Alexandr-Filatov/EVD80_MCU_PCB/DataSheets/ADC_Pins.jpeg

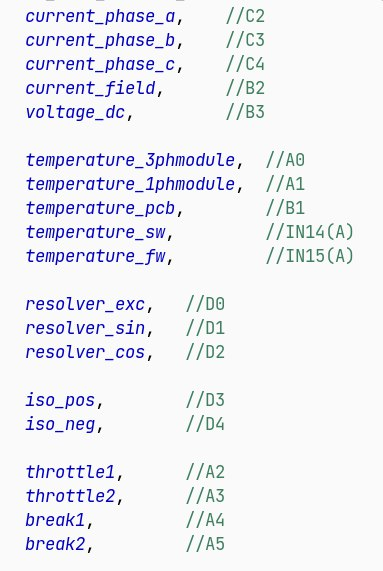
DataSheets/ADC_Pins.jpeg
