Alexandr-Filatov/EVD80_MCU_PCB/bom/EVD80_ControlBoard.xls

Reference | Value | Product Name | Replacement | Description P/N | Footprint | Qty | DNP
C1,C178 | 100n |  |  | Capacitor 50V | Capacitor_SMD:C_0805_2012Metric | 2
C2,C3,C4,C5,C6,C7,C8,C9 | 10u |  |  | Capacitor 25V | Capacitor_SMD:C_0805_2012Metric | 8
C10,C14,C22,C24,C26,C37,C39,C40,C42,C43,C44,C45,C46,C47,C48,C49,C50,C51,C52,C53,C54,C55,C56,C57,C58,C59,C60,C63,C69,C70,C74,C86,C87,C88,C98,C99,C100,C105,C106,C109,C110,C111,C112,C125,C133,C135,C136,C139,C146,C147,C150,C151,C154,C155,C158,C159,C181,C182,C187,C188,C190,C193,C194,C201,C202,C205,C206,C208,C217,C223,C224,C228 | 100n |  |  | Capacitor 50V | Capacitor_SMD:C_0603_1608Metric | 72
C11,C12,C13,C17,C103,C141,C179,C180,C207,C209 | 1u |  |  | Capacitor 25V | Capacitor_SMD:C_0603_1608Metric | 10
C15,C16,C18,C19,C20,C21,C23,C25,C27,C29,C30,C31,C32,C34,C35,C36,C38,C41,C142,C143 | 2.2u |  |  | Capacitor 25V | Capacitor_SMD:C_0603_1608Metric | 20
C28,C33,C185,C186,C191,C192 | 10u |  |  | Capacitor 25V | Capacitor_SMD:C_0603_1608Metric | 6
C61,C62 | 30p |  |  | Capacitor 50V | Capacitor_SMD:C_0805_2012Metric | 2
C64,C65,C66 | 22u |  |  | Capacitor 50V | Capacitor_Tantalum_SMD:CP_EIA-7360-38_Kemet-E | 3
C67,C115,C116,C117,C118,C119,C120,C121,C123,C126,C127,C162,C163,C164,C168,C169,C170,C174,C175,C213,C214,C257,C258,C259,C260 | 100n |  |  | Capacitor 50V | Capacitor_SMD:C_1206_3216Metric | 25
C68 | 560p |  |  | Capacitor 50V | Capacitor_SMD:C_0603_1608Metric | 1
C71,C241 | 100n |  |  | Capacitor 50V | Capacitor_SMD:C_0805_2012Metric_Pad1.18x1.45mm_HandSolder | 2
C72 | 47n |  |  | Capacitor 50V | Capacitor_SMD:C_0603_1608Metric | 1
C73 | 820p |  |  | Capacitor 50V | Capacitor_SMD:C_0603_1608Metric_Pad1.08x0.95mm_HandSolder | 1
C75,C79,C107,C108,C122,C124,C165,C166,C167,C171,C172,C173,C176,C177,C197,C198,C199,C200,C215,C216,C219,C220,C221,C222 | 10n |  |  | Capacitor 50V | Capacitor_SMD:C_0603_1608Metric | 24
C76,C77 | 1u |  |  | Capacitor 50V | Capacitor_SMD:C_0805_2012Metric_Pad1.18x1.45mm_HandSolder | 2
C78 | 100n |  |  | Capacitor 50V | Capacitor_SMD:C_0603_1608Metric_Pad1.08x0.95mm_HandSolder | 1
C80,C195,C196 | 47u |  |  | Capacitor 35V | Capacitor_Tantalum_SMD:CP_EIA-7360-38_Kemet-E | 3
C81,C82 | 0.47u |  |  | Capacitor 50V | Capacitor_SMD:C_1206_3216Metric | 2
C83,C84,C85 | 1000p |  |  | Capacitor 50V | Capacitor_SMD:C_0603_1608Metric | 3
C89,C90,C91,C92,C93,C94 | 330p |  |  | Capacitor 50V | Capacitor_SMD:C_0603_1608Metric | 6
C95,C96,C97 | 47p |  |  | Capacitor 50V | Capacitor_SMD:C_0603_1608Metric | 3
C101 | 0.1u |  |  | Capacitor 50V | Capacitor_SMD:C_0603_1608Metric | 1
C102,C203,C204,C212,C225,C226 | 4.7n |  |  | Capacitor 50V | Capacitor_SMD:C_0603_1608Metric | 6
C104 | 1n |  |  | Capacitor 50V | Capacitor_SMD:C_0603_1608Metric | 1
C113,C114,C128,C129,C132,C148,C149,C156,C157,C227 | 10p |  |  | Capacitor 50V | Capacitor_SMD:C_0603_1608Metric | 10
C130,C131,C134,C140,C152,C153,C160,C161,C183,C184,C229 | 0.22u |  |  | Capacitor 16V | Capacitor_SMD:C_0603_1608Metric | 11
C137,C138 | 4700p |  |  | Capacitor 50V | Capacitor_SMD:C_0603_1608Metric | 2
C144,C145,C218,C231,C232,C233,C235,C238,C239,C240,C255,C256 | 100p |  |  | Capacitor 50V | Capacitor_SMD:C_0603_1608Metric | 12
C189 | 4.7u |  |  | Capacitor 10V | Capacitor_SMD:C_0603_1608Metric | 1
C210,C211 | 82p |  |  | Capacitor 50V | Capacitor_SMD:C_0603_1608Metric | 2
C230,C234,C236,C237,C251,C252,C253,C254 | 27p |  |  | Capacitor 50V | Capacitor_SMD:C_0603_1608Metric | 8
D1,D2,D47,D48,D49,D50,D54 |  | FYLS-0805UBC |  | LED | LED_SMD:LED_0805_2012Metric | 7
D3 |  | SN74LVC1G11DBVR |  | SN74LVC1G11DBVR | Package_TO_SOT_SMD:SOT-23-6_Handsoldering | 1
D4,D5 |  | FYLS-0805UBC |  | LED | LED_SMD:LED_0805_2012Metric_Pad1.15x1.40mm_HandSolder | 2
D6,D8,D10,D11,D12,D20,D21,D22,D24,D25,D26,D27,D28,D29,D30,D31,D32,D33,D39,D40,D41,D42,D43,D45,D51,D52 |  | BAT54S |  | Schottky Barrier Diode | Package_TO_SOT_SMD:SOT-23 | 26
D7,D9 |  | STPS20M100S |  | Schottky Diode | Package_TO_SOT_SMD:TO-263-2 | 2
D13,D14,D15,D16,D17,D18 |  | BAV99 |  |  | Package_TO_SOT_SMD:SOT-23 | 6
D23 |  | PESD2CAN |  |  | Package_TO_SOT_SMD:SOT-23 | 1
D34,D35,D36,D37,D38 |  | SS16 |  | Schottky Diode | Diode_SMD:D_SMA | 5
D44,D46 |  | SS16 |  | Schottky Diode | Diode_SMD:D_SMA | 2
J1 |  | DS1021-2x7SF11-B |  | Connector | Connector_PinHeader_2.54mm:PinHeader_2x07_P2.54mm_Vertical | 1
J2 |  | 776163-1 |  | Connector | Project_Library:TE_776163-1 | 1
J3 |  | SCT3001WR-2x04P |  | Connector | Connector_Molex:Molex_Micro-Fit_3.0_43045-0800_2x04_P3.00mm_Horizontal | 1
J4,J5,J6,J9 |  | SCT3001WR-2x06P |  | Connector | Connector_Molex:Molex_Micro-Fit_3.0_43045-1200_2x06_P3.00mm_Horizontal | 4
J10 |  | DS1021-1x5SF11-B |  | Connector | Connector_PinHeader_2.54mm:PinHeader_1x05_P2.54mm_Vertical | 1
J11 |  | SCT3001WR-2x05P |  | Connector | Connector_Molex:Molex_Micro-Fit_3.0_43045-1000_2x05_P3.00mm_Horizontal | 1
K1,K2 |  | 1393217-1 |  | Relay | Relay_THT:Relay_SPST_Finder_32.21-x300 | 2
L1,L2 | 10u | DFE252012F-100M=P2 |  | Inductor | Inductor_SMD:L_1008_2520Metric | 2
L3,L4 | 220R | BLM18HB221SN1D |  | Inductor | Inductor_SMD:L_0603_1608Metric | 2
L5,L6 | 60R | BLM18BB600SN1D |  | Inductor | Inductor_SMD:L_0603_1608Metric | 2
L7 | 22 uH | SRP1245A |  | Inductor | Inductor_SMD:L_Bourns_SRP1245A | 1
L8,L11,L13,L14,L15,L16,L17,L18,L19,L20,L21,L22,L23,L24,L25,L26 | 1 uH | LQM21PN1R0MC0D |  | Inductor | Inductor_SMD:L_0805_2012Metric | 16
L9,L10,L12 |  | ACM2520-2P |  | Inductor | Project_Library:ACM2520-2P_TDK | 3
Q1 |  | STB35NF10 | IRF3710STRLPBF | Transistor | Package_TO_SOT_SMD:TO-263-2 | 1
Q2 |  | BC858 |  | Transistor | Package_TO_SOT_SMD:SOT-23 | 1
Q3 |  | SUD50N04 | FDD8447L | Transistor | Package_TO_SOT_SMD:TO-252-2 | 1
Q4,Q5,Q6,Q9,Q11,Q13,Q14,Q15,Q16,Q17,Q18,Q19 | BC817 | BC817 |  | Transistor | Package_TO_SOT_SMD:SOT-23 | 12
Q7,Q8,Q10,Q12 | BC807 | BC807 |  | Transistor | Package_TO_SOT_SMD:SOT-23 | 4
R1,R29,R148,R149,R150,R160,R161,R162,R170,R171,R237,R238,R239,R240,R263,R273,R275,R276 | 100 |  |  | Resistor | Resistor_SMD:R_0603_1608Metric | 18
R2,R8,R30,R39,R58,R60,R194,R195,R200,R201,R203,R213,R264,R265,R266,R270,R271,R272,R279,R281 | 1k |  |  | Resistor | Resistor_SMD:R_0603_1608Metric | 20
R3,R124,R125 | 4.99k |  |  | Resistor | Resistor_SMD:R_0603_1608Metric | 3
R4 | 150 |  |  | Resistor | Resistor_SMD:R_0805_2012Metric | 1
R5,R223,R224,R225,R226 | 680 |  |  | Resistor | Resistor_SMD:R_0805_2012Metric | 5
R6,R284 | 1k |  |  | Resistor | Resistor_SMD:R_0805_2012Metric | 2
R7,R241,R242,R245,R261,R262,R267,R268,R269,R274,R277,R278,R280 | 120 |  |  | Resistor | Resistor_SMD:R_0603_1608Metric | 13
R9,R10,R127,R128 | 0.1R |  |  | Resistor | Resistor_SMD:R_0603_1608Metric | 4
R11,R17,R19,R129,R151,R152,R153,R163,R164,R165,R172,R173 | DNP |  |  | Resistor | Resistor_SMD:R_0603_1608Metric | 12
R12,R16,R18,R92,R93,R248,R249 | 2.2k |  |  | Resistor | Resistor_SMD:R_0603_1608Metric | 7
R13,R14,R26,R61,R77,R78,R79,R80,R202 | 4.7k |  |  | Resistor | Resistor_SMD:R_0603_1608Metric | 9
R15 | 1M |  |  | Resistor | Resistor_SMD:R_0805_2012Metric | 1
R20 | 4.7k |  |  | Resistor | Resistor_SMD:R_0805_2012Metric_Pad1.20x1.40mm_HandSolder | 1
R21 | 36k |  |  | Resistor | Resistor_SMD:R_0603_1608Metric | 1
R22 | 7.5k |  |  | Resistor | Resistor_SMD:R_0603_1608Metric | 1
R23 | 3k |  |  | Resistor | Resistor_SMD:R_0805_2012Metric_Pad1.20x1.40mm_HandSolder | 1
R24 | 18.7k |  |  | Resistor | Resistor_SMD:R_0603_1608Metric | 1
R25 | 300k |  |  | Resistor | Resistor_SMD:R_0603_1608Metric | 1
R27 | 13k |  |  | Resistor | Resistor_SMD:R_0603_1608Metric | 1
R28 | 1M |  |  | Resistor | Resistor_SMD:R_0603_1608Metric | 1
R31,R196,R197 | 11k |  |  | Resistor | Resistor_SMD:R_0603_1608Metric | 3
R32 | 200 |  |  | Resistor | Resistor_SMD:R_0603_1608Metric | 1
R33,R43,R44,R45,R48,R49,R50,R51,R52,R53,R54,R62,R63,R66,R68,R71,R72,R73,R74,R98,R100,R104,R130,R132,R136,R138,R192,R193,R204,R205,R212,R214,R215,R222,R256 | 10k |  |  | Resistor | Resistor_SMD:R_0603_1608Metric | 35
R34,R59,R65 | 3.9k |  |  | Resistor | Resistor_SMD:R_0603_1608Metric | 3
R35 | 20 mOm |  |  | Resistor | Resistor_SMD:R_2512_6332Metric | 1
R36,R40,R41,R42 | 2k |  |  | Resistor | Resistor_SMD:R_0603_1608Metric | 4
R37,R38 | 510 |  |  | Resistor | Resistor_SMD:R_0603_1608Metric | 2
R46,R47 | 100k |  |  | Resistor | Resistor_SMD:R_0603_1608Metric | 2
R55,R56,R57 | 47k |  |  | Resistor | Resistor_SMD:R_0603_1608Metric | 3
R64,R131,R133,R137,R139 | 15k |  |  | Resistor | Resistor_SMD:R_0603_1608Metric | 5
R67 | 20 |  |  | Resistor | Resistor_SMD:R_0603_1608Metric | 1
R69,R70 | 51k |  |  | Resistor | Resistor_SMD:R_0603_1608Metric | 2
R75,R76 | 510k |  |  | Resistor | Resistor_SMD:R_0603_1608Metric | 2
R81,R82,R83,R84 | 10 |  |  | Resistor | Resistor_SMD:R_0603_1608Metric | 4
R85,R86,R87,R88,R89,R90,R91,R94,R96,R97,R246,R247,R260,R282,R283,R305 | DNP |  |  | Resistor | Resistor_SMD:R_0805_2012Metric | 16
R95,R106,R107,R109,R250,R251,R252,R253 | 30.1k |  |  | Resistor | Resistor_SMD:R_0603_1608Metric | 8
R99,R101,R105,R257 | 16k |  |  | Resistor | Resistor_SMD:R_0603_1608Metric | 4
R102,R103,R108,R126,R134,R135,R140,R141,R198,R199,R227,R228,R254,R255,R258 | 49.9 |  |  | Resistor | Resistor_SMD:R_0603_1608Metric | 15
R110,R111,R112,R113,R114,R115,R116,R117,R118,R119,R120,R121 | 249k |  |  | Resistor | Resistor_SMD:R_1206_3216Metric | 12
R122,R123 | 3.74k |  |  | Resistor | Resistor_SMD:R_0603_1608Metric | 2
R142,R144,R146,R154,R156,R158,R166,R168 | 4.99k |  |  | Resistor | Resistor_SMD:R_0805_2012Metric | 8
R143,R145,R147,R155,R157,R159,R167,R169 | 3k |  |  | Resistor | Resistor_SMD:R_0805_2012Metric | 8
R174,R175,R183,R184,R185 | 4.7k |  |  | Resistor | Resistor_SMD:R_0805_2012Metric | 5
R176,R177,R182,R186,R187,R188 | 10K |  |  | Resistor | Resistor_SMD:R_0805_2012Metric | 6
R178 | 510 |  |  | Resistor | Resistor_SMD:R_0805_2012Metric | 1
R179 | 330 |  |  | Resistor | Resistor_SMD:R_0805_2012Metric | 1
R180,R181,R189,R190,R191 | 220 |  |  | Resistor | Resistor_SMD:R_0805_2012Metric | 5
R206,R216 | 5.11k |  |  | Resistor | Resistor_SMD:R_0603_1608Metric | 2
R207,R208,R209,R210,R211,R217,R218,R219,R220,R221 | 240k |  |  | Resistor | Resistor_SMD:R_1206_3216Metric | 10
R229,R230,R231,R232,R233,R234,R235,R236 | 560 |  |  | Resistor | Resistor_SMD:R_0603_1608Metric | 8
R243,R244 | 59 |  |  | Resistor | Resistor_SMD:R_0603_1608Metric | 2
R259,R285,R286,R287,R288,R289,R290,R291,R292,R293,R294,R295,R296,R297,R298,R299,R300,R301,R302,R303,R304 | 0 |  |  | Resistor | Resistor_SMD:R_0603_1608Metric | 21
TH1 |  | NCP21XV103J03RA |  | NTC | Resistor_SMD:R_0805_2012Metric | 1
U1 |  | LD1117S12TR_SOT223 |  | Linear regulator | Package_TO_SOT_SMD:SOT-223-3_TabPin2 | 1
U2 |  | R-78E3.3-1.0 |  | DCDC | Converter_DCDC:Converter_DCDC_RECOM_R-78E-0.5_THT | 1
U3 |  | R-78E5.0-1.0 |  | DCDC | Converter_DCDC:Converter_DCDC_RECOM_R-78E-0.5_THT | 1
U4,U12 |  | TL431BQDBZR |  | Linear regulator | Package_TO_SOT_SMD:SOT-23 | 2
U5 |  | LMV324 |  | Operational Amplifier |  | 1
U6,U33 |  | 74HC123 |  | Monostable multivibrator | Package_SO:SO-16_3.9x9.9mm_P1.27mm | 2
U7 |  | TMS320F28379DPTPQ |  | uController | Project_Library:TMS320F28377DPTPQ | 1
U8 |  | M24512 |  | EEPROM | Package_SO:SO-8_3.9x4.9mm_P1.27mm | 1
U9 |  | MAX809 |  | Microprocessor Reset Circuits | Package_TO_SOT_SMD:SOT-23 | 1
U10 |  | LMV321RILT |  | Operational Amplifier | Package_TO_SOT_SMD:SOT-23-5 | 1
U11 |  | LM25118 |  | DCDC | Package_SO:HTSSOP-20-1EP_4.4x6.5mm_P0.65mm_EP2.85x4mm | 1
U13,U14,U15,U17,U28,U31,U32,U34,U35,U36,U37,U38,U39,U40,U41,U56,U57,U59,U60,U61,U62,U63,U70,U71,U72 |  | LMV321ILT |  | Operational Amplifier | Package_TO_SOT_SMD:SOT-23-5 | 25
U16,U58 |  | TLV431 |  | Linear regulator | Package_TO_SOT_SMD:SOT-23 | 2
U18,U19 |  | LM321 |  | Operational Amplifier | Package_TO_SOT_SMD:SOT-23-5 | 2
U20,U21,U22,U23,U24,U25,U26,U27,U29,U30,U66,U67,U73,U74,U75,U76 |  | ADM3485 |  | RS485 | Package_SO:SOIC-8_3.9x4.9mm_P1.27mm | 16
U42,U43,U44,U45,U46,U47,U48,U49 |  | ACPL-M21L |  | Digital CMOS Optocoupler | Package_SO:SO-5_4.4x3.6mm_P1.27mm | 8
U50 |  | ACPL-M50L |  | Digital CMOS Optocoupler | Package_SO:SO-5_4.4x3.6mm_P1.27mm | 1
U51,U52,U53,U54,U55 |  | PVG612 |  | Photovoltaic Relay | Package_DIP:DIP-6_W8.89mm_SMDSocket_LongPads | 5
U64 |  | 74HC4051 |  | 8-channel analog multiplexer/demultiplexer, DIP-16/SOIC-16/TSSOP-16 | Package_SO:SOIC-16_3.9x9.9mm_P1.27mm | 1
U65 |  | TD541SCANH |  | CAN | Project_Library:DFN-20-1EP_5x6mm_P1.27mm_10x13mm | 1
Y1 | 10 MHz | HC-49SM |  | SMD Crystal | MyLibrary:Crystal_SMD_HC49-SM | 1
