Alexandr-Filatov/EVD80_MCU_PCB/(list of files, cad)

Other CAD files:
Docs/НВЦТ.EVP150-2-1.3000.100.dwg
