Alexandr-Filatov/EVD80_MCU_PCB/Docs/НВЦТ.EVP150-2-1.3000.100.pdf

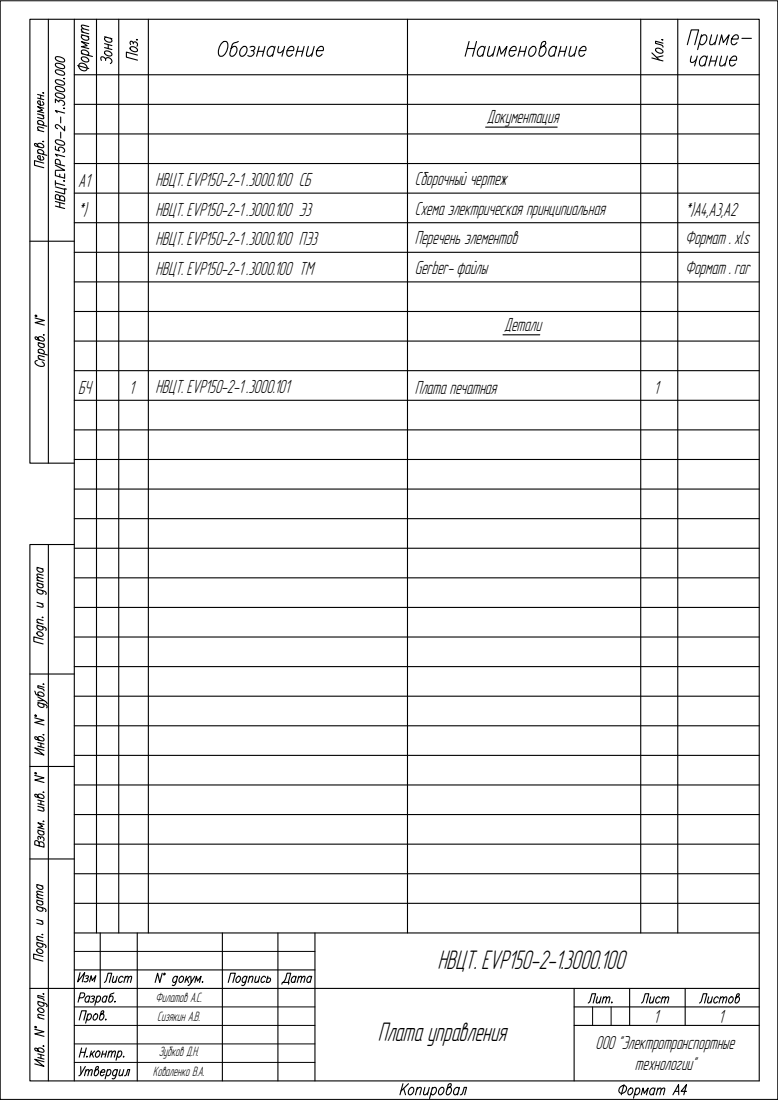
[picture p2: page 1]
НВЦТ. EVP150-2-1 .3000.100 ТМ; Gerber- файлы; Формат . rar; Формат . xls; НВЦТ. EVP150-2-1 .3000.101; Плата печатная; НВЦТ. EVP150-2-1.3000.100; Филатов А.С. Сизякин А.В.

А1 | НВЦТ. EVP150-2-1 .3000.100 СБ | Сборочный чертеж
*) | НВЦТ. EVP150-2-1 .3000.100 Э3 | Схема электрическая принципиальная

НВЦТ. EVP150-2-1 .3000.100 ПЭ3 | Перечень элементов

Зубков Д.Н.
Коваленко В.А.
