Alexandr-Filatov/EVD80_MCU_PCB/Docs/НВЦТ.EVP150-2-1.3000.100 СБ.pdf

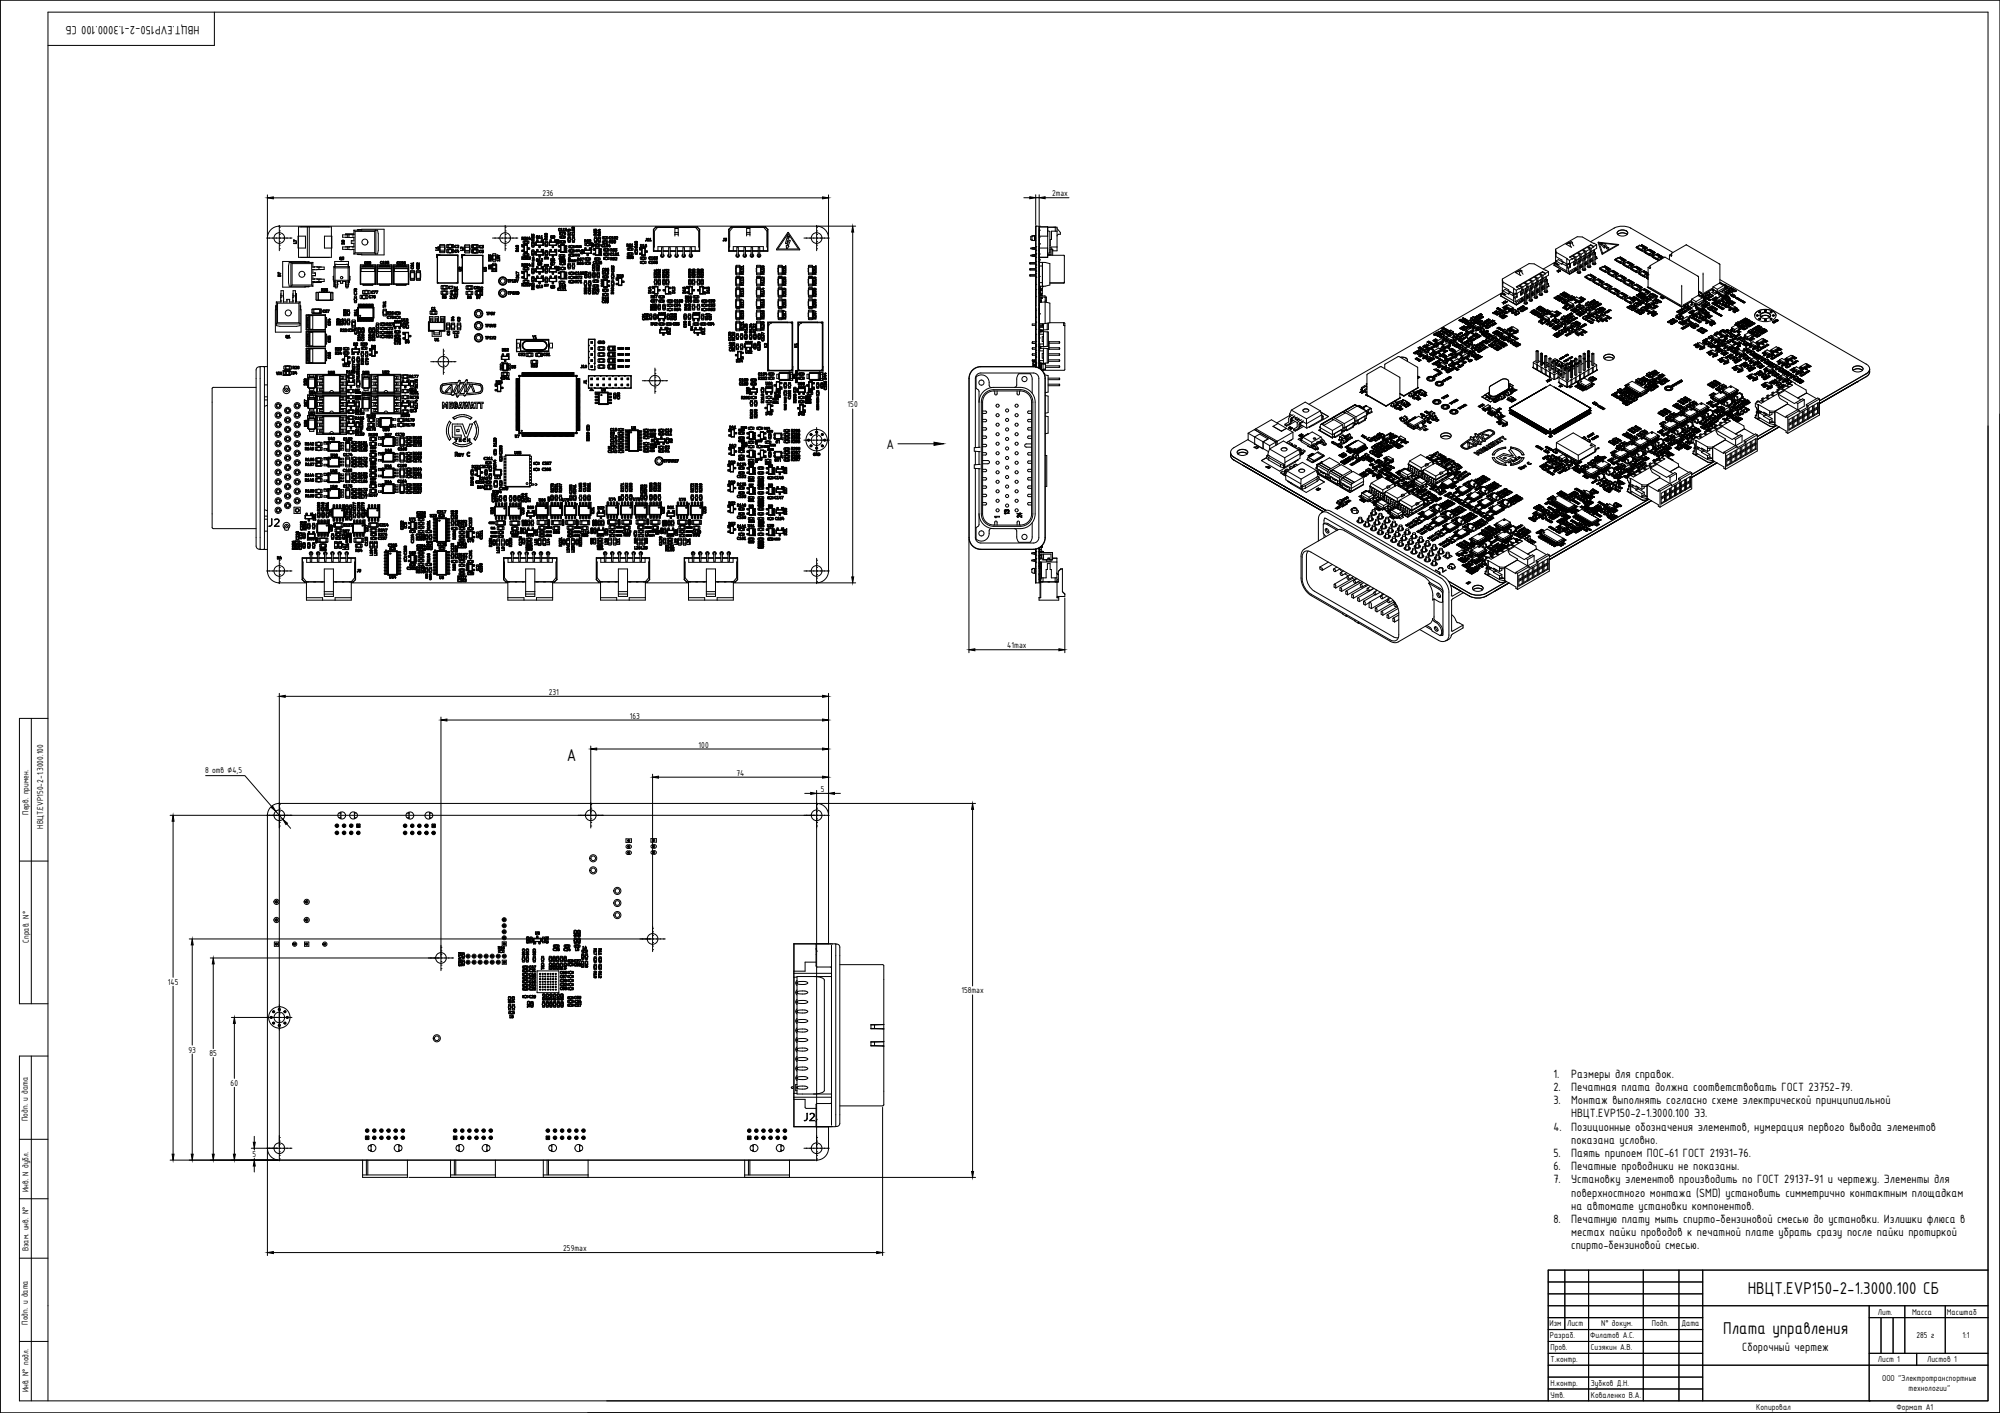
[picture p3: page 1]
Копировал; Формат А1; технологии" 285 г Инв. N° подл. Перв. примен. Подп. и дата Взам. инв. N° Подп. и дата Инв. N дубл. Справ. N°; НВЦТ.EVP150-2-1.3000.100; 8 отв ∅4,5

1. Размеры для справок. 2. Печатная плата должна соответствовать ГОСТ 23752-79.

3. Монтаж выполнять согласно схеме электрической принципиальной
НВЦТ.EVP150-2-1.3000.100 Э3.
4. Позиционные обозначения элементов, нумерация первого вывода элементов
показана условно. 5. Паять припоем ПОС-61 ГОСТ 21931-76.

6. Печатные проводники не показаны. 7. Установку элементов производить по ГОСТ 29137-91 и чертежу. Элементы для

поверхностного монтажа (SMD) установить симметрично контактным площадкам
на автомате установки компонентов. 8. Печатную плату мыть спирто-бензиновой смесью до установки. Излишки флюса в

местах пайки проводов к печатной плате убрать сразу после пайки протиркой

спирто-бензиновой смесью. Пров. | | | | НВЦТ.EVP150-2-1.3000.100 СБ

Плата управления Сборочный чертеж | Лит. | Масса | Масштаб

Изм | Лист | N° докум. | Подп. | Дата | | | | | 1:1
Разраб. | | Филатов А.С.

Сизякин А.В.

Т.контр. | | | | | Лист 1 | Листов 1

ООО "Электротранспортные

Н.контр. | Зубков Д.Н.
Утв. | Коваленко В.А.
