Alexandr-Filatov/EVD80_MCU_PCB/Docs/EVD80_ControlBoard-Нижняя_сторона.pdf

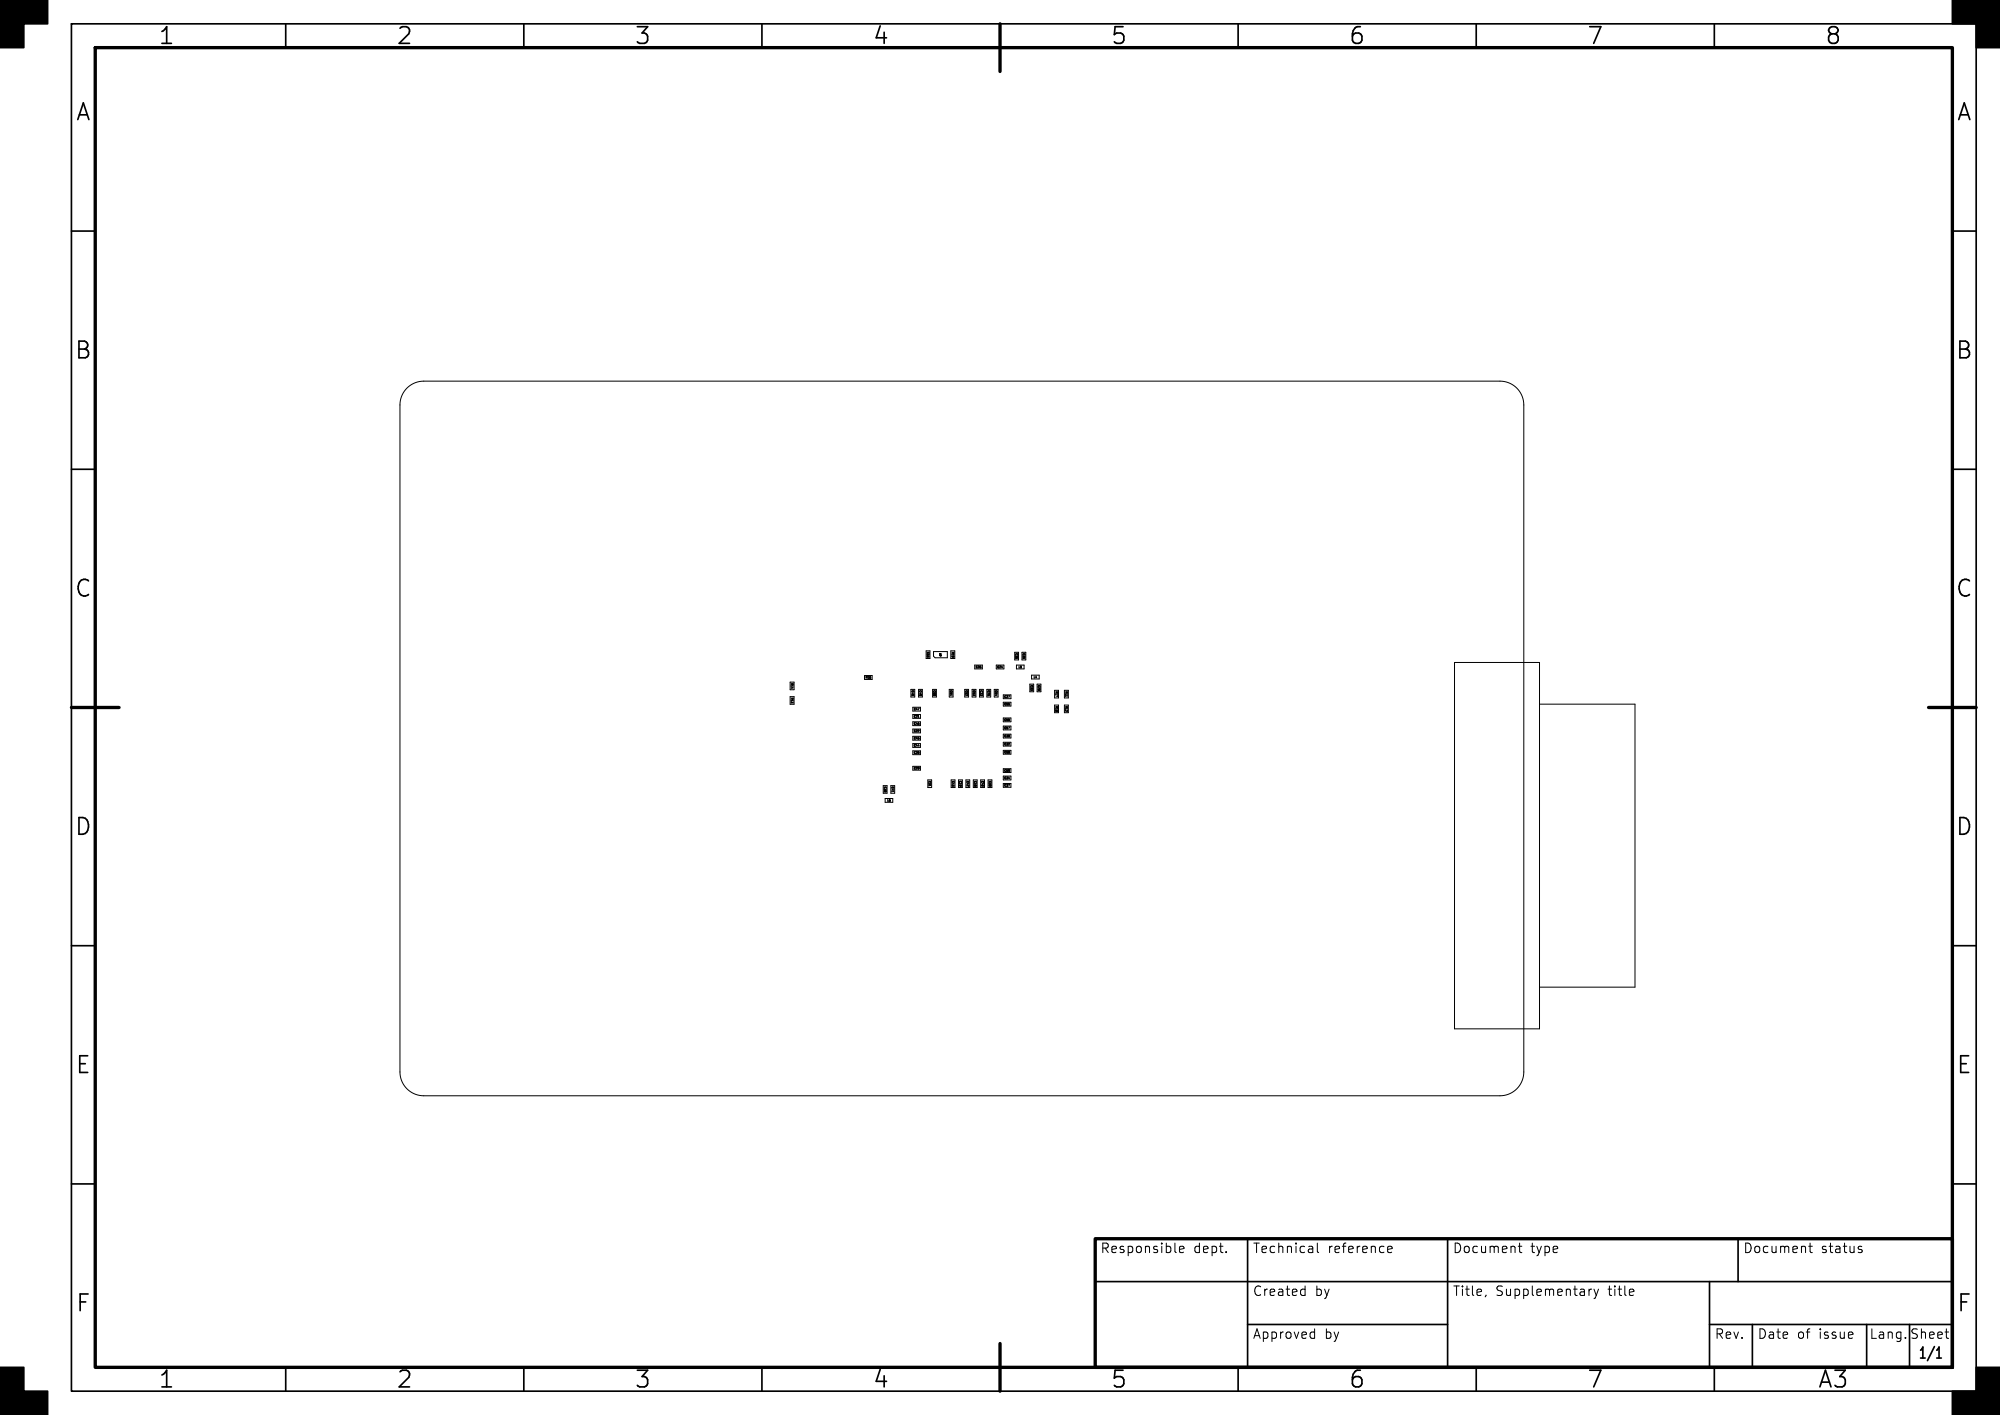
[picture p4: page 1]
