Alexandr-Filatov/EVD80_MCU_PCB/Docs/EVD80_ControlBoard_Верхняя_сторона.pdf

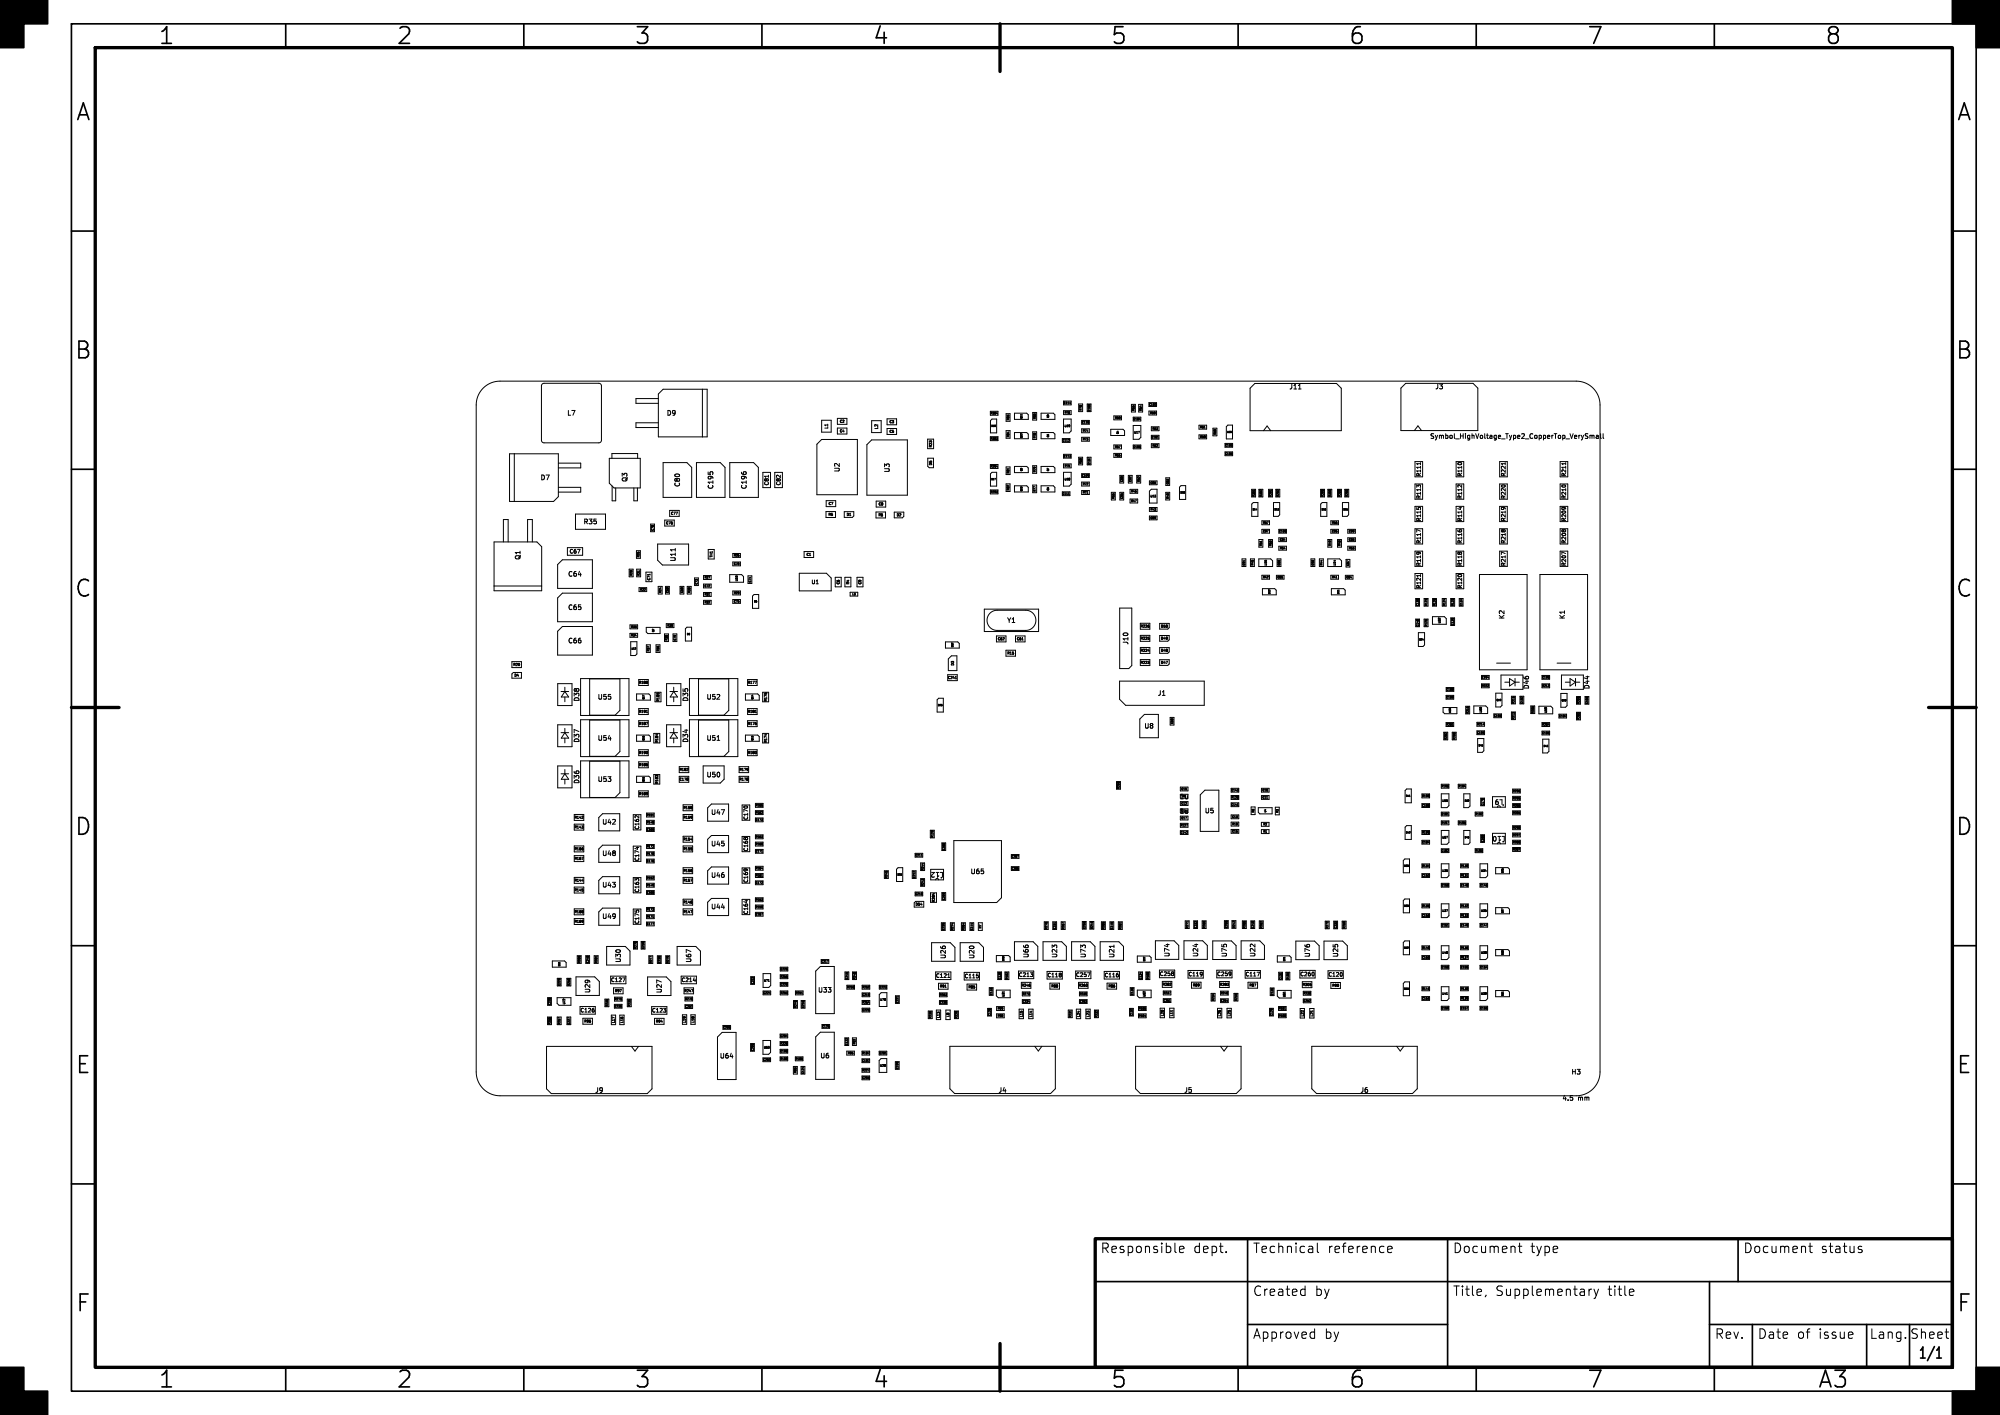
[picture p5: page 1]
