Alexandr-Filatov/EVD80_MCU_PCB/AnalogInputs.kicad_sch

## KiCad design AnalogInputs.kicad_sch (2025-07-10)

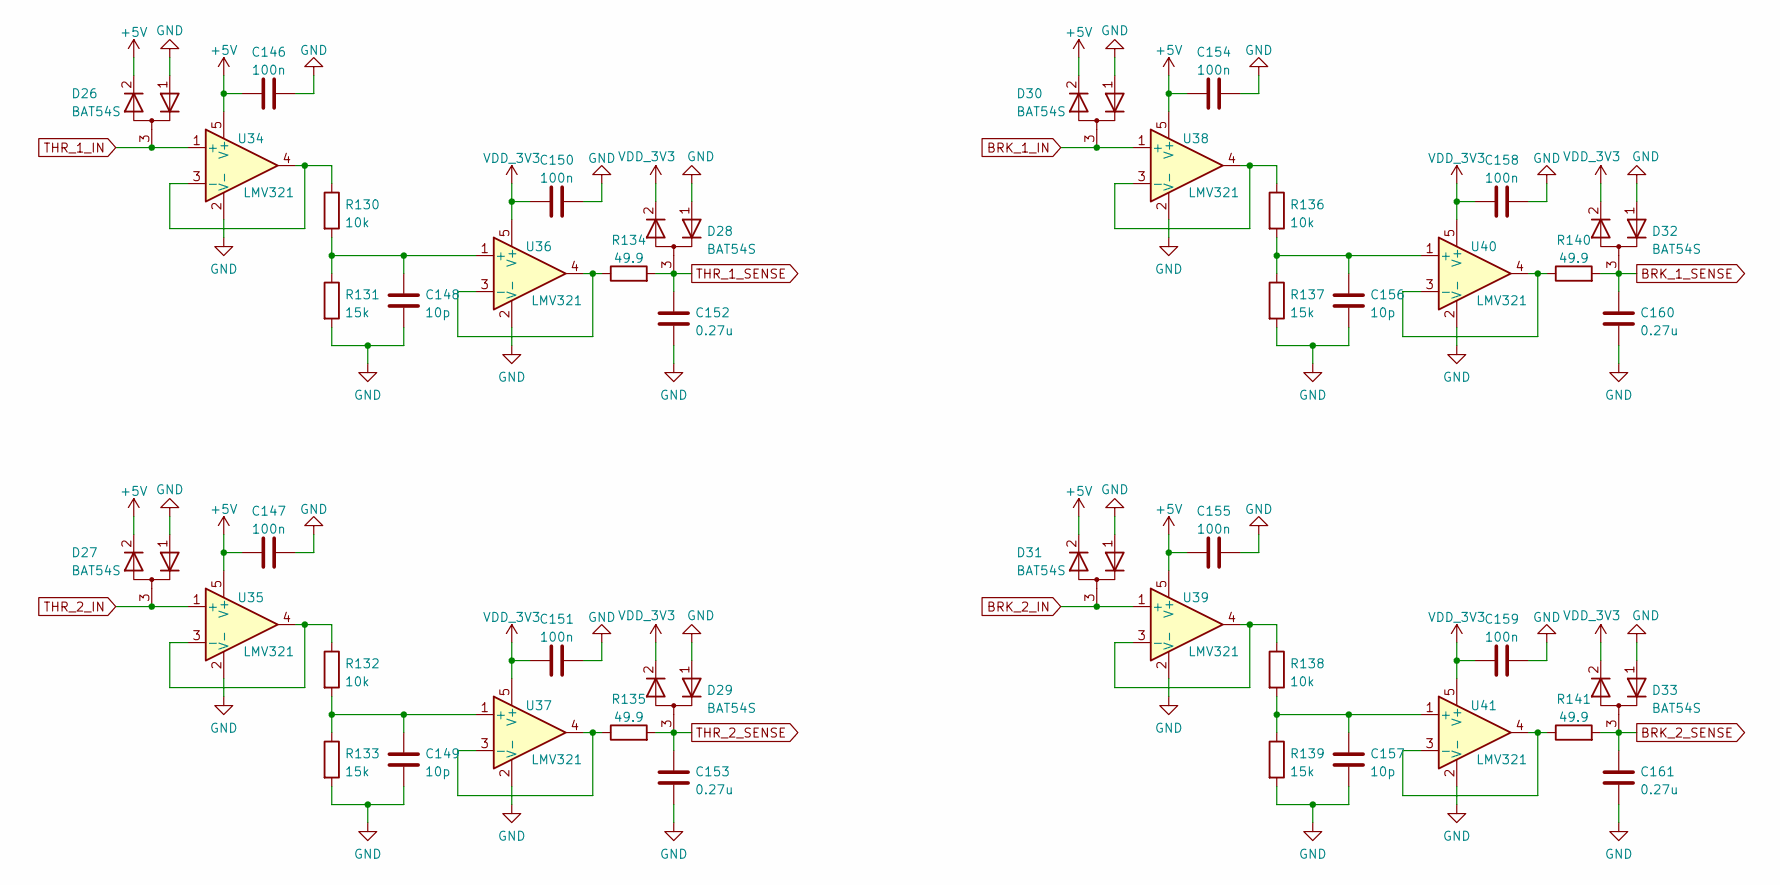
[picture p6: schematic AnalogInputs.kicad_sch]

Parts:
C146, C147, C150, C151, C154, C155, C158, C159: 100n; C_0603_1608Metric
C148, C149, C156, C157: 10p; C_0603_1608Metric
C152, C153, C160, C161: 0.27u; C_0603_1608Metric
D26, D27, D28, D29, D30, D31, D32, D33: BAT54S; SOT-23
R130, R132, R136, R138: 10k; R_0603_1608Metric
R131, R133, R137, R139: 15k; R_0603_1608Metric
R134, R135, R140, R141: 49.9; R_0603_1608Metric
U34, U35, U36, U37, U38, U39, U40, U41: LMV321; SOT-23-5

Connections:
+5V: C146.1, C147.1, C154.1, C155.1, D26.2 (K), D27.2 (K), D30.2 (K), D31.2 (K), U34.5 (V+), U35.5 (V+), U38.5 (V+), U39.5 (V+)
BRK_1_IN: D30.3 (A), U38.1 (+)
BRK_1_SENSE: C160.1, D32.3 (A), R140.2
BRK_2_IN: D31.3 (A), U39.1 (+)
BRK_2_SENSE: C161.1, D33.3 (A), R141.2
GND: C146.2, C147.2, C148.2, C149.2, C150.2, C151.2, C152.2, C153.2, C154.2, C155.2, C156.2, C157.2, C158.2, C159.2, C160.2, C161.2, D26.1 (K), D27.1 (K), D28.1 (K), D29.1 (K), D30.1 (K), D31.1 (K), D32.1 (K), D33.1 (K), R131.2, R133.2, R137.2, R139.2, U34.2 (V-), U35.2 (V-), U36.2 (V-), U37.2 (V-), U38.2 (V-), U39.2 (V-), U40.2 (V-), U41.2 (V-)
unnamed: C148.1, R130.2, R131.1, U36.1 (+)
unnamed: C149.1, R132.2, R133.1, U37.1 (+)
unnamed: C156.1, R136.2, R137.1, U40.1 (+)
unnamed: C157.1, R138.2, R139.1, U41.1 (+)
unnamed: R130.1, U34.3 (-), U34.4
unnamed: R132.1, U35.3 (-), U35.4
unnamed: R134.1, U36.3 (-), U36.4
unnamed: R135.1, U37.3 (-), U37.4
unnamed: R136.1, U38.3 (-), U38.4
unnamed: R138.1, U39.3 (-), U39.4
unnamed: R140.1, U40.3 (-), U40.4
unnamed: R141.1, U41.3 (-), U41.4
THR_1_IN: D26.3 (A), U34.1 (+)
THR_1_SENSE: C152.1, D28.3 (A), R134.2
THR_2_IN: D27.3 (A), U35.1 (+)
THR_2_SENSE: C153.1, D29.3 (A), R135.2
VDD_3V3: C150.1, C151.1, C158.1, C159.1, D28.2 (K), D29.2 (K), D32.2 (K), D33.2 (K), U36.5 (V+), U37.5 (V+), U40.5 (V+), U41.5 (V+)
