Alexandr-Filatov/EVD80_MCU_PCB/Can.kicad_sch

## KiCad design Can.kicad_sch (2025-07-10)

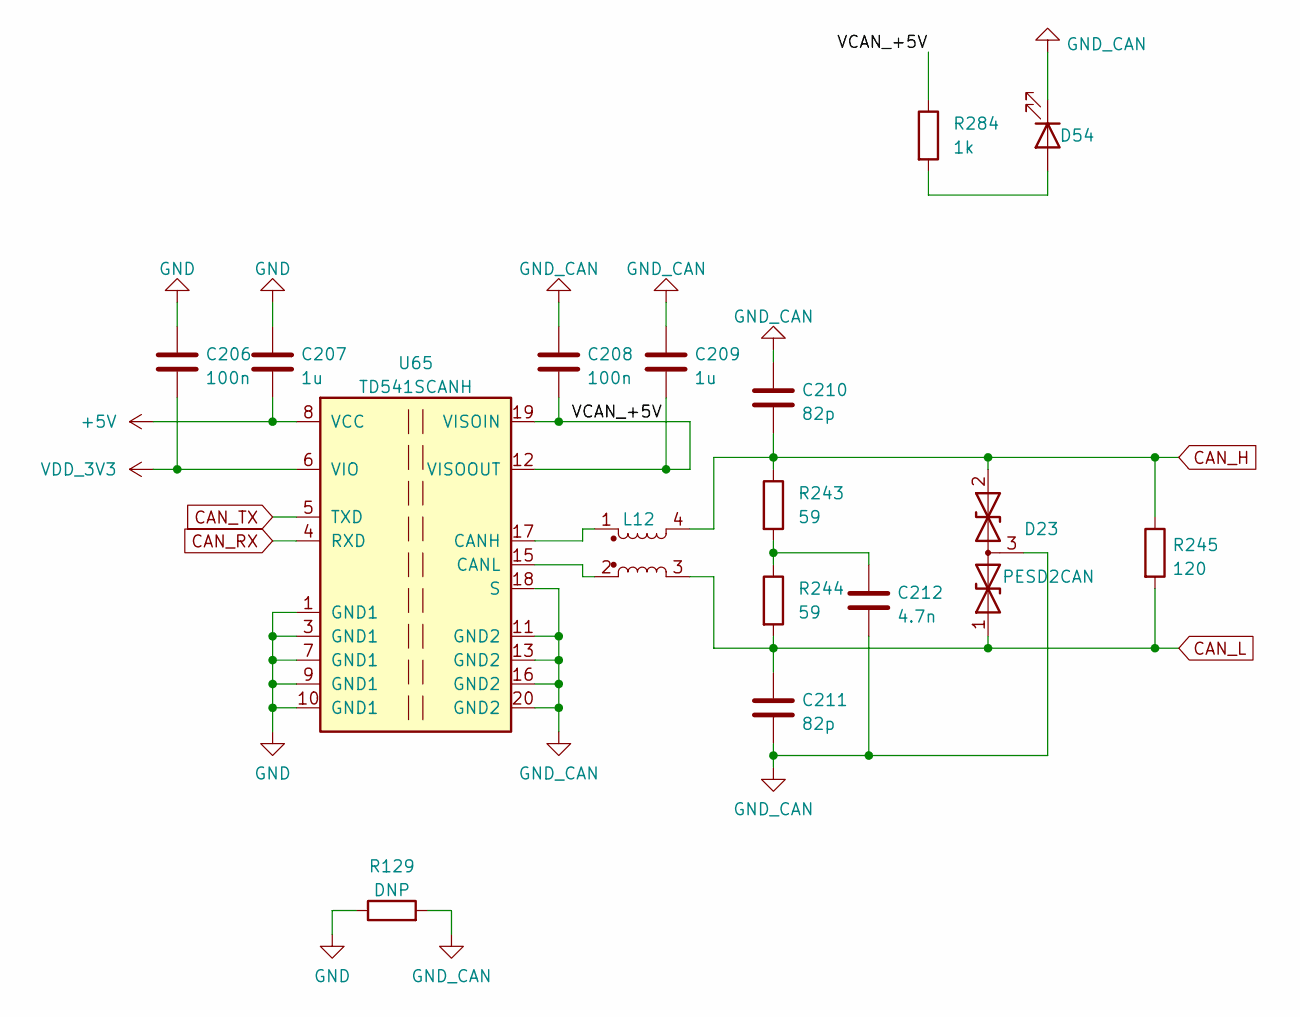
[picture p7: schematic Can.kicad_sch]

Parts:
C206, C208: 100n; C_0603_1608Metric
C207, C209: 1u; C_0603_1608Metric
C210, C211: 82p; C_0603_1608Metric
C212: 4.7n; C_0603_1608Metric
D23: PESD2CAN; SOT-23
D54: LED; LED_0805_2012Metric
L12: DR331-513AE; ACM2520-2P_TDK
R129: DNP; R_0603_1608Metric
R243, R244: 59; R_0603_1608Metric
R245: 120; R_0603_1608Metric
R284: 1k; R_0805_2012Metric
U65: TD541SCANH; DFN-20-1EP_5x6mm_P1.27mm_10x13mm

Connections:
+5V: C207.2, U65.8 (VCC)
CAN_H: C210.2, D23.2 (A2), L12.4, R243.1, R245.1
CAN_L: C211.1, D23.1 (A1), L12.3, R244.2, R245.2
CAN_RX: U65.4 (RXD)
CAN_TX: U65.5 (TXD)
GND: C206.1, C207.1, R129.1, U65.1 (GND1), U65.3 (GND1), U65.7 (GND1), U65.9 (GND1), U65.10 (GND1)
GND_CAN: C208.1, C209.1, C210.1, C211.2, C212.2, D23.3 (common), D54.1 (K), R129.2, U65.11 (GND2), U65.13 (GND2), U65.16 (GND2), U65.18 (S), U65.20 (GND2)
unnamed: C212.1, R243.2, R244.1
unnamed: D54.2 (A), R284.2
unnamed: L12.1, U65.17 (CANH)
unnamed: L12.2, U65.15 (CANL)
VCAN_+5V: C208.2, C209.2, R284.1, U65.12 (VISOOUT), U65.19 (VISOIN)
VDD_3V3: C206.2, U65.6 (VIO)
