Alexandr-Filatov/EVD80_MCU_PCB/CurrentMeas.kicad_sch

## KiCad design CurrentMeas.kicad_sch (2025-07-10)

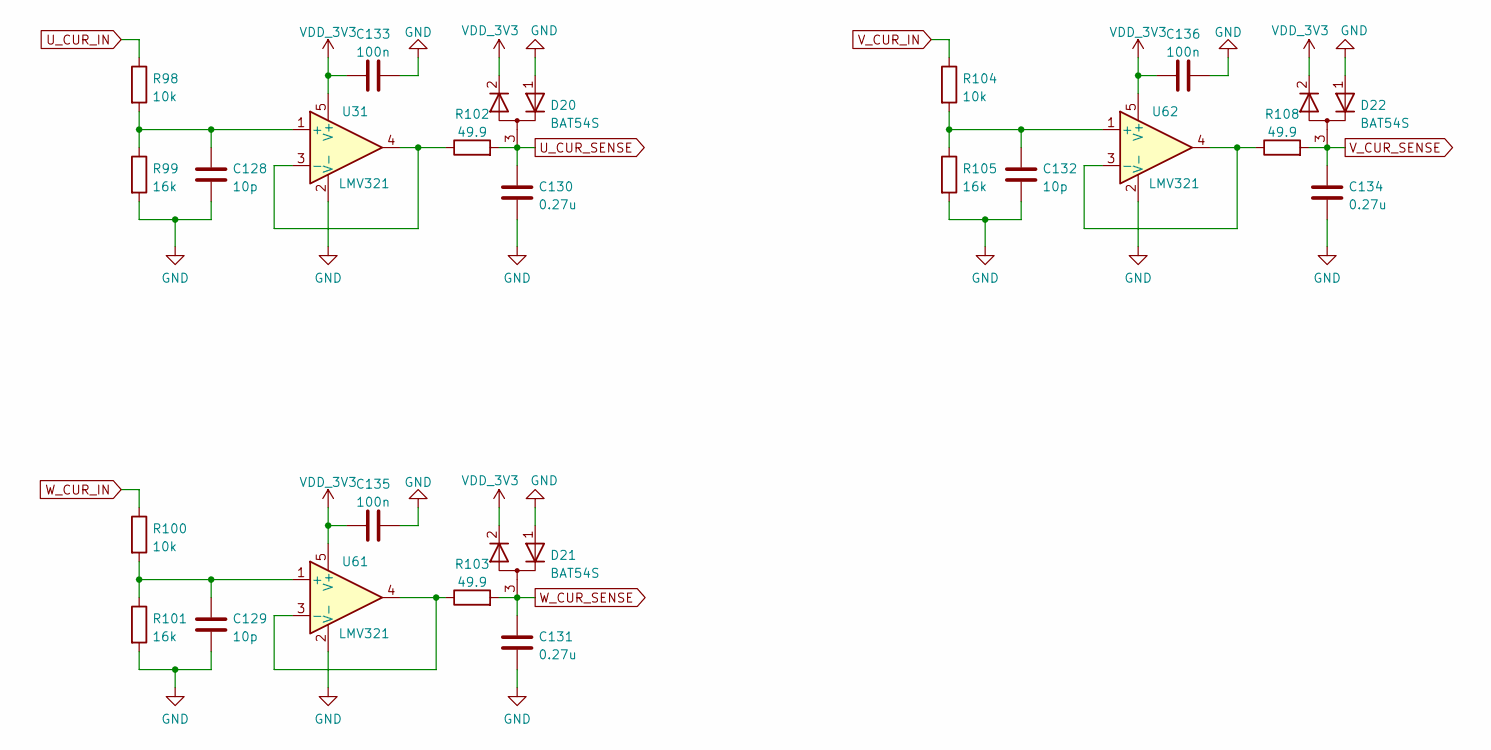
[picture p8: schematic CurrentMeas.kicad_sch]

Parts:
C128, C129, C132: 10p; C_0603_1608Metric
C130, C131, C134: 0.27u; C_0603_1608Metric
C133, C135, C136: 100n; C_0603_1608Metric
D20, D21, D22: BAT54S; SOT-23
R98, R100, R104: 10k; R_0603_1608Metric
R99, R101, R105: 16k; R_0603_1608Metric
R102, R103, R108: 49.9; R_0603_1608Metric
U31, U61, U62: LMV321; SOT-23-5

Connections:
GND: C128.2, C129.2, C130.2, C131.2, C132.2, C133.2, C134.2, C135.2, C136.2, D20.1 (K), D21.1 (K), D22.1 (K), R99.2, R101.2, R105.2, U31.2 (V-), U61.2 (V-), U62.2 (V-)
unnamed: C128.1, R98.2, R99.1, U31.1 (+)
unnamed: C129.1, R100.2, R101.1, U61.1 (+)
unnamed: C132.1, R104.2, R105.1, U62.1 (+)
unnamed: R102.1, U31.3 (-), U31.4
unnamed: R103.1, U61.3 (-), U61.4
unnamed: R108.1, U62.3 (-), U62.4
U_CUR_IN: R98.1
U_CUR_SENSE: C130.1, D20.3 (A), R102.2
VDD_3V3: C133.1, C135.1, C136.1, D20.2 (K), D21.2 (K), D22.2 (K), U31.5 (V+), U61.5 (V+), U62.5 (V+)
V_CUR_IN: R104.1
V_CUR_SENSE: C134.1, D22.3 (A), R108.2
W_CUR_IN: R100.1
W_CUR_SENSE: C131.1, D21.3 (A), R103.2
