Alexandr-Filatov/EVD80_MCU_PCB/DiscreteInputs.kicad_sch

## KiCad design DiscreteInputs.kicad_sch (2025-07-10)

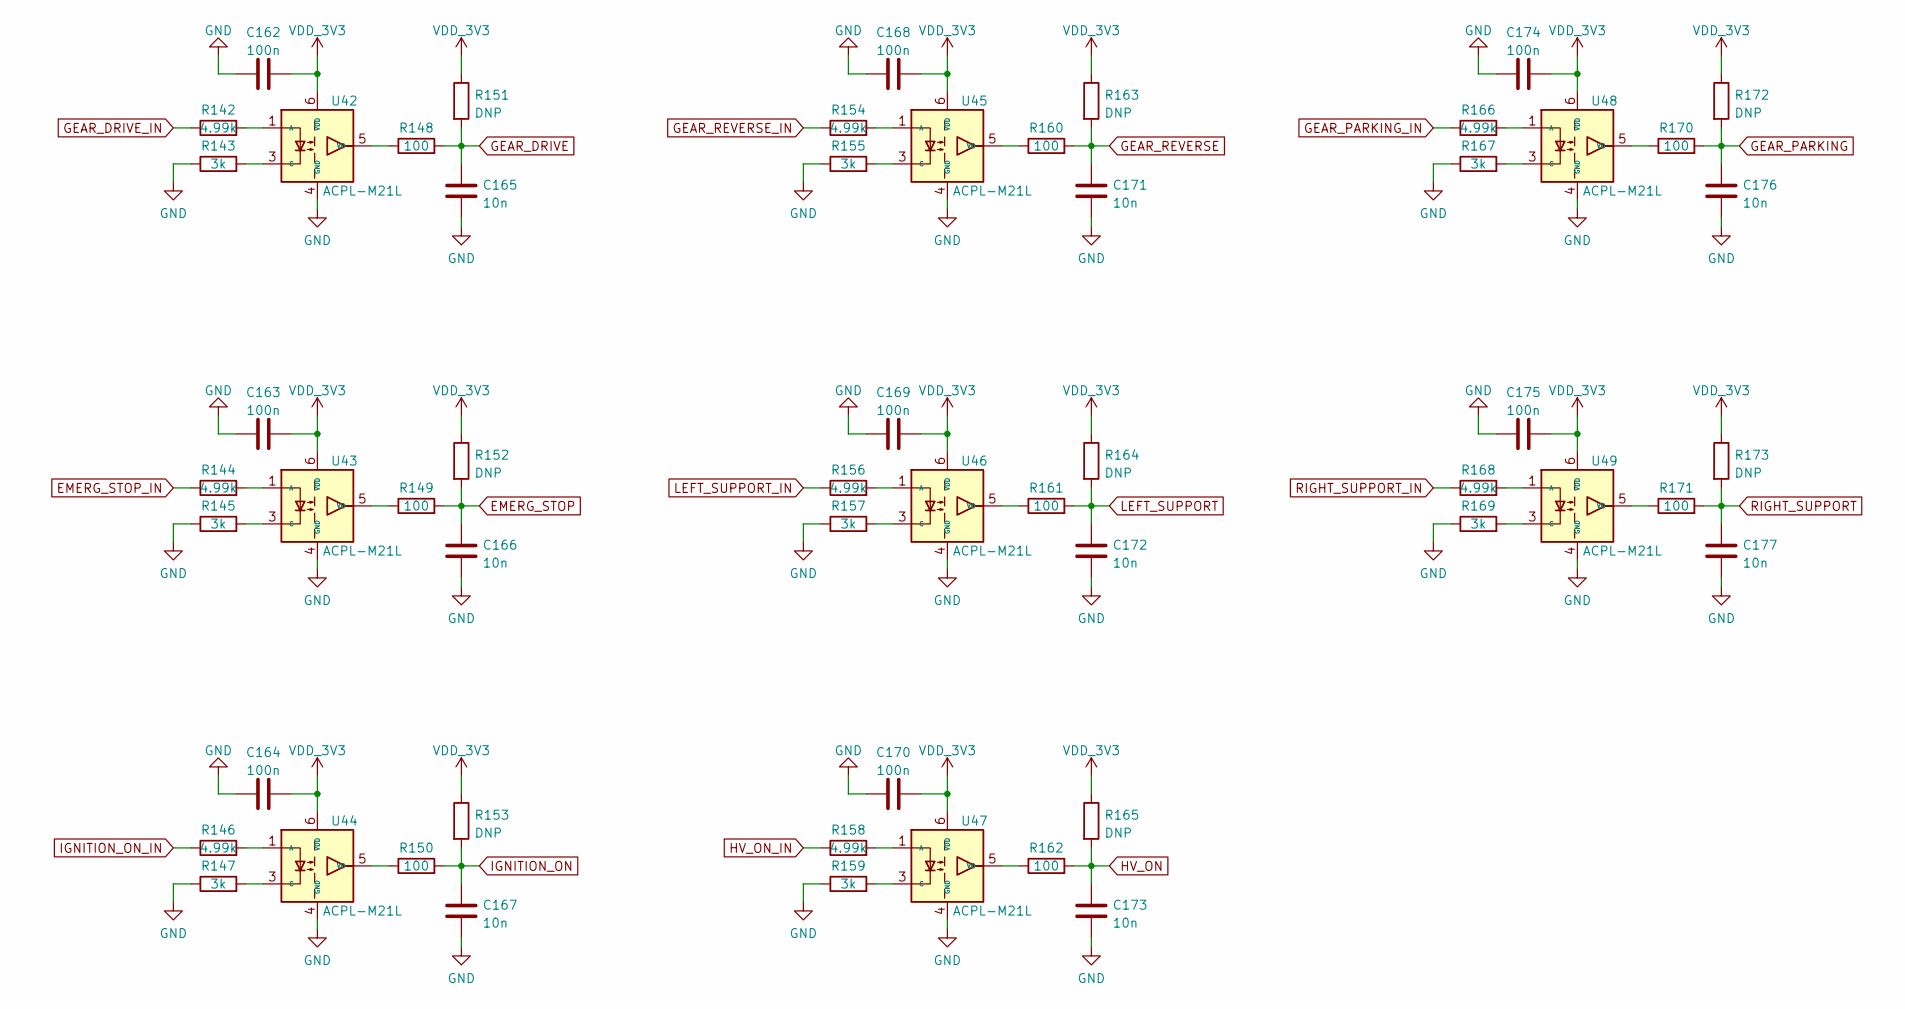
[picture p9: schematic DiscreteInputs.kicad_sch]

Parts:
C162, C163, C164, C168, C169, C170, C174, C175: 100n; C_1206_3216Metric
C165, C166, C167, C171, C172, C173, C176, C177: 10n; C_0603_1608Metric
R142, R144, R146, R154, R156, R158, R166, R168: 4.99k; R_0805_2012Metric
R143, R145, R147, R155, R157, R159, R167, R169: 3k; R_0805_2012Metric
R148, R149, R150, R160, R161, R162, R170, R171: 100; R_0603_1608Metric
R151, R152, R153, R163, R164, R165, R172, R173: DNP; R_0603_1608Metric
U42, U43, U44, U45, U46, U47, U48, U49: ACPL-M21L; SO-5_4.4x3.6mm_P1.27mm

Connections:
EMERG_STOP: C166.1, R149.2, R152.2
EMERG_STOP_IN: R144.1
GEAR_DRIVE: C165.1, R148.2, R151.2
GEAR_DRIVE_IN: R142.1
GEAR_PARKING: C176.1, R170.2, R172.2
GEAR_PARKING_IN: R166.1
GEAR_REVERSE: C171.1, R160.2, R163.2
GEAR_REVERSE_IN: R154.1
GND: C162.1, C163.1, C164.1, C165.2, C166.2, C167.2, C168.1, C169.1, C170.1, C171.2, C172.2, C173.2, C174.1, C175.1, C176.2, C177.2, R143.1, R145.1, R147.1, R155.1, R157.1, R159.1, R167.1, R169.1, U42.4 (GND), U43.4 (GND), U44.4 (GND), U45.4 (GND), U46.4 (GND), U47.4 (GND), U48.4 (GND), U49.4 (GND)
HV_ON: C173.1, R162.2, R165.2
HV_ON_IN: R158.1
IGNITION_ON: C167.1, R150.2, R153.2
IGNITION_ON_IN: R146.1
LEFT_SUPPORT: C172.1, R161.2, R164.2
LEFT_SUPPORT_IN: R156.1
unnamed: R142.2, U42.1 (A)
unnamed: R143.2, U42.3 (C)
unnamed: R144.2, U43.1 (A)
unnamed: R145.2, U43.3 (C)
unnamed: R146.2, U44.1 (A)
unnamed: R147.2, U44.3 (C)
unnamed: R148.1, U42.5 (VO)
unnamed: R149.1, U43.5 (VO)
unnamed: R150.1, U44.5 (VO)
unnamed: R154.2, U45.1 (A)
unnamed: R155.2, U45.3 (C)
unnamed: R156.2, U46.1 (A)
unnamed: R157.2, U46.3 (C)
unnamed: R158.2, U47.1 (A)
unnamed: R159.2, U47.3 (C)
unnamed: R160.1, U45.5 (VO)
unnamed: R161.1, U46.5 (VO)
unnamed: R162.1, U47.5 (VO)
unnamed: R166.2, U48.1 (A)
unnamed: R167.2, U48.3 (C)
unnamed: R168.2, U49.1 (A)
unnamed: R169.2, U49.3 (C)
unnamed: R170.1, U48.5 (VO)
unnamed: R171.1, U49.5 (VO)
RIGHT_SUPPORT: C177.1, R171.2, R173.2
RIGHT_SUPPORT_IN: R168.1
VDD_3V3: C162.2, C163.2, C164.2, C168.2, C169.2, C170.2, C174.2, C175.2, R151.1, R152.1, R153.1, R163.1, R164.1, R165.1, R172.1, R173.1, U42.6 (VDD), U43.6 (VDD), U44.6 (VDD), U45.6 (VDD), U46.6 (VDD), U47.6 (VDD), U48.6 (VDD), U49.6 (VDD)
