Alexandr-Filatov/EVD80_MCU_PCB/DiscreteOutputs.kicad_sch

## KiCad design DiscreteOutputs.kicad_sch (2025-07-10)

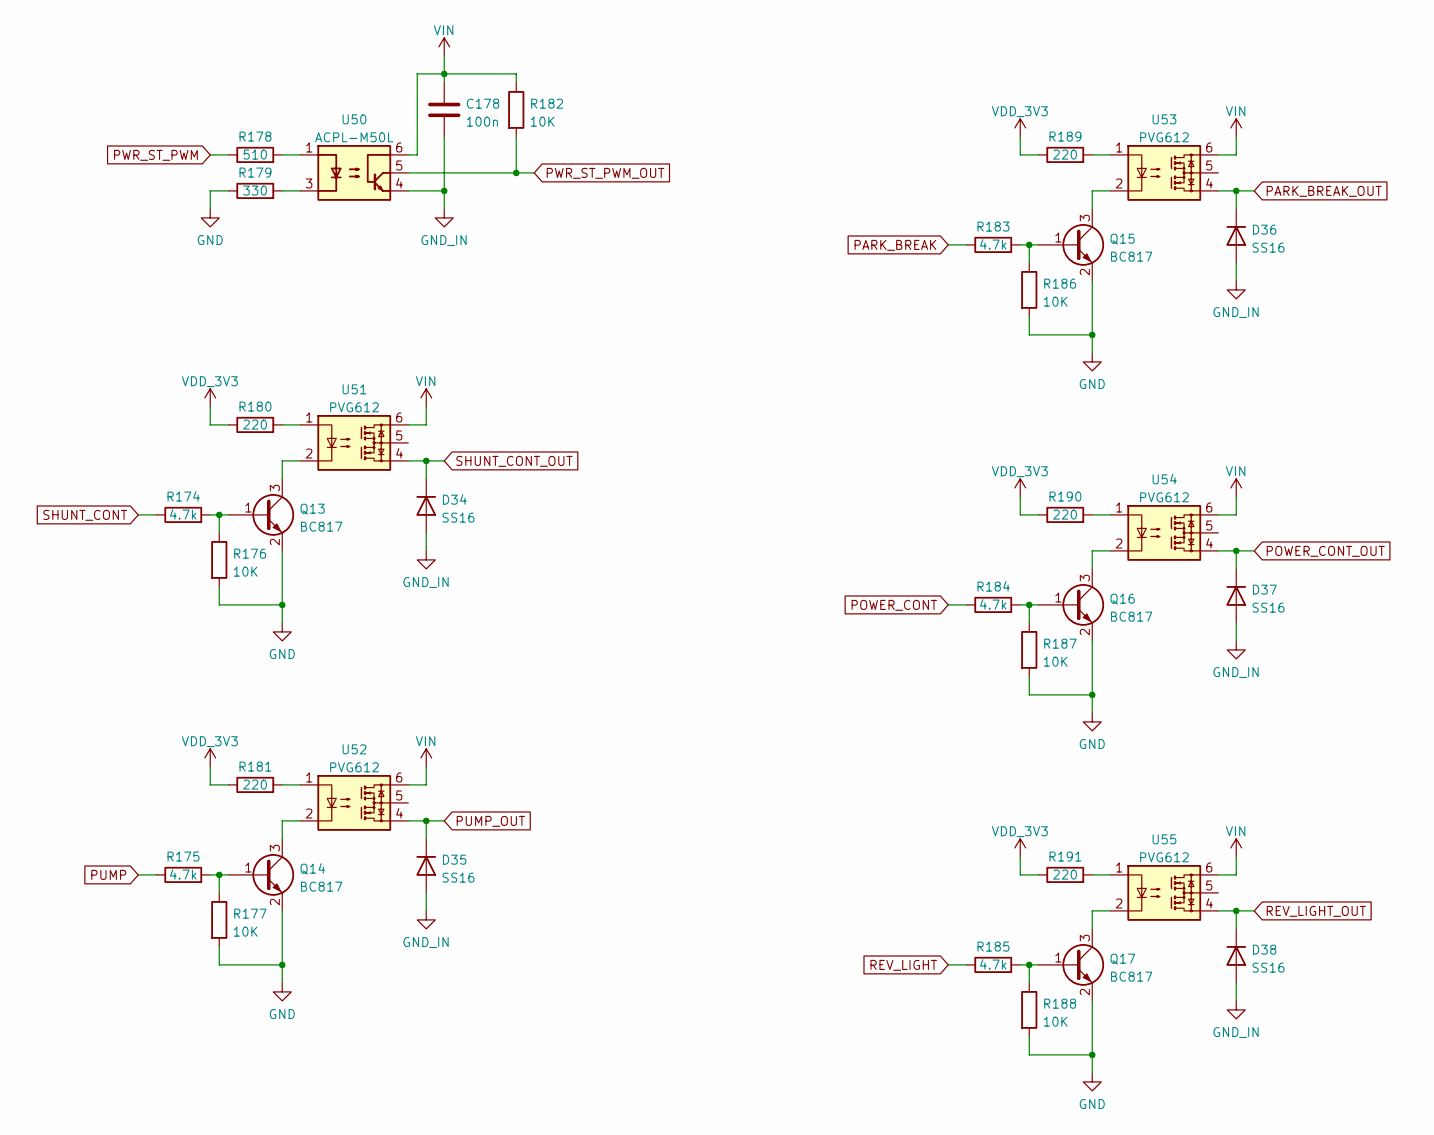
[picture p10: schematic DiscreteOutputs.kicad_sch]

Parts:
C178: 100n; C_0805_2012Metric
D34, D35, D36, D37, D38: SS16; D_SMA
Q13, Q14, Q15, Q16, Q17: BC817; SOT-23
R174, R175, R183, R184, R185: 4.7k; R_0805_2012Metric
R176, R177, R182, R186, R187, R188: 10K; R_0805_2012Metric
R178: 510; R_0805_2012Metric
R179: 330; R_0805_2012Metric
R180, R181, R189, R190, R191: 220; R_0805_2012Metric
U50: ACPL-M50L; SO-5_4.4x3.6mm_P1.27mm
U51, U52, U53, U54, U55: PVG612; DIP-6_W8.89mm_SMDSocket_LongPads

Connections:
GND: Q13.2 (E), Q14.2 (E), Q15.2 (E), Q16.2 (E), Q17.2 (E), R176.2, R177.2, R179.1, R186.2, R187.2, R188.2
GND_IN: C178.1, D34.2 (A), D35.2 (A), D36.2 (A), D37.2 (A), D38.2 (A), U50.4
unnamed: Q13.1 (B), R174.2, R176.1
unnamed: Q13.3 (C), U51.2
unnamed: Q14.1 (B), R175.2, R177.1
unnamed: Q14.3 (C), U52.2
unnamed: Q15.1 (B), R183.2, R186.1
unnamed: Q15.3 (C), U53.2
unnamed: Q16.1 (B), R184.2, R187.1
unnamed: Q16.3 (C), U54.2
unnamed: Q17.1 (B), R185.2, R188.1
unnamed: Q17.3 (C), U55.2
unnamed: R178.2, U50.1
unnamed: R179.2, U50.3
unnamed: R180.2, U51.1
unnamed: R181.2, U52.1
unnamed: R189.2, U53.1
unnamed: R190.2, U54.1
unnamed: R191.2, U55.1
PARK_BREAK: R183.1
PARK_BREAK_OUT: D36.1 (K), U53.4
POWER_CONT: R184.1
POWER_CONT_OUT: D37.1 (K), U54.4
PUMP: R175.1
PUMP_OUT: D35.1 (K), U52.4
PWR_ST_PWM: R178.1
PWR_ST_PWM_OUT: R182.2, U50.5
REV_LIGHT: R185.1
REV_LIGHT_OUT: D38.1 (K), U55.4
SHUNT_CONT: R174.1
SHUNT_CONT_OUT: D34.1 (K), U51.4
VDD_3V3: R180.1, R181.1, R189.1, R190.1, R191.1
VIN: C178.2, R182.1, U50.6, U51.6, U52.6, U53.6, U54.6, U55.6
