Alexandr-Filatov/EVD80_MCU_PCB/EVD80_ControlBoard.kicad_sch

## KiCad design EVD80_ControlBoard.kicad_sch (2025-07-14)

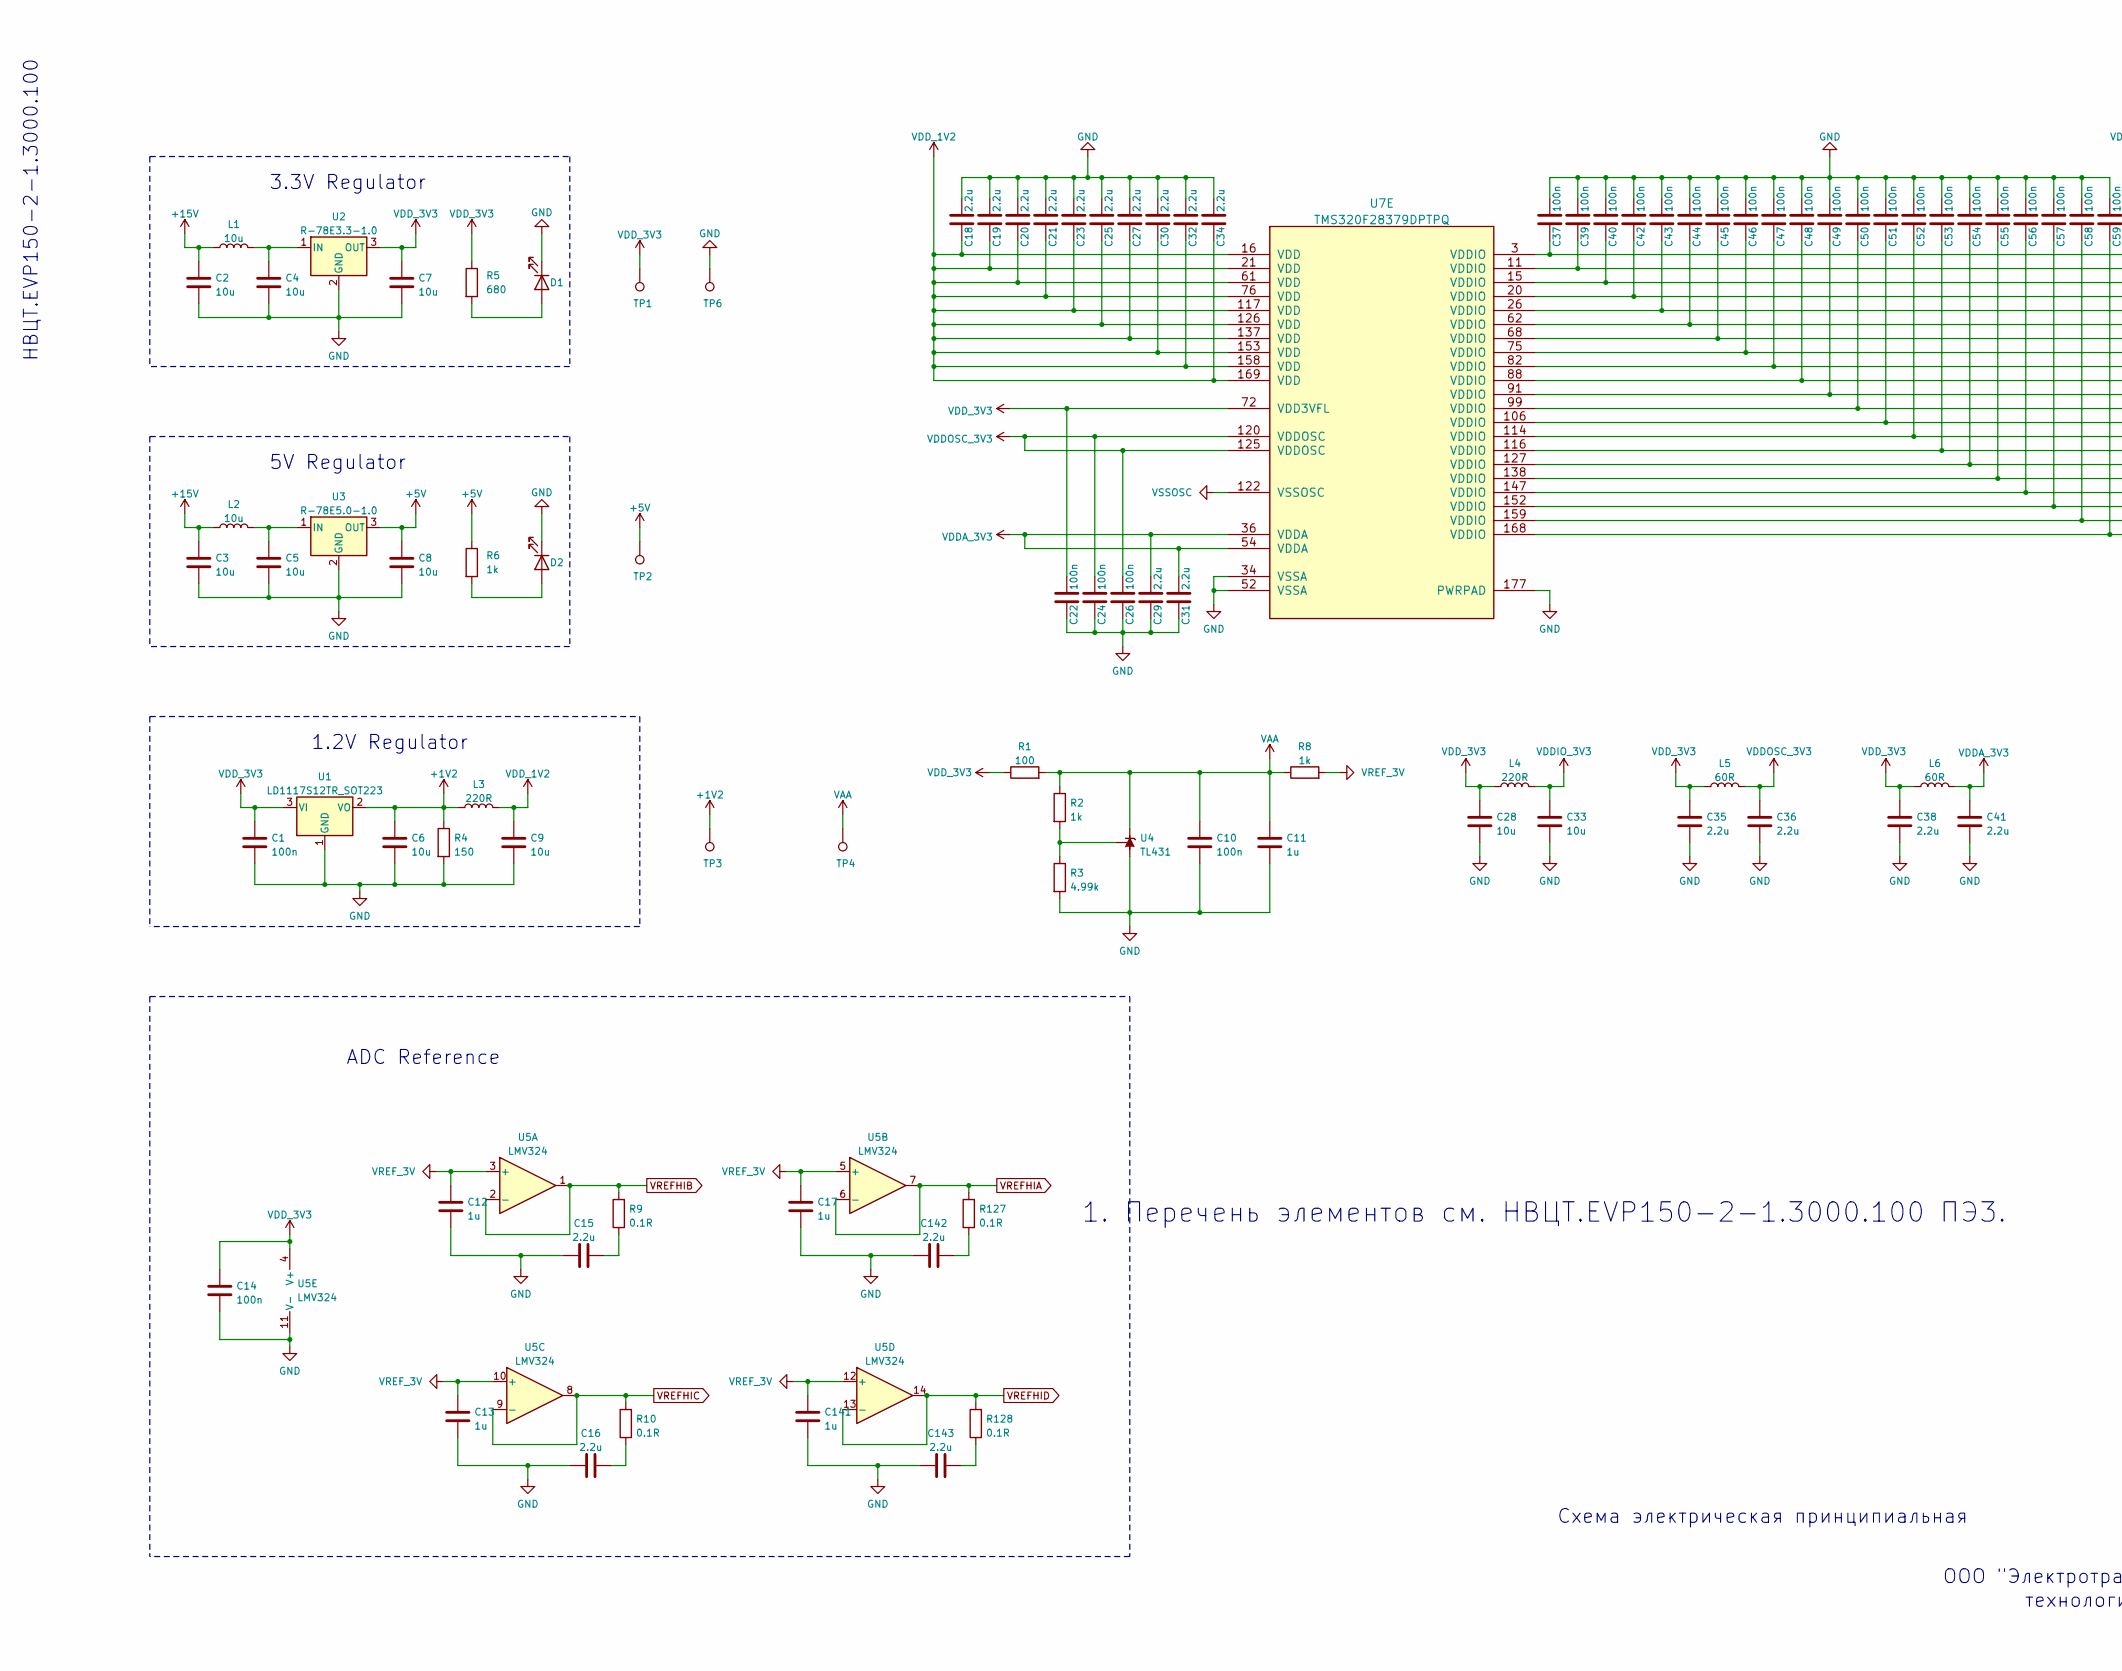
[picture p11: schematic EVD80_ControlBoard.kicad_sch, part in row 1, column 1]

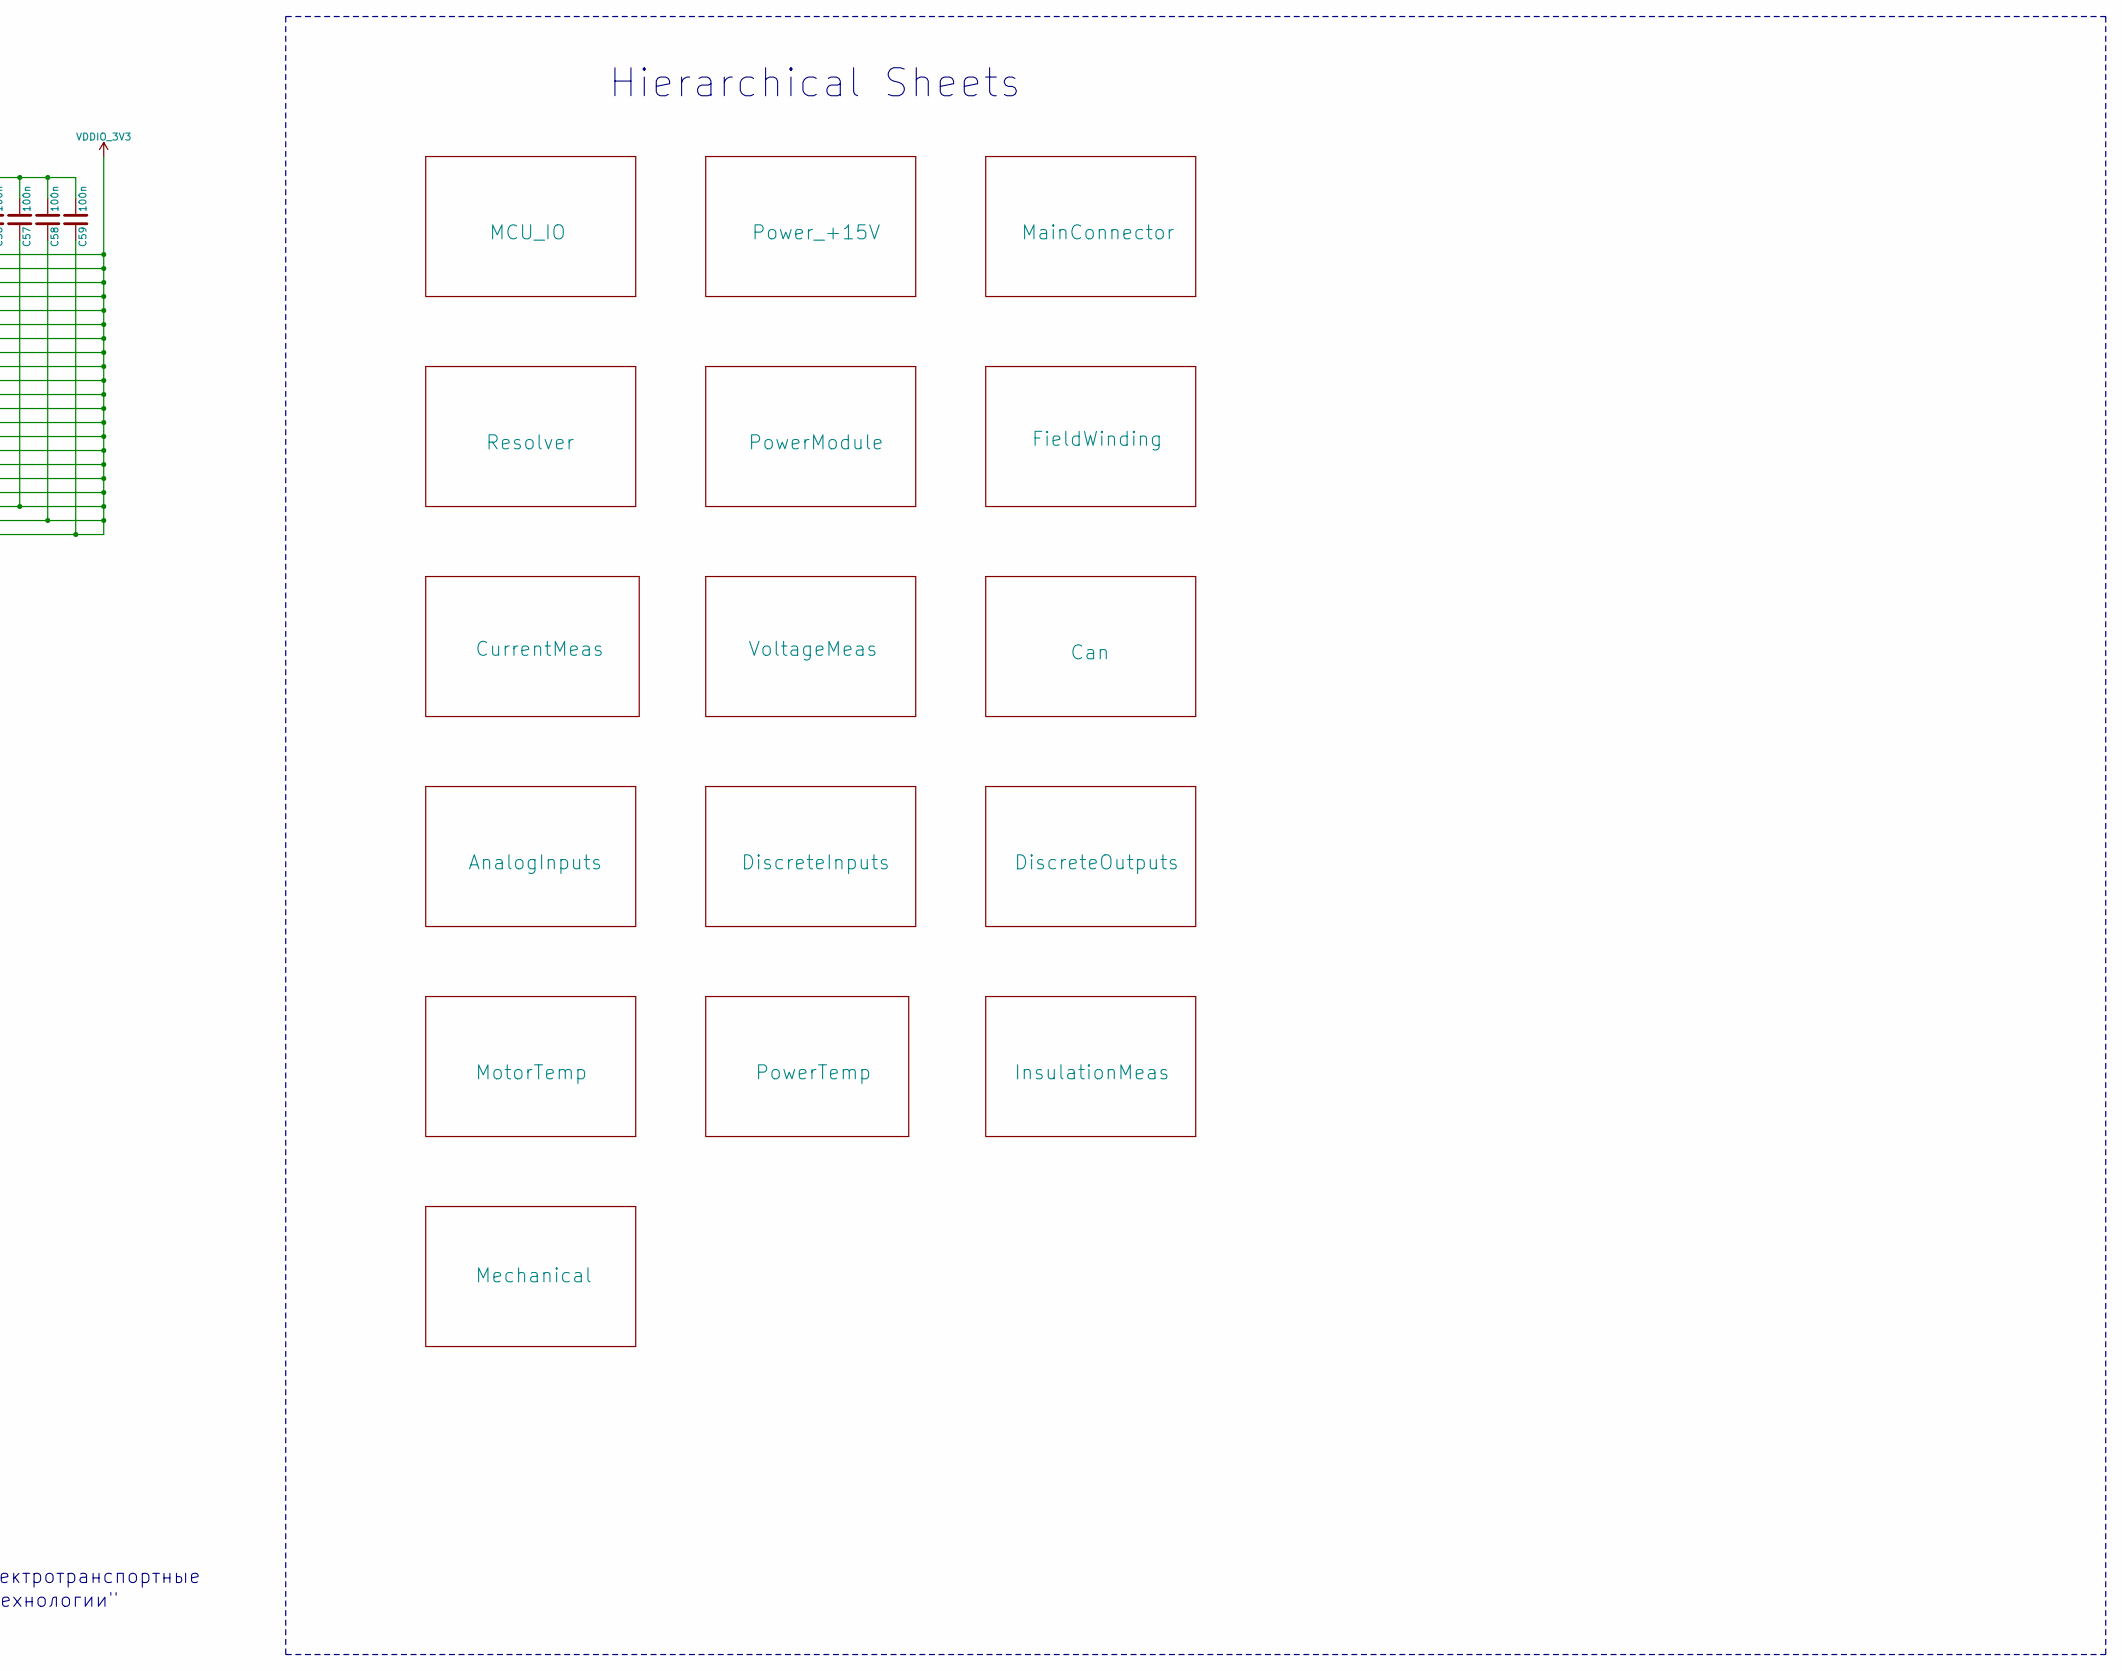
[picture p12: schematic EVD80_ControlBoard.kicad_sch, part in row 1, column 2]

Parts:
C1: 100n; C_0805_2012Metric
C2, C3, C4, C5, C6, C7, C8, C9: 10u; C_0805_2012Metric
C10, C14, C22, C24, C26, C37, C39, C40, C42, C43, C44, C45, C46, C47, C48, C49, C50, C51, C52, C53, C54, C55, C56, C57, C58, C59: 100n; C_0603_1608Metric
C11, C12, C13, C17, C141: 1u; C_0603_1608Metric
C15, C16, C18, C19, C20, C21, C23, C25, C27, C29, C30, C31, C32, C34, C35, C36, C38, C41, C142, C143: 2.2u; C_0603_1608Metric
C28, C33: 10u; C_0603_1608Metric
D1, D2: LED; LED_0805_2012Metric
L1, L2: 10u; L_1008_2520Metric
L3, L4: 220R; L_0603_1608Metric
L5, L6: 60R; L_0603_1608Metric
R1: 100; R_0603_1608Metric
R2, R8: 1k; R_0603_1608Metric
R3: 4.99k; R_0603_1608Metric
R4: 150; R_0805_2012Metric
R5: 680; R_0805_2012Metric
R6: 1k; R_0805_2012Metric
R9, R10, R127, R128: 0.1R; R_0603_1608Metric
TP1, TP2, TP3, TP4, TP6: TestPoint; TestPoint_Plated_Hole_D2.0mm
U1: LD1117S12TR_SOT223; SOT-223-3_TabPin2
U2: R-78E3.3-1.0; Converter_DCDC_RECOM_R-78E-0.5_THT
U3: R-78E5.0-1.0; Converter_DCDC_RECOM_R-78E-0.5_THT
U4: TL431; SOT-23
U5: LMV324
U7: TMS320F28379DPTPQ; TMS320F28377DPTPQ

Connections:
+1V2: C6.1, L3.1, R4.1, TP3.1, U1.2 (VO)
+5V: C8.1, R6.1, TP2.1, U3.3 (OUT)
+15V: C2.1, C3.1, L1.1, L2.1
GND: C1.2, C2.2, C3.2, C4.2, C5.2, C6.2, C7.2, C8.2, C9.2, C10.2, C11.2, C12.2, C13.2, C14.1, C15.1, C16.1, C17.2, C18.1, C19.1, C20.1, C21.1, C22.2, C23.1, C24.2, C25.1, C26.2, C27.1, C28.2, C29.2, C30.1, C31.2, C32.1, C33.2, C34.1, C35.2, C36.2, C37.1, C38.2, C39.1, C40.1, C41.2, C42.1, C43.1, C44.1, C45.1, C46.1, C47.1, C48.1, C49.1, C50.1, C51.1, C52.1, C53.1, C54.1, C55.1, C56.1, C57.1, C58.1, C59.1, C141.2, C142.1, C143.1, D1.1 (K), D2.1 (K), R3.2, R4.2, TP6.1, U1.1 (GND), U2.2 (GND), U3.2 (GND), U4.3 (A), U5.11 (V-), U7.34 (VSSA), U7.52 (VSSA), U7.177 (PWRPAD)
unnamed: C4.1, L1.2, U2.1 (IN)
unnamed: C5.1, L2.2, U3.1 (IN)
unnamed: C15.2, R9.1
unnamed: C16.2, R10.1
unnamed: C142.2, R127.1
unnamed: C143.2, R128.1
unnamed: D1.2 (A), R5.2
unnamed: D2.2 (A), R6.2
unnamed: R2.2, R3.1, U4.2 (REF)
VAA: C10.1, C11.1, R1.2, R2.1, R8.1, TP4.1, U4.1 (K)
VDDA_3V3: C29.1, C31.1, C41.1, L6.2, U7.36 (VDDA), U7.54 (VDDA)
VDDIO_3V3: C33.1, C37.2, C39.2, C40.2, C42.2, C43.2, C44.2, C45.2, C46.2, C47.2, C48.2, C49.2, C50.2, C51.2, C52.2, C53.2, C54.2, C55.2, C56.2, C57.2, C58.2, C59.2, L4.2, U7.3 (VDDIO), U7.11 (VDDIO), U7.15 (VDDIO), U7.20 (VDDIO), U7.26 (VDDIO), U7.62 (VDDIO), U7.68 (VDDIO), U7.75 (VDDIO), U7.82 (VDDIO), U7.88 (VDDIO), U7.91 (VDDIO), U7.99 (VDDIO), U7.106 (VDDIO), U7.114 (VDDIO), U7.116 (VDDIO), U7.127 (VDDIO), U7.138 (VDDIO), U7.147 (VDDIO), U7.152 (VDDIO), U7.159 (VDDIO), U7.168 (VDDIO)
VDDOSC_3V3: C24.1, C26.1, C36.1, L5.2, U7.120 (VDDOSC), U7.125 (VDDOSC)
VDD_1V2: C9.1, C18.2, C19.2, C20.2, C21.2, C23.2, C25.2, C27.2, C30.2, C32.2, C34.2, L3.2, U7.16 (VDD), U7.21 (VDD), U7.61 (VDD), U7.76 (VDD), U7.117 (VDD), U7.126 (VDD), U7.137 (VDD), U7.153 (VDD), U7.158 (VDD), U7.169 (VDD)
VDD_3V3: C1.1, C7.1, C14.2, C22.1, C28.1, C35.1, C38.1, L4.1, L5.1, L6.1, R1.1, R5.1, TP1.1, U1.3 (VI), U2.3 (OUT), U5.4 (V+), U7.72 (VDD3VFL)
VREFHIA: R127.2, U5.6 (-), U5.7
VREFHIB: R9.2, U5.1, U5.2 (-)
VREFHIC: R10.2, U5.8, U5.9 (-)
VREFHID: R128.2, U5.13 (-), U5.14
VREF_3V: C12.1, C13.1, C17.1, C141.1, R8.2, U5.3 (+), U5.5 (+), U5.10 (+), U5.12 (+)
VSSOSC: U7.122 (VSSOSC)

Notes on the sheet:
Схема электрическая принципиальная
1.2V Regulator
3.3V Regulator
НВЦТ.EVP150-2-1.3000.100
технологии"
5V Regulator
ООО "Электротранспортные
ADC Reference
Hierarchical Sheets
1. Перечень элементов см. НВЦТ.EVP150-2-1.3000.100 ПЭ3.
