Alexandr-Filatov/EVD80_MCU_PCB/FieldWinding.kicad_sch

## KiCad design FieldWinding.kicad_sch (2025-07-10)

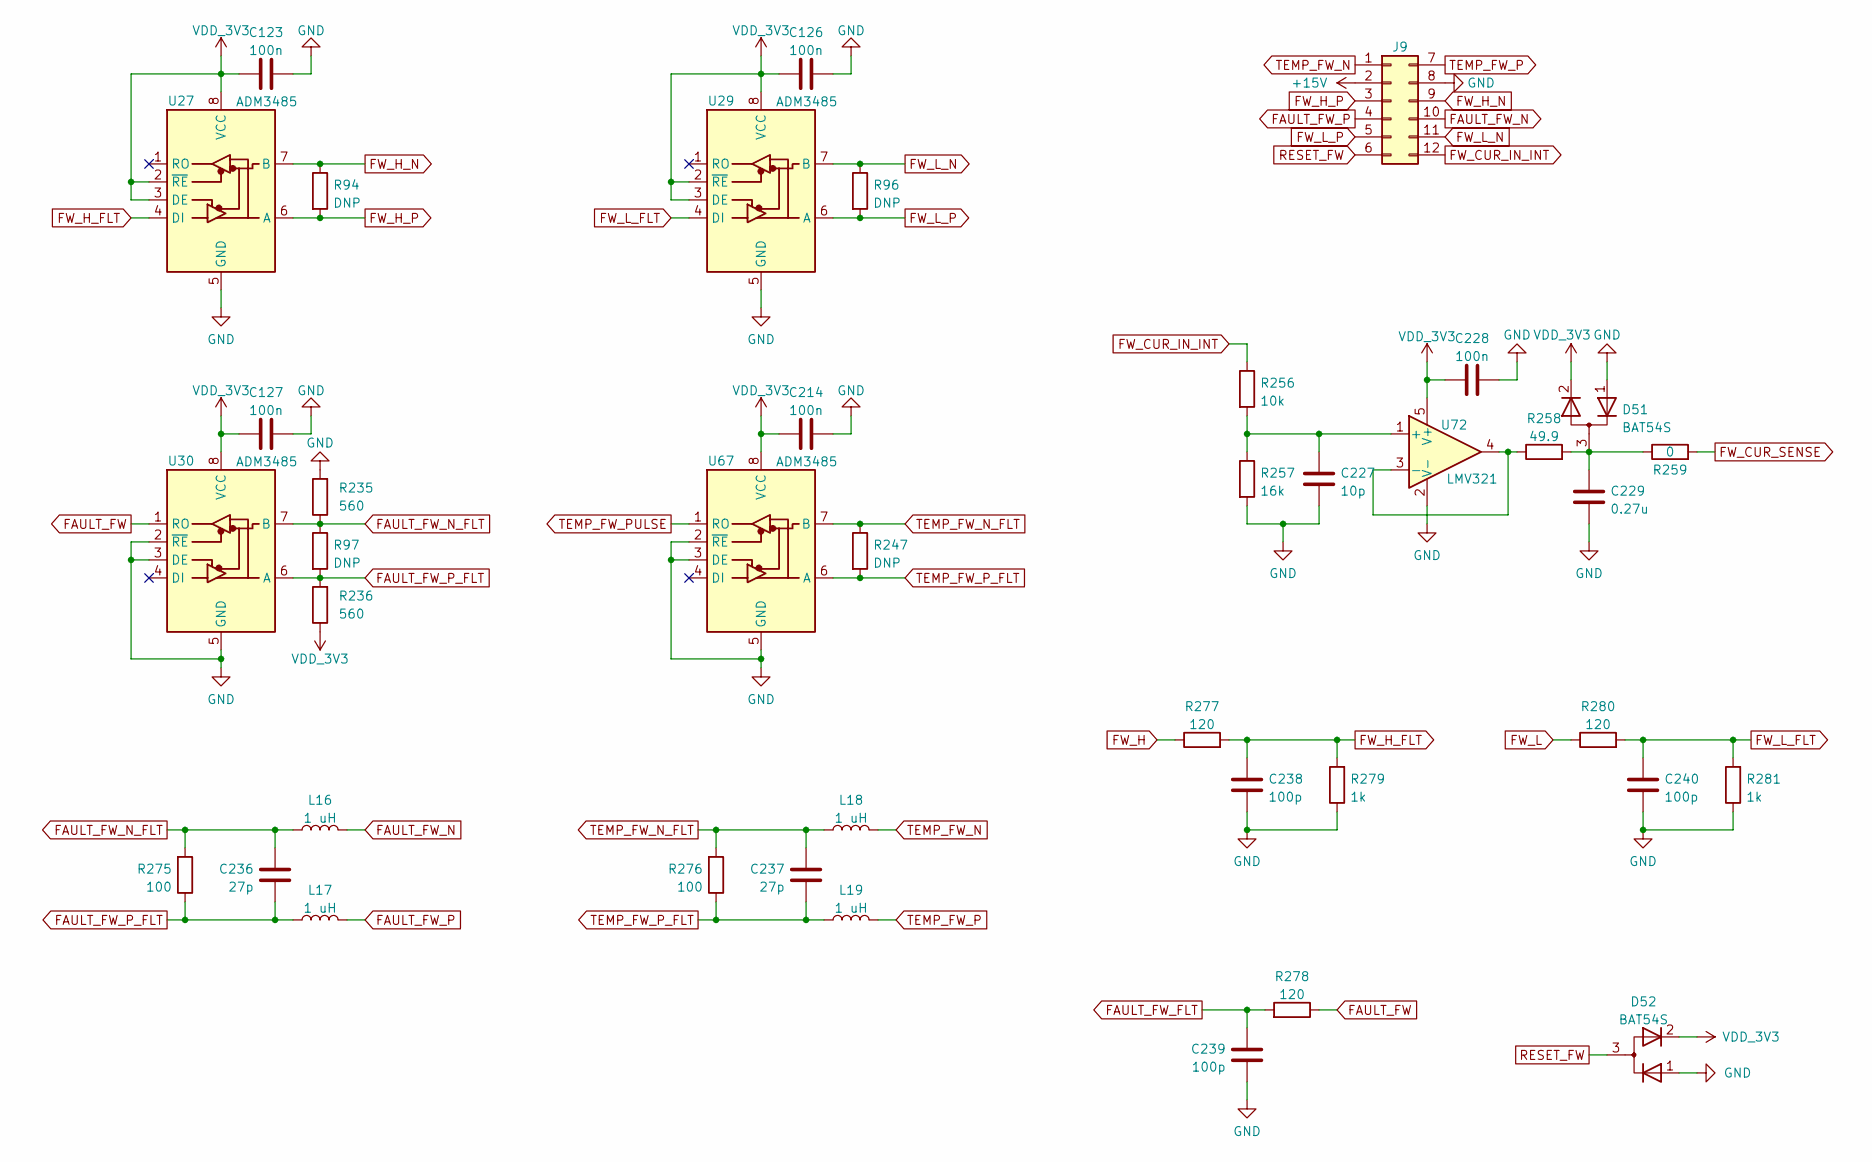
[picture p13: schematic FieldWinding.kicad_sch]

Parts:
C123, C126, C127, C214: 100n; C_1206_3216Metric
C227: 10p; C_0603_1608Metric
C228: 100n; C_0603_1608Metric
C229: 0.27u; C_0603_1608Metric
C236, C237: 27p; C_0603_1608Metric
C238, C239, C240: 100p; C_0603_1608Metric
D51, D52: BAT54S; SOT-23
J9: Molex_Micro-Fit_3.0_43045-1200_2x06_P3.00mm_Horizontal
L16, L17, L18, L19: 1 uH; L_0805_2012Metric
R94, R96, R97, R247: DNP; R_0805_2012Metric
R235, R236: 560; R_0603_1608Metric
R256: 10k; R_0603_1608Metric
R257: 16k; R_0603_1608Metric
R258: 49.9; R_0603_1608Metric
R259: 0; R_0603_1608Metric
R275, R276: 100; R_0603_1608Metric
R277, R278, R280: 120; R_0603_1608Metric
R279, R281: 1k; R_0603_1608Metric
U27, U29, U30, U67: ADM3485; SOIC-8_3.9x4.9mm_P1.27mm
U72: LMV321; SOT-23-5

Connections:
+15V: J9.2
FAULT_FW: R278.1, U30.1 (RO)
FAULT_FW_FLT: C239.1, R278.2
FAULT_FW_N: J9.10, L16.1
FAULT_FW_N_FLT: C236.1, L16.2, R97.1, R235.1, R275.2, U30.7 (B)
FAULT_FW_P: J9.4, L17.1
FAULT_FW_P_FLT: C236.2, L17.2, R97.2, R236.2, R275.1, U30.6 (A)
FW_CUR_IN_INT: J9.12, R256.1
FW_CUR_SENSE: R259.2
FW_H: R277.1
FW_H_FLT: C238.1, R277.2, R279.2, U27.4 (DI)
FW_H_N: J9.9, R94.1, U27.7 (B)
FW_H_P: J9.3, R94.2, U27.6 (A)
FW_L: R280.1
FW_L_FLT: C240.1, R280.2, R281.2, U29.4 (DI)
FW_L_N: J9.11, R96.1, U29.7 (B)
FW_L_P: J9.5, R96.2, U29.6 (A)
GND: C123.2, C126.2, C127.2, C214.2, C227.2, C228.2, C229.2, C238.2, C239.2, C240.2, D51.1 (K), D52.1 (K), J9.8, R235.2, R257.2, R279.1, R281.1, U27.5 (GND), U29.5 (GND), U30.2 (~RE), U30.3 (DE), U30.5 (GND), U67.2 (~RE), U67.3 (DE), U67.5 (GND), U72.2 (V-)
unnamed: C227.1, R256.2, R257.1, U72.1 (+)
unnamed: C229.1, D51.3 (A), R258.2, R259.1
unnamed: R258.1, U72.3 (-), U72.4
RESET_FW: D52.3 (A), J9.6
TEMP_FW_N: J9.1, L18.1
TEMP_FW_N_FLT: C237.1, L18.2, R247.1, R276.2, U67.7 (B)
TEMP_FW_P: J9.7, L19.1
TEMP_FW_PULSE: U67.1 (RO)
TEMP_FW_P_FLT: C237.2, L19.2, R247.2, R276.1, U67.6 (A)
VDD_3V3: C123.1, C126.1, C127.1, C214.1, C228.1, D51.2 (K), D52.2 (K), R236.1, U27.2 (~RE), U27.3 (DE), U27.8 (VCC), U29.2 (~RE), U29.3 (DE), U29.8 (VCC), U30.8 (VCC), U67.8 (VCC), U72.5 (V+)
