Alexandr-Filatov/EVD80_MCU_PCB/InsulationMeas.kicad_sch

## KiCad design InsulationMeas.kicad_sch (2025-07-10)

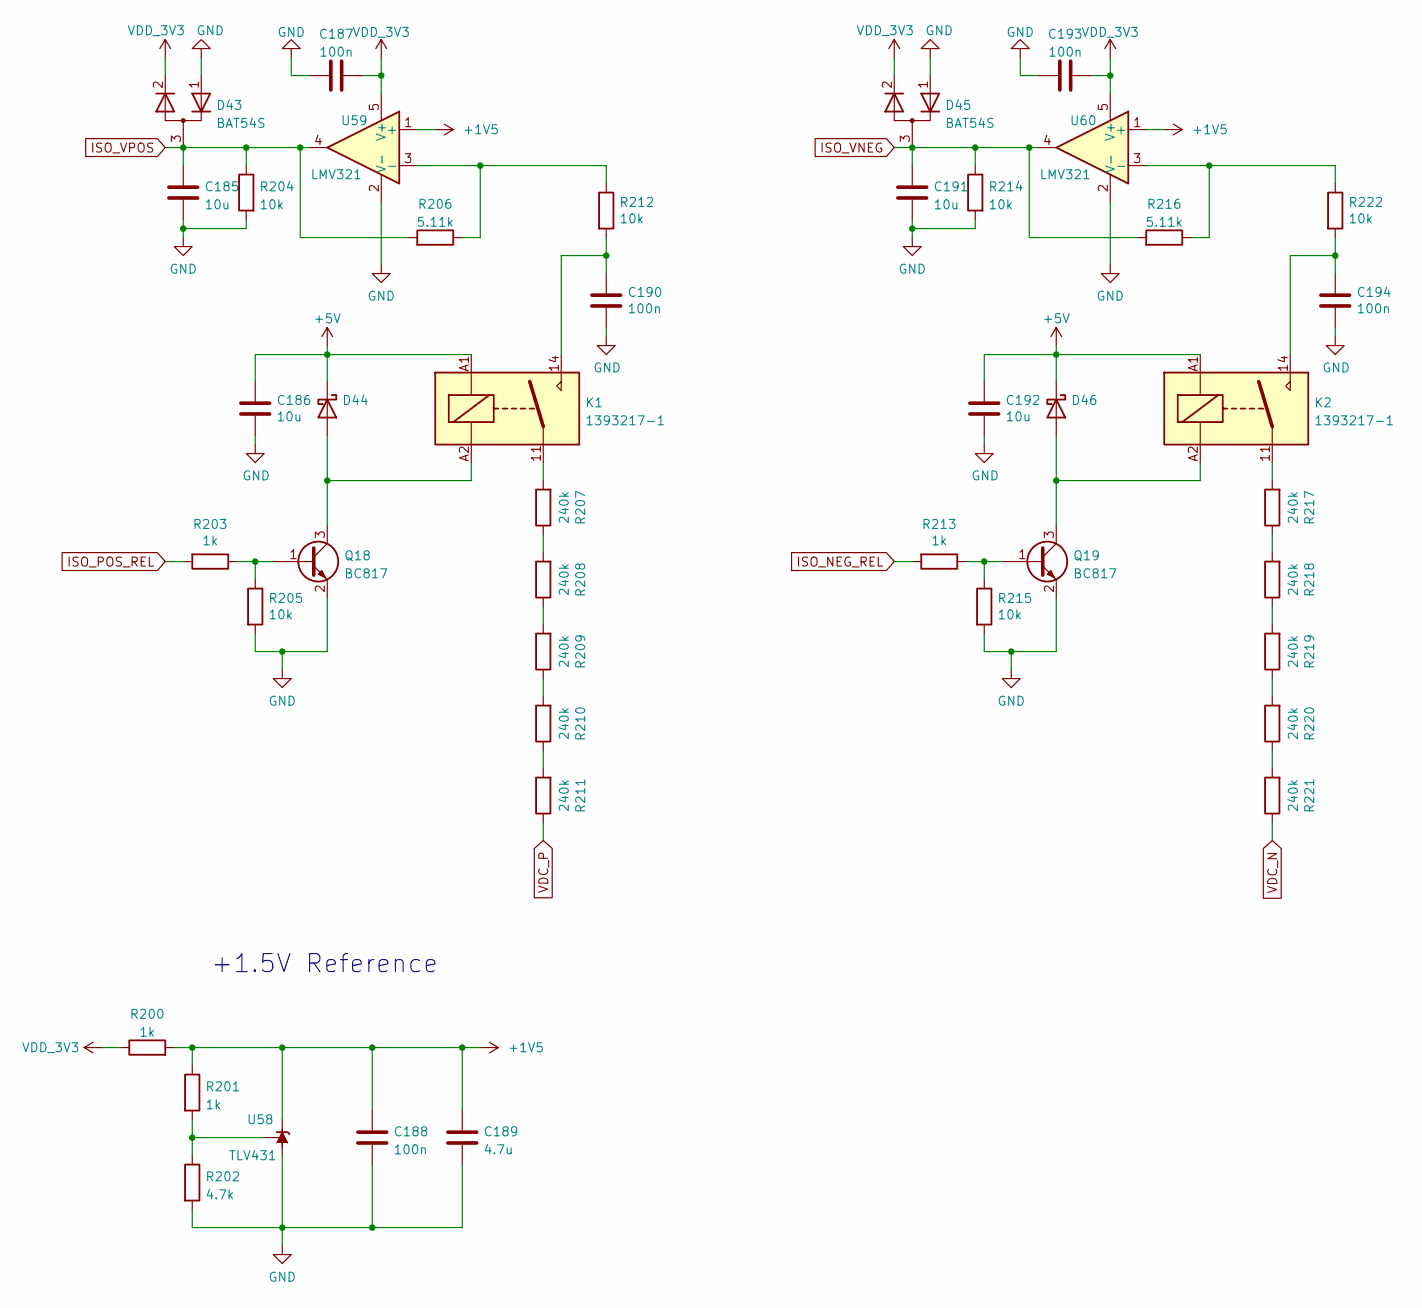
[picture p14: schematic InsulationMeas.kicad_sch]

Parts:
C185, C186, C191, C192: 10u; C_0603_1608Metric
C187, C188, C190, C193, C194: 100n; C_0603_1608Metric
C189: 4.7u; C_0603_1608Metric
D43, D45: BAT54S; SOT-23
D44, D46: SS16; D_SMA
K1, K2: 1393217-1; Relay_SPST_Finder_32.21-x300
Q18, Q19: BC817; SOT-23
R200, R201, R203, R213: 1k; R_0603_1608Metric
R202: 4.7k; R_0603_1608Metric
R204, R205, R212, R214, R215, R222: 10k; R_0603_1608Metric
R206, R216: 5.11k; R_0603_1608Metric
R207, R208, R209, R210, R211, R217, R218, R219, R220, R221: 240k; R_1206_3216Metric
U58: TLV431; SOT-23
U59, U60: LMV321; SOT-23-5

Connections:
+1V5: C188.1, C189.1, R200.2, R201.1, U58.2 (K), U59.1 (+), U60.1 (+)
+5V: C186.1, C192.1, D44.1 (K), D46.1 (K), K1.A1, K2.A1
GND: C185.2, C186.2, C187.2, C188.2, C189.2, C190.2, C191.2, C192.2, C193.2, C194.2, D43.1 (K), D45.1 (K), Q18.2 (E), Q19.2 (E), R202.2, R204.2, R205.2, R214.2, R215.2, U58.3 (A), U59.2 (V-), U60.2 (V-)
ISO_NEG_REL: R213.2
ISO_POS_REL: R203.2
ISO_VNEG: C191.1, D45.3 (A), R214.1, R216.2, U60.4
ISO_VPOS: C185.1, D43.3 (A), R204.1, R206.2, U59.4
unnamed: C190.1, K1.14, R212.2
unnamed: C194.1, K2.14, R222.2
unnamed: D44.2 (A), K1.A2, Q18.3 (C)
unnamed: D46.2 (A), K2.A2, Q19.3 (C)
unnamed: K1.11, R207.2
unnamed: K2.11, R217.2
unnamed: Q18.1 (B), R203.1, R205.1
unnamed: Q19.1 (B), R213.1, R215.1
unnamed: R201.2, R202.1, U58.1 (REF)
unnamed: R206.1, R212.1, U59.3 (-)
unnamed: R207.1, R208.2
unnamed: R208.1, R209.2
unnamed: R209.1, R210.2
unnamed: R210.1, R211.2
unnamed: R216.1, R222.1, U60.3 (-)
unnamed: R217.1, R218.2
unnamed: R218.1, R219.2
unnamed: R219.1, R220.2
unnamed: R220.1, R221.2
VDC_N: R221.1
VDC_P: R211.1
VDD_3V3: C187.1, C193.1, D43.2 (K), D45.2 (K), R200.1, U59.5 (V+), U60.5 (V+)

Notes on the sheet:
+1.5V Reference
