Alexandr-Filatov/EVD80_MCU_PCB/MCU_IO.kicad_sch

## KiCad design MCU_IO.kicad_sch (2025-07-10)

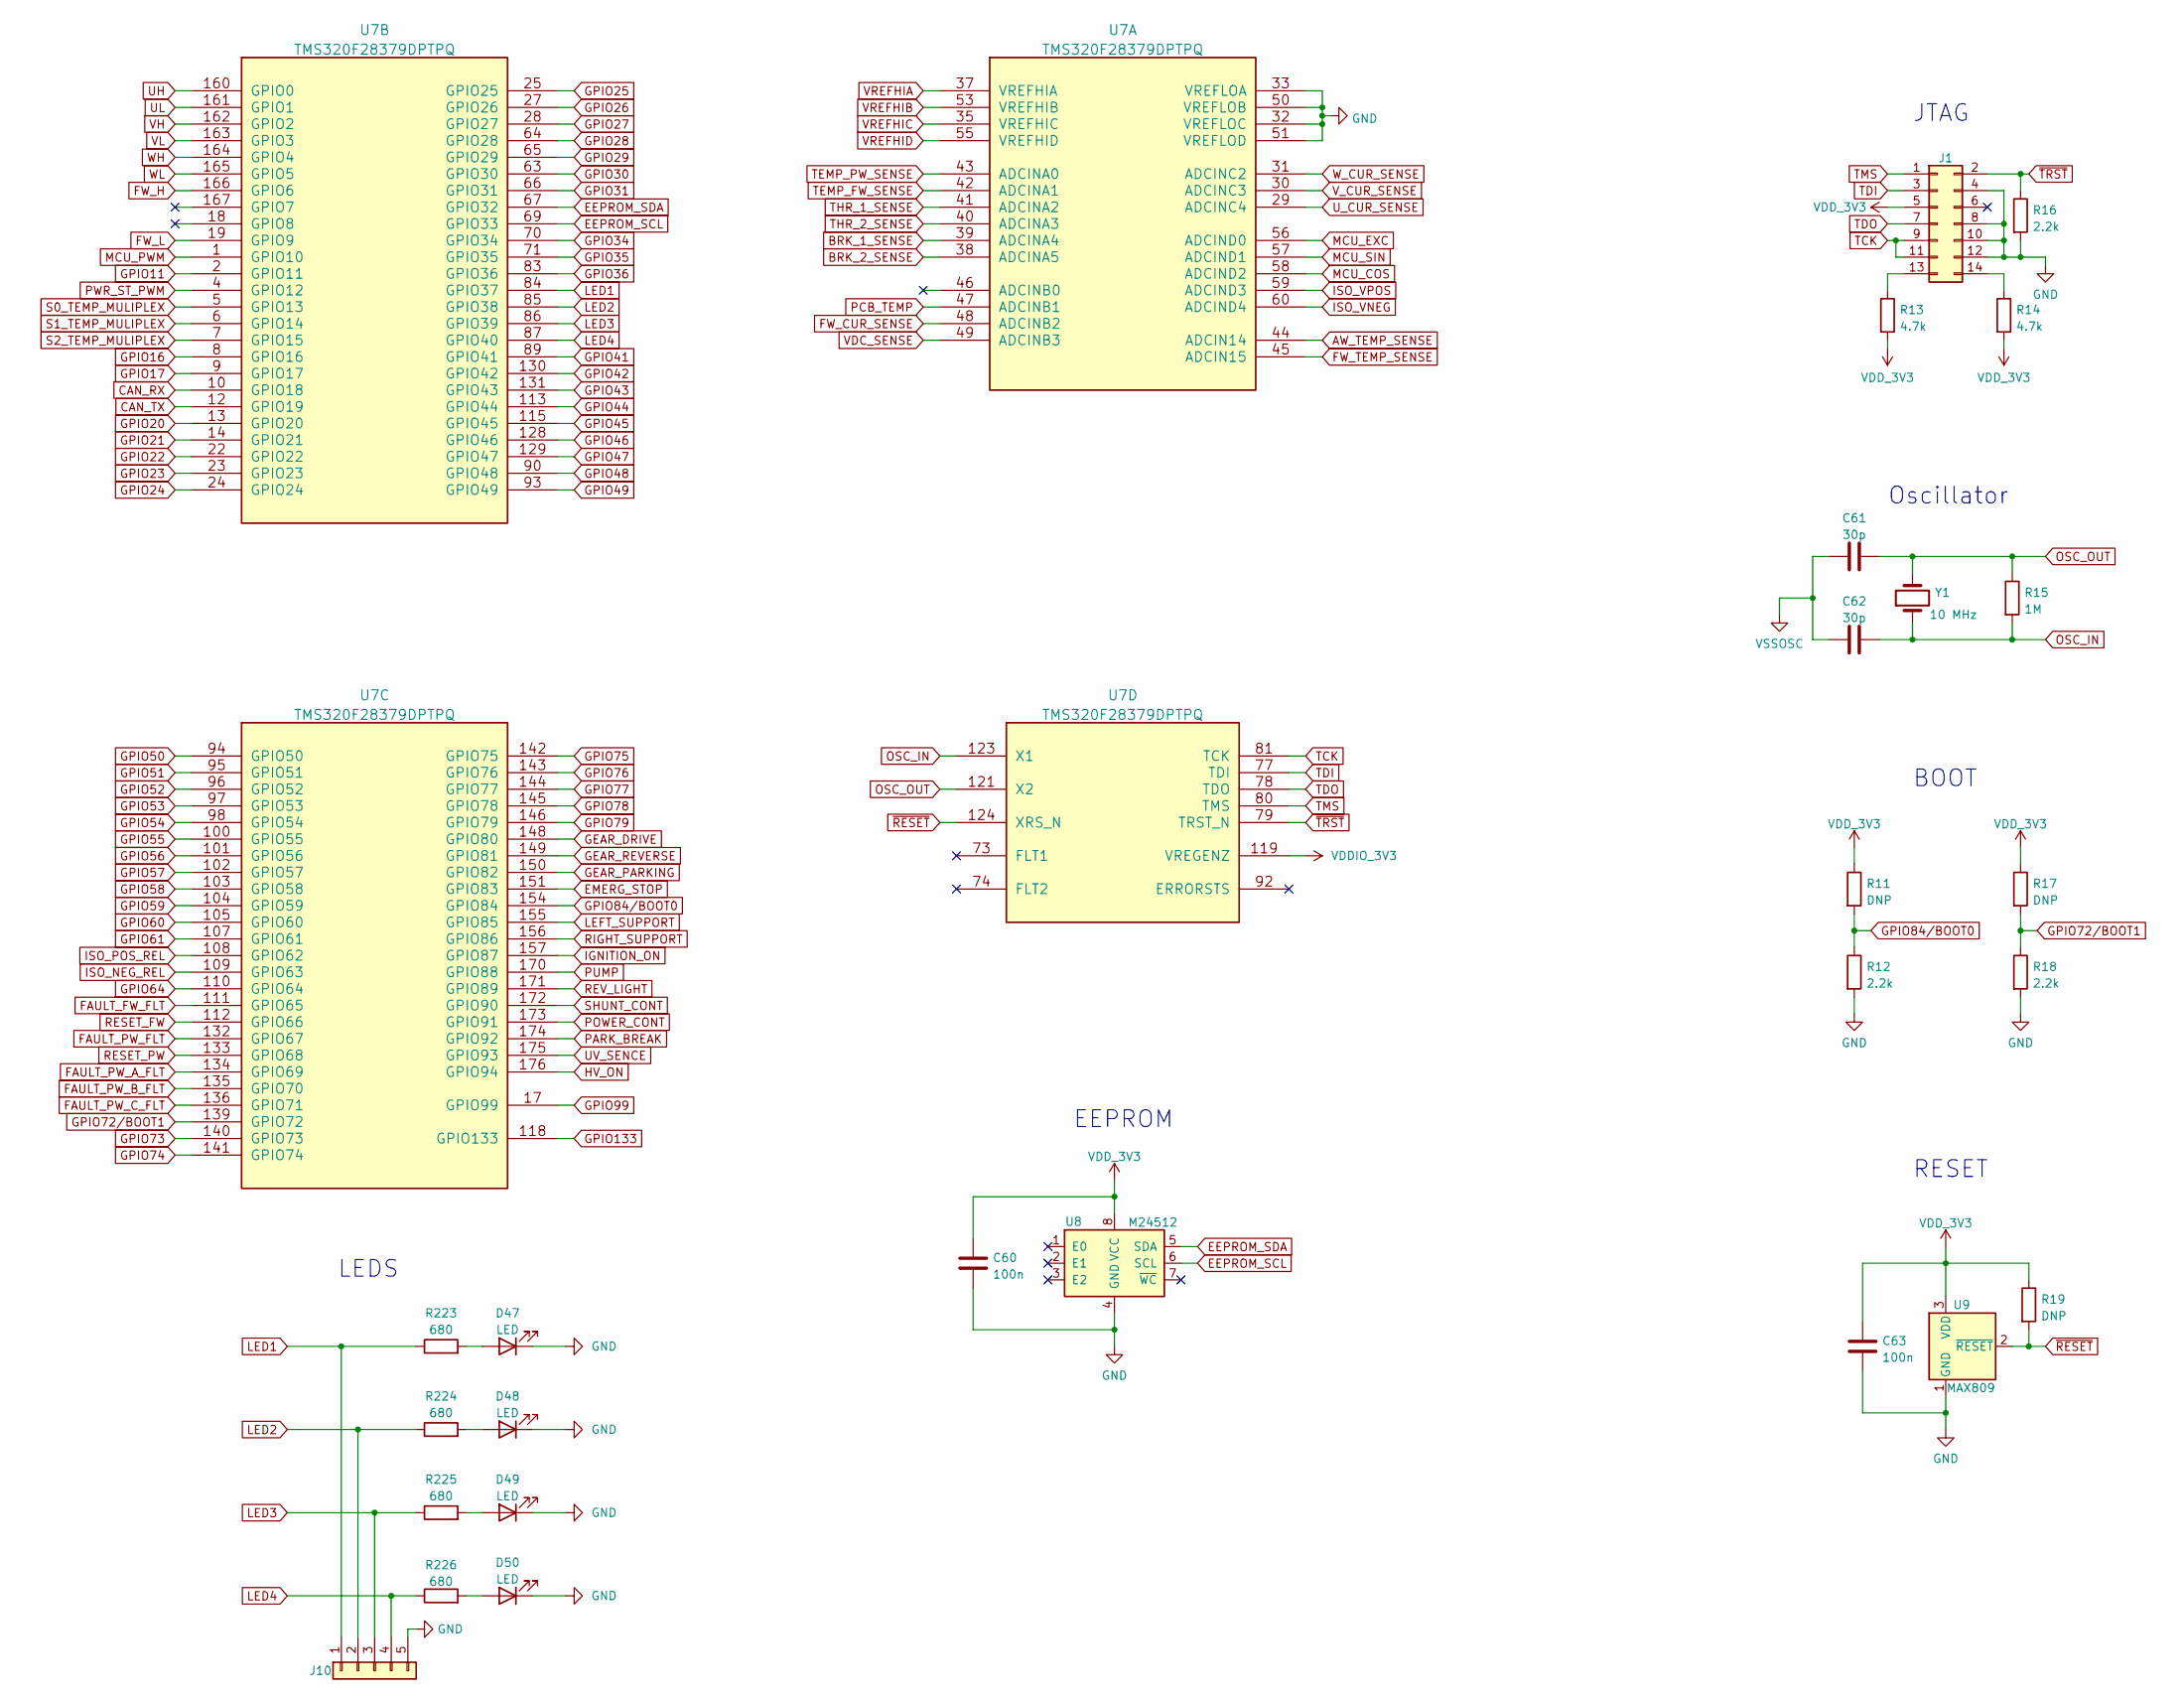
[picture p15: schematic MCU_IO.kicad_sch]

Parts:
C60, C63: 100n; C_0603_1608Metric
C61, C62: 30p; C_0805_2012Metric
D47, D48, D49, D50: LED; LED_0805_2012Metric
J1: Conn_02x07_Odd_Even; PinHeader_2x07_P2.54mm_Vertical
J10: Conn_01x05; PinHeader_1x05_P2.54mm_Vertical
R11, R17, R19: DNP; R_0603_1608Metric
R12, R16, R18: 2.2k; R_0603_1608Metric
R13, R14: 4.7k; R_0603_1608Metric
R15: 1M; R_0805_2012Metric
R223, R224, R225, R226: 680; R_0805_2012Metric
U7: TMS320F28379DPTPQ; TMS320F28377DPTPQ
U8: M24512; SO-8_3.9x4.9mm_P1.27mm
U9: MAX809; SOT-23
Y1: 10 MHz; Crystal_SMD_HC49-SM

Connections:
AW_TEMP_SENSE: U7.44 (ADCIN14)
BRK_1_SENSE: U7.39 (ADCINA4)
BRK_2_SENSE: U7.38 (ADCINA5)
CAN_RX: U7.10 (GPIO18)
CAN_TX: U7.12 (GPIO19)
EEPROM_SCL: U7.69 (GPIO33), U8.6 (SCL)
EEPROM_SDA: U7.67 (GPIO32), U8.5 (SDA)
EMERG_STOP: U7.151 (GPIO83)
FAULT_FW_FLT: U7.111 (GPIO65)
FAULT_PW_A_FLT: U7.134 (GPIO69)
FAULT_PW_B_FLT: U7.135 (GPIO70)
FAULT_PW_C_FLT: U7.136 (GPIO71)
FAULT_PW_FLT: U7.132 (GPIO67)
FW_CUR_SENSE: U7.48 (ADCINB2)
FW_H: U7.166 (GPIO6)
FW_L: U7.19 (GPIO9)
FW_TEMP_SENSE: U7.45 (ADCIN15)
GEAR_DRIVE: U7.148 (GPIO80)
GEAR_PARKING: U7.150 (GPIO82)
GEAR_REVERSE: U7.149 (GPIO81)
GND: C60.1, C63.1, D47.1 (K), D48.1 (K), D49.1 (K), D50.1 (K), J1.4, J1.8, J1.10, J1.12, J10.5, R12.2, R16.2, R18.2, U7.32 (VREFLOC), U7.33 (VREFLOA), U7.50 (VREFLOB), U7.51 (VREFLOD), U8.4 (GND), U9.1 (GND)
GPIO11: U7.2 (GPIO11)
GPIO16: U7.8 (GPIO16)
GPIO17: U7.9 (GPIO17)
GPIO20: U7.13 (GPIO20)
GPIO21: U7.14 (GPIO21)
GPIO22: U7.22 (GPIO22)
GPIO23: U7.23 (GPIO23)
GPIO24: U7.24 (GPIO24)
GPIO25: U7.25 (GPIO25)
GPIO26: U7.27 (GPIO26)
GPIO27: U7.28 (GPIO27)
GPIO28: U7.64 (GPIO28)
GPIO29: U7.65 (GPIO29)
GPIO30: U7.63 (GPIO30)
GPIO31: U7.66 (GPIO31)
GPIO34: U7.70 (GPIO34)
GPIO35: U7.71 (GPIO35)
GPIO36: U7.83 (GPIO36)
GPIO41: U7.89 (GPIO41)
GPIO42: U7.130 (GPIO42)
GPIO43: U7.131 (GPIO43)
GPIO44: U7.113 (GPIO44)
GPIO45: U7.115 (GPIO45)
GPIO46: U7.128 (GPIO46)
GPIO47: U7.129 (GPIO47)
GPIO48: U7.90 (GPIO48)
GPIO49: U7.93 (GPIO49)
GPIO50: U7.94 (GPIO50)
GPIO51: U7.95 (GPIO51)
GPIO52: U7.96 (GPIO52)
GPIO53: U7.97 (GPIO53)
GPIO54: U7.98 (GPIO54)
GPIO55: U7.100 (GPIO55)
GPIO56: U7.101 (GPIO56)
GPIO57: U7.102 (GPIO57)
GPIO58: U7.103 (GPIO58)
GPIO59: U7.104 (GPIO59)
GPIO60: U7.105 (GPIO60)
GPIO61: U7.107 (GPIO61)
GPIO64: U7.110 (GPIO64)
GPIO72/BOOT1: R17.2, R18.1, U7.139 (GPIO72)
GPIO73: U7.140 (GPIO73)
GPIO74: U7.141 (GPIO74)
GPIO75: U7.142 (GPIO75)
GPIO76: U7.143 (GPIO76)
GPIO77: U7.144 (GPIO77)
GPIO78: U7.145 (GPIO78)
GPIO79: U7.146 (GPIO79)
GPIO84/BOOT0: R11.2, R12.1, U7.154 (GPIO84)
GPIO99: U7.17 (GPIO99)
GPIO133: U7.118 (GPIO133)
HV_ON: U7.176 (GPIO94)
IGNITION_ON: U7.157 (GPIO87)
ISO_NEG_REL: U7.109 (GPIO63)
ISO_POS_REL: U7.108 (GPIO62)
ISO_VNEG: U7.60 (ADCIND4)
ISO_VPOS: U7.59 (ADCIND3)
LED1: J10.1, R223.1, U7.84 (GPIO37)
LED2: J10.2, R224.1, U7.85 (GPIO38)
LED3: J10.3, R225.1, U7.86 (GPIO39)
LED4: J10.4, R226.1, U7.87 (GPIO40)
LEFT_SUPPORT: U7.155 (GPIO85)
MCU_COS: U7.58 (ADCIND2)
MCU_EXC: U7.56 (ADCIND0)
MCU_PWM: U7.1 (GPIO10)
MCU_SIN: U7.57 (ADCIND1)
unnamed: D47.2 (A), R223.2
unnamed: D48.2 (A), R224.2
unnamed: D49.2 (A), R225.2
unnamed: D50.2 (A), R226.2
unnamed: J1.13, R13.1
unnamed: J1.14, R14.1
OSC_IN: C62.2, R15.2, U7.123 (X1), Y1.1
OSC_OUT: C61.2, R15.1, U7.121 (X2), Y1.2
PARK_BREAK: U7.174 (GPIO92)
PCB_TEMP: U7.47 (ADCINB1)
POWER_CONT: U7.173 (GPIO91)
PUMP: U7.170 (GPIO88)
PWR_ST_PWM: U7.4 (GPIO12)
RESET_FW: U7.112 (GPIO66)
RESET_PW: U7.133 (GPIO68)
REV_LIGHT: U7.171 (GPIO89)
RIGHT_SUPPORT: U7.156 (GPIO86)
S0_TEMP_MULIPLEX: U7.5 (GPIO13)
S1_TEMP_MULIPLEX: U7.6 (GPIO14)
S2_TEMP_MULIPLEX: U7.7 (GPIO15)
SHUNT_CONT: U7.172 (GPIO90)
TCK: J1.9, J1.11, U7.81 (TCK)
TDI: J1.3, U7.77 (TDI)
TDO: J1.7, U7.78 (TDO)
TEMP_FW_SENSE: U7.42 (ADCINA1)
TEMP_PW_SENSE: U7.43 (ADCINA0)
THR_1_SENSE: U7.41 (ADCINA2)
THR_2_SENSE: U7.40 (ADCINA3)
TMS: J1.1, U7.80 (TMS)
UH: U7.160 (GPIO0)
UL: U7.161 (GPIO1)
UV_SENCE: U7.175 (GPIO93)
U_CUR_SENSE: U7.29 (ADCINC4)
VDC_SENSE: U7.49 (ADCINB3)
VDDIO_3V3: U7.119 (VREGENZ)
VDD_3V3: C60.2, C63.2, J1.5, R11.1, R13.2, R14.2, R17.1, R19.1, U8.8 (VCC), U9.3 (VDD)
VH: U7.162 (GPIO2)
VL: U7.163 (GPIO3)
VREFHIA: U7.37 (VREFHIA)
VREFHIB: U7.53 (VREFHIB)
VREFHIC: U7.35 (VREFHIC)
VREFHID: U7.55 (VREFHID)
VSSOSC: C61.1, C62.1
V_CUR_SENSE: U7.30 (ADCINC3)
WH: U7.164 (GPIO4)
WL: U7.165 (GPIO5)
W_CUR_SENSE: U7.31 (ADCINC2)
~RESET: R19.2, U7.124 (XRS_N), U9.2 (~RESET)
~TRST: J1.2, R16.1, U7.79 (TRST_N)

Notes on the sheet:
RESET
LEDS
BOOT
EEPROM
Oscillator
JTAG
