Alexandr-Filatov/EVD80_MCU_PCB/MainConnector.kicad_sch

## KiCad design MainConnector.kicad_sch (2025-07-10)

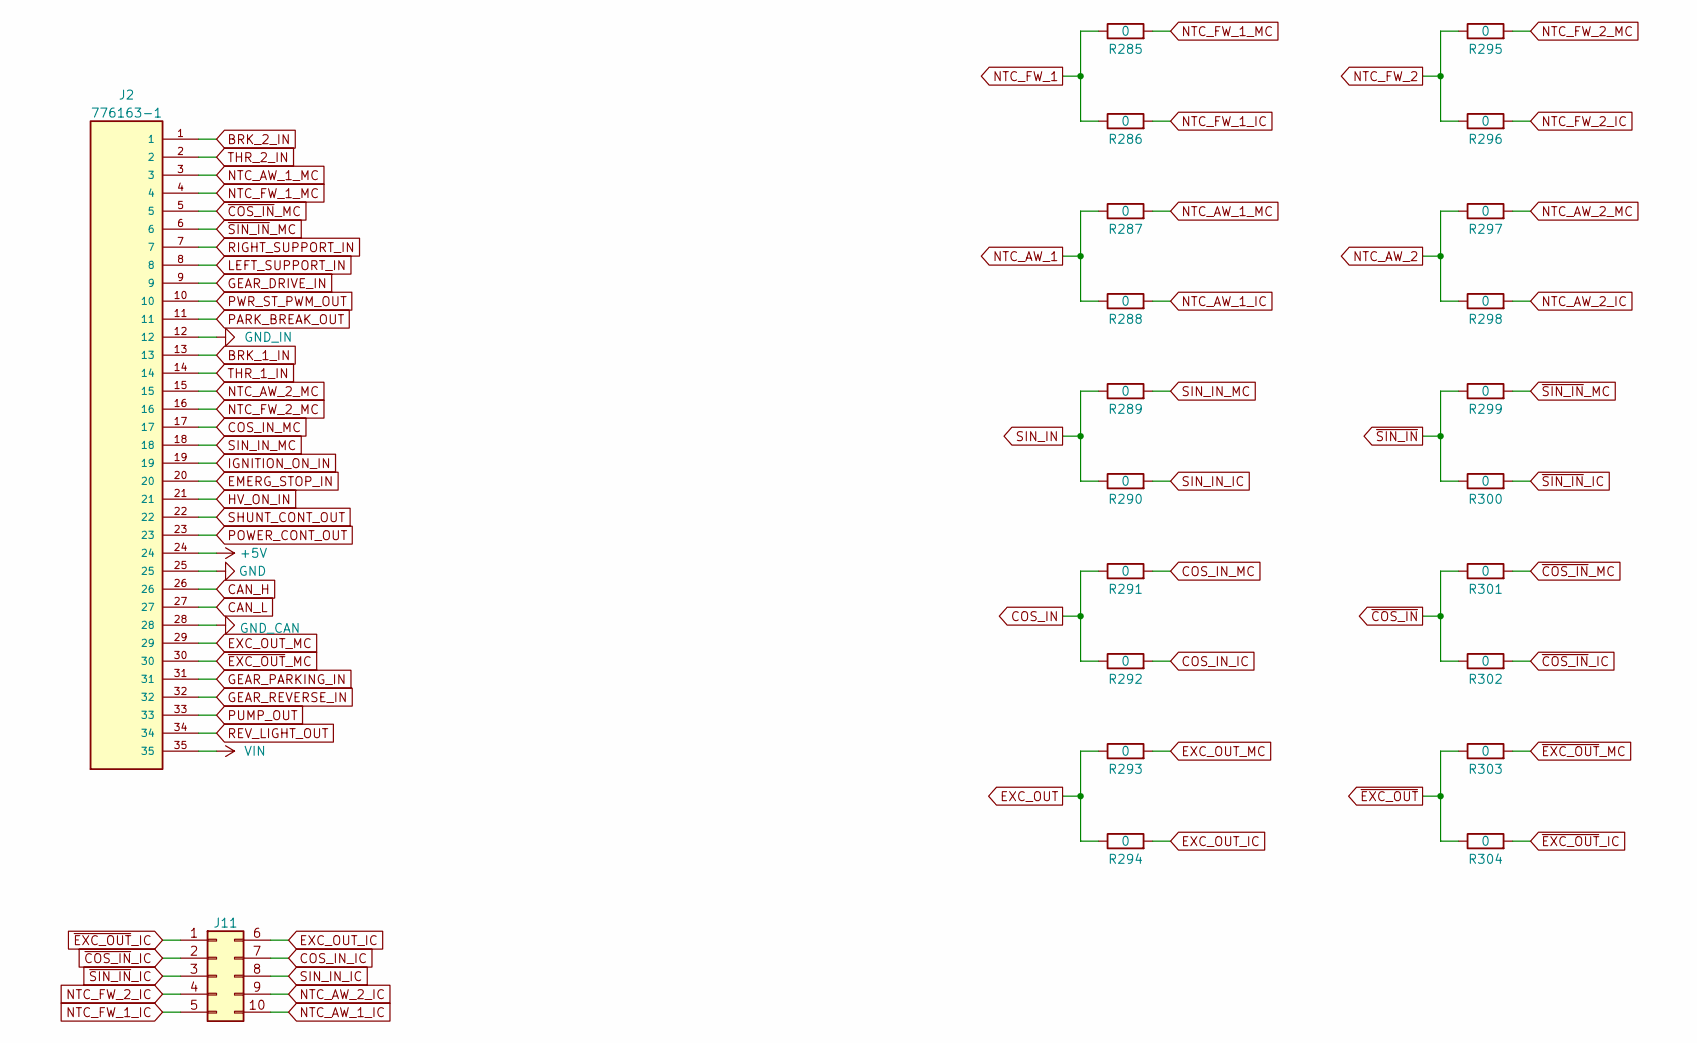
[picture p16: schematic MainConnector.kicad_sch]

Parts:
J2: 776163-1; TE_776163-1
J11: Conn_02x05_Top_Bottom; Molex_Micro-Fit_3.0_43045-1000_2x05_P3.00mm_Horizontal
R285, R286, R287, R288, R289, R290, R291, R292, R293, R294, R295, R296, R297, R298, R299, R300, R301, R302, R303, R304: 0; R_0603_1608Metric

Connections:
+5V: J2.24
BRK_1_IN: J2.13
BRK_2_IN: J2.1
CAN_H: J2.26
CAN_L: J2.27
COS_IN: R291.1, R292.1
COS_IN_IC: J11.7, R292.2
COS_IN_MC: J2.17, R291.2
EMERG_STOP_IN: J2.20
EXC_OUT: R293.1, R294.1
EXC_OUT_IC: J11.6, R294.2
EXC_OUT_MC: J2.29, R293.2
GEAR_DRIVE_IN: J2.9
GEAR_PARKING_IN: J2.31
GEAR_REVERSE_IN: J2.32
GND: J2.25
GND_CAN: J2.28
GND_IN: J2.12
HV_ON_IN: J2.21
IGNITION_ON_IN: J2.19
LEFT_SUPPORT_IN: J2.8
NTC_AW_1: R287.1, R288.1
NTC_AW_1_IC: J11.10, R288.2
NTC_AW_1_MC: J2.3, R287.2
NTC_AW_2: R297.1, R298.1
NTC_AW_2_IC: J11.9, R298.2
NTC_AW_2_MC: J2.15, R297.2
NTC_FW_1: R285.1, R286.1
NTC_FW_1_IC: J11.5, R286.2
NTC_FW_1_MC: J2.4, R285.2
NTC_FW_2: R295.1, R296.1
NTC_FW_2_IC: J11.4, R296.2
NTC_FW_2_MC: J2.16, R295.2
PARK_BREAK_OUT: J2.11
POWER_CONT_OUT: J2.23
PUMP_OUT: J2.33
PWR_ST_PWM_OUT: J2.10
REV_LIGHT_OUT: J2.34
RIGHT_SUPPORT_IN: J2.7
SHUNT_CONT_OUT: J2.22
SIN_IN: R289.1, R290.1
SIN_IN_IC: J11.8, R290.2
SIN_IN_MC: J2.18, R289.2
THR_1_IN: J2.14
THR_2_IN: J2.2
VIN: J2.35
~COS_IN: R301.1, R302.1
~COS_IN_IC: J11.2, R302.2
~COS_IN_MC: J2.5, R301.2
~EXC_OUT: R303.1, R304.1
~EXC_OUT_IC: J11.1, R304.2
~EXC_OUT_MC: J2.30, R303.2
~SIN_IN: R299.1, R300.1
~SIN_IN_IC: J11.3, R300.2
~SIN_IN_MC: J2.6, R299.2
