Alexandr-Filatov/EVD80_MCU_PCB/Mechanical.kicad_sch

## KiCad design Mechanical.kicad_sch (2025-07-10)

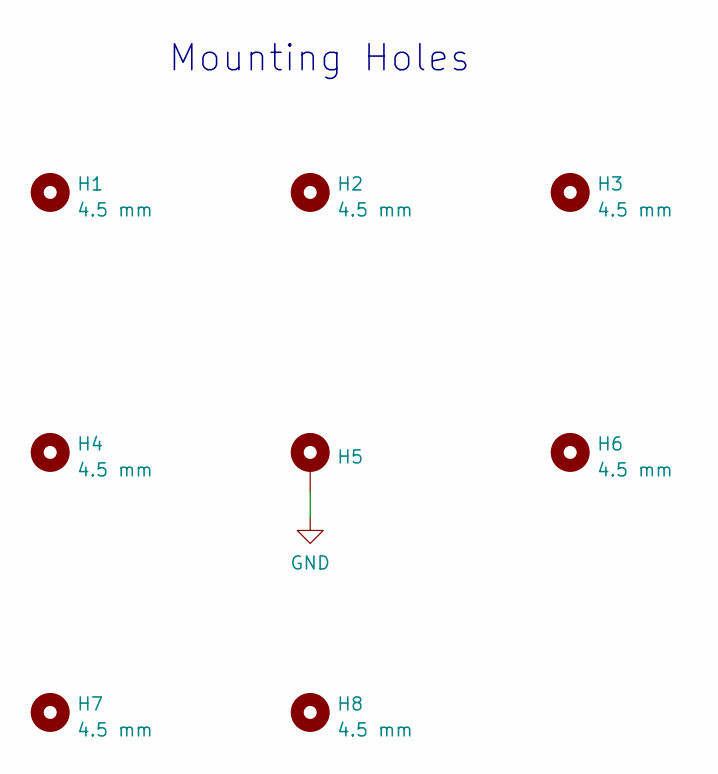
[picture p17: schematic Mechanical.kicad_sch]

Parts:
H1, H2, H3, H4, H6, H7, H8: 4.5 mm; MountingHole_4.5mm
H5: MountingHole_Pad; MountingHole_4.5mm_Pad_Via

Connections:
GND: H5.1

Notes on the sheet:
Mounting Holes
