Alexandr-Filatov/EVD80_MCU_PCB/MotorTemp.kicad_sch

## KiCad design MotorTemp.kicad_sch (2025-07-10)

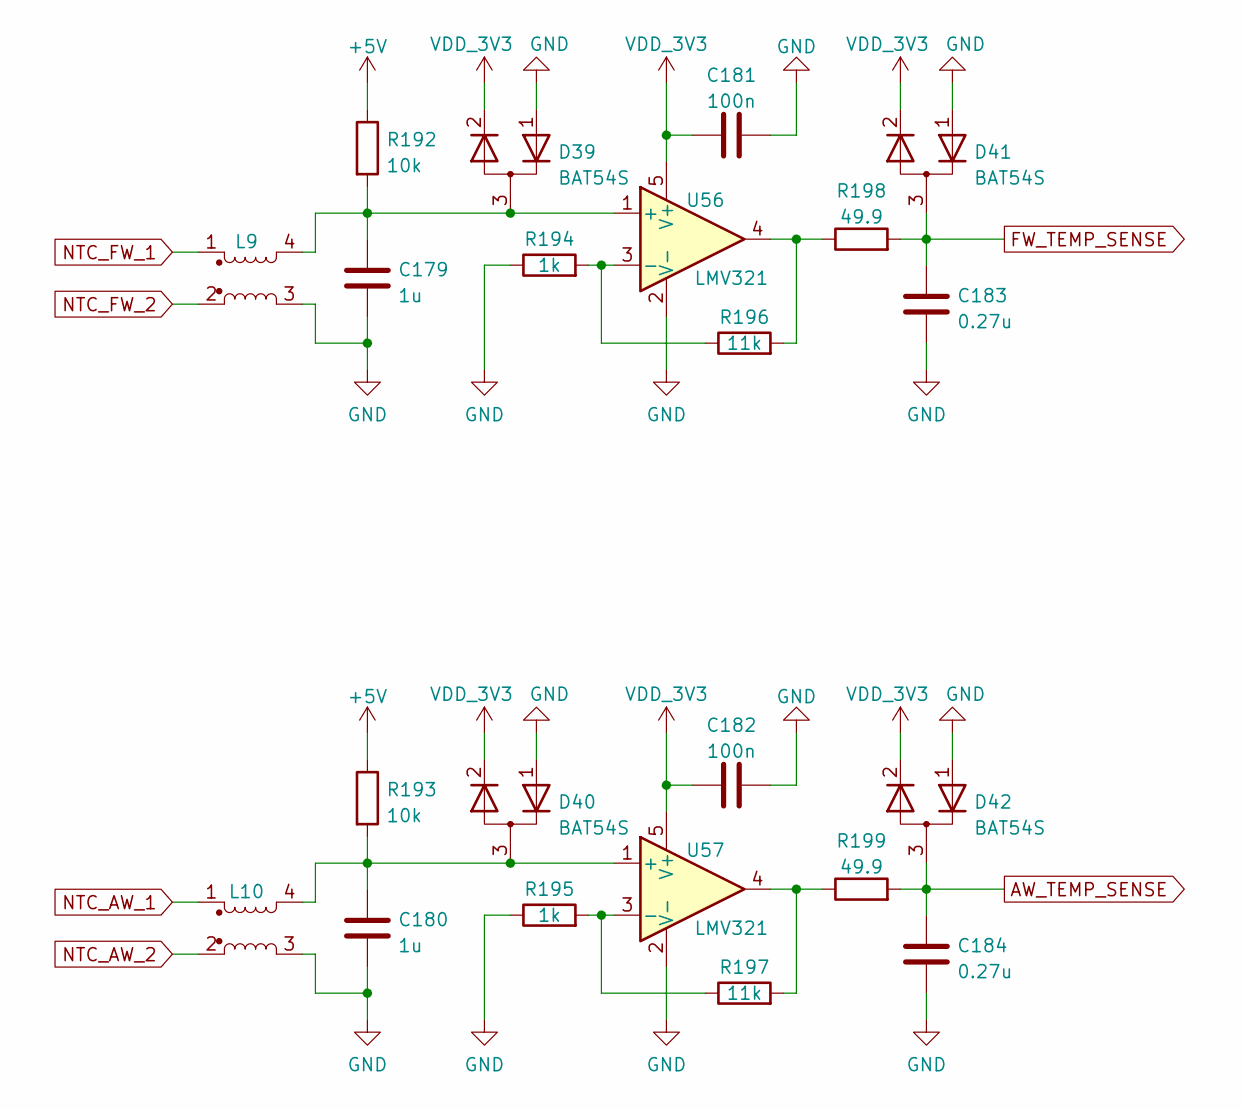
[picture p18: schematic MotorTemp.kicad_sch]

Parts:
C179, C180: 1u; C_0603_1608Metric
C181, C182: 100n; C_0603_1608Metric
C183, C184: 0.27u; C_0603_1608Metric
D39, D40, D41, D42: BAT54S; SOT-23
L9, L10: DR331-513AE; ACM2520-2P_TDK
R192, R193: 10k; R_0603_1608Metric
R194, R195: 1k; R_0603_1608Metric
R196, R197: 11k; R_0603_1608Metric
R198, R199: 49.9; R_0603_1608Metric
U56, U57: LMV321; SOT-23-5

Connections:
+5V: R192.1, R193.1
AW_TEMP_SENSE: C184.1, D42.3 (A), R199.2
FW_TEMP_SENSE: C183.1, D41.3 (A), R198.2
GND: C179.2, C180.2, C181.2, C182.2, C183.2, C184.2, D39.1 (K), D40.1 (K), D41.1 (K), D42.1 (K), L9.3, L10.3, R194.1, R195.1, U56.2 (V-), U57.2 (V-)
NTC_AW_1: L10.1
NTC_AW_2: L10.2
NTC_FW_1: L9.1
NTC_FW_2: L9.2
unnamed: C179.1, D39.3 (A), L9.4, R192.2, U56.1 (+)
unnamed: C180.1, D40.3 (A), L10.4, R193.2, U57.1 (+)
unnamed: R194.2, R196.1, U56.3 (-)
unnamed: R195.2, R197.1, U57.3 (-)
unnamed: R196.2, R198.1, U56.4
unnamed: R197.2, R199.1, U57.4
VDD_3V3: C181.1, C182.1, D39.2 (K), D40.2 (K), D41.2 (K), D42.2 (K), U56.5 (V+), U57.5 (V+)
