Alexandr-Filatov/EVD80_MCU_PCB/PowerModule.kicad_sch

## KiCad design PowerModule.kicad_sch (2025-07-10)

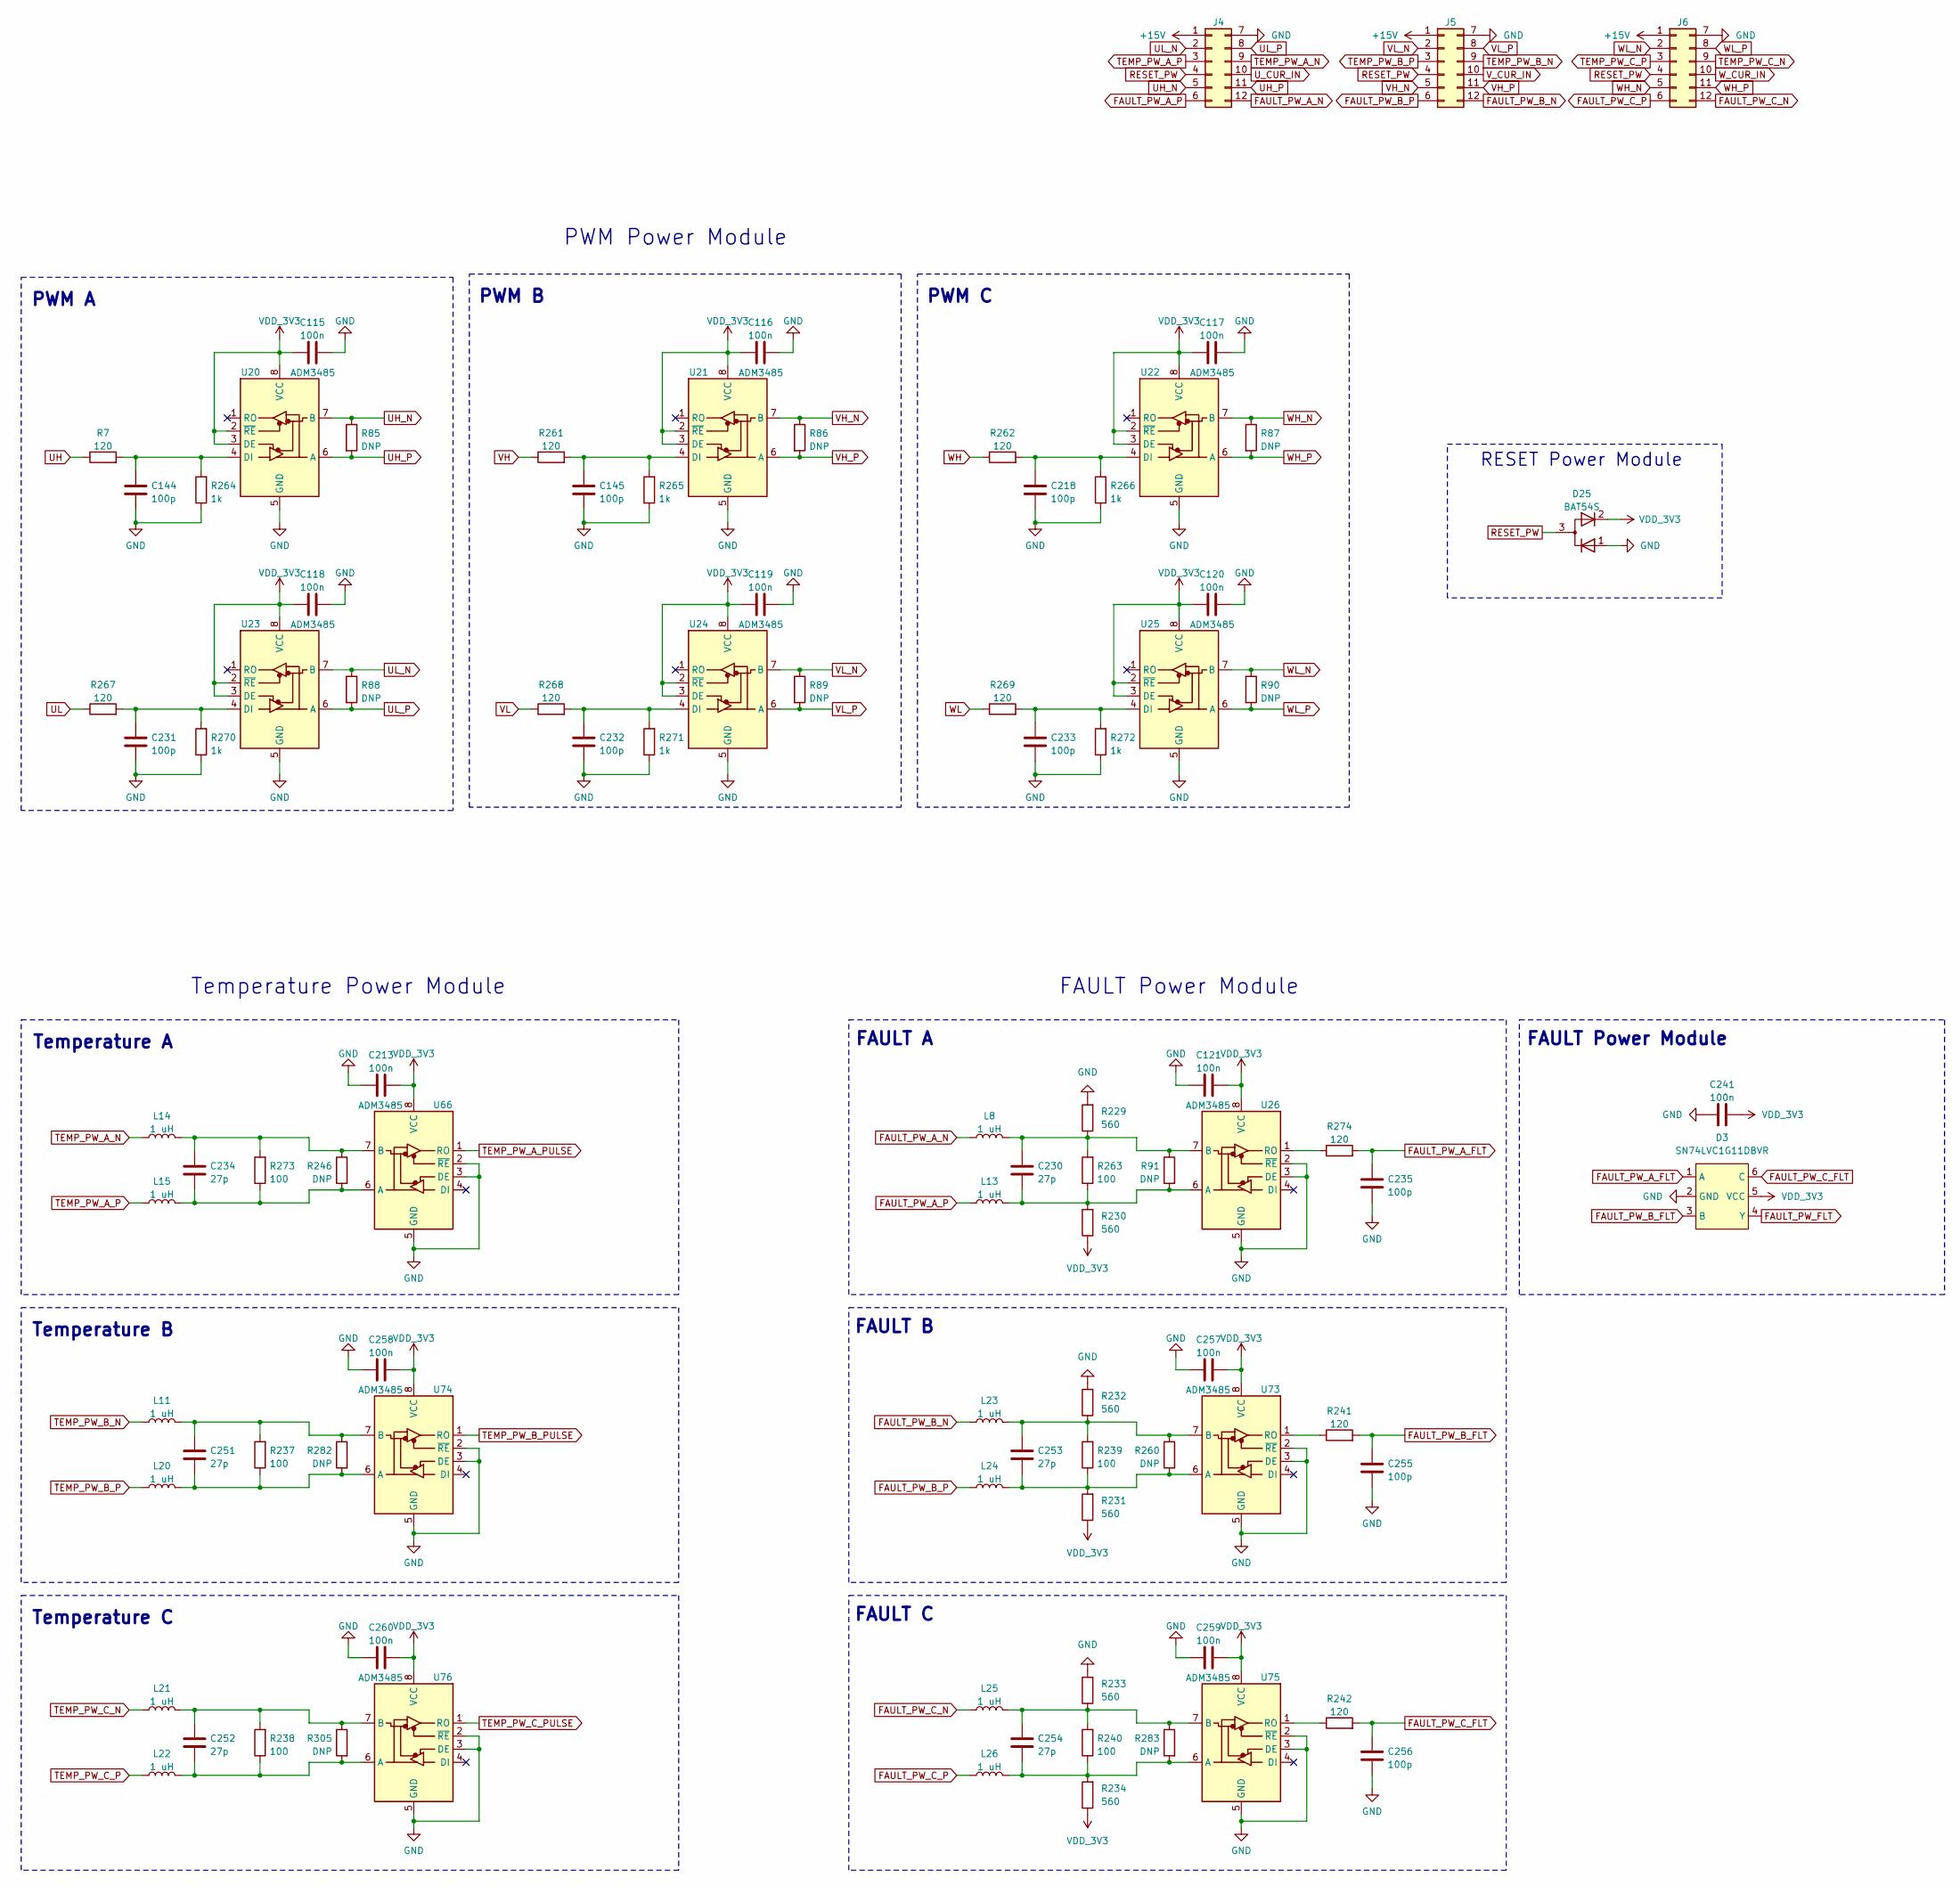
[picture p19: schematic PowerModule.kicad_sch]

Parts:
C115, C116, C117, C118, C119, C120, C121, C213, C257, C258, C259, C260: 100n; C_1206_3216Metric
C144, C145, C218, C231, C232, C233, C235, C255, C256: 100p; C_0603_1608Metric
C230, C234, C251, C252, C253, C254: 27p; C_0603_1608Metric
C241: 100n; C_0805_2012Metric_Pad1.18x1.45mm_HandSolder
D3: SN74LVC1G11DBVR; SOT-23-6_Handsoldering
D25: BAT54S; SOT-23
J4, J5, J6: Molex_Micro-Fit_3.0_43045-1200_2x06_P3.00mm_Horizontal
L8, L11, L13, L14, L15, L20, L21, L22, L23, L24, L25, L26: 1 uH; L_0805_2012Metric
R7, R241, R242, R261, R262, R267, R268, R269, R274: 120; R_0603_1608Metric
R85, R86, R87, R88, R89, R90, R91, R246, R260, R282, R283, R305: DNP; R_0805_2012Metric
R229, R230, R231, R232, R233, R234: 560; R_0603_1608Metric
R237, R238, R239, R240, R263, R273: 100; R_0603_1608Metric
R264, R265, R266, R270, R271, R272: 1k; R_0603_1608Metric
U20, U21, U22, U23, U24, U25, U26, U66, U73, U74, U75, U76: ADM3485; SOIC-8_3.9x4.9mm_P1.27mm

Connections:
+15V: J4.1, J5.1, J6.1
FAULT_PW_A_FLT: C235.1, D3.1 (A), R274.2
FAULT_PW_A_N: J4.12, L8.1
FAULT_PW_A_P: J4.6, L13.1
FAULT_PW_B_FLT: C255.1, D3.3 (B), R241.2
FAULT_PW_B_N: J5.12, L23.1
FAULT_PW_B_P: J5.6, L24.1
FAULT_PW_C_FLT: C256.1, D3.6 (C), R242.2
FAULT_PW_C_N: J6.12, L25.1
FAULT_PW_C_P: J6.6, L26.1
FAULT_PW_FLT: D3.4 (Y)
GND: C115.2, C116.2, C117.2, C118.2, C119.2, C120.2, C121.2, C144.2, C145.2, C213.2, C218.2, C231.2, C232.2, C233.2, C235.2, C241.2, C255.2, C256.2, C257.2, C258.2, C259.2, C260.2, D3.2 (GND), D25.1 (K), J4.7, J5.7, J6.7, R229.2, R232.2, R233.2, R264.1, R265.1, R266.1, R270.1, R271.1, R272.1, U20.5 (GND), U21.5 (GND), U22.5 (GND), U23.5 (GND), U24.5 (GND), U25.5 (GND), U26.2 (~RE), U26.3 (DE), U26.5 (GND), U66.2 (~RE), U66.3 (DE), U66.5 (GND), U73.2 (~RE), U73.3 (DE), U73.5 (GND), U74.2 (~RE), U74.3 (DE), U74.5 (GND), U75.2 (~RE), U75.3 (DE), U75.5 (GND), U76.2 (~RE), U76.3 (DE), U76.5 (GND)
unnamed: C144.1, R7.2, R264.2, U20.4 (DI)
unnamed: C145.1, R261.2, R265.2, U21.4 (DI)
unnamed: C218.1, R262.2, R266.2, U22.4 (DI)
unnamed: C230.1, L8.2, R91.1, R229.1, R263.2, U26.7 (B)
unnamed: C230.2, L13.2, R91.2, R230.2, R263.1, U26.6 (A)
unnamed: C231.1, R267.2, R270.2, U23.4 (DI)
unnamed: C232.1, R268.2, R271.2, U24.4 (DI)
unnamed: C233.1, R269.2, R272.2, U25.4 (DI)
unnamed: C234.1, L14.2, R246.1, R273.2, U66.7 (B)
unnamed: C234.2, L15.2, R246.2, R273.1, U66.6 (A)
unnamed: C251.1, L11.2, R237.2, R282.1, U74.7 (B)
unnamed: C251.2, L20.2, R237.1, R282.2, U74.6 (A)
unnamed: C252.1, L21.2, R238.2, R305.1, U76.7 (B)
unnamed: C252.2, L22.2, R238.1, R305.2, U76.6 (A)
unnamed: C253.1, L23.2, R232.1, R239.2, R260.1, U73.7 (B)
unnamed: C253.2, L24.2, R231.2, R239.1, R260.2, U73.6 (A)
unnamed: C254.1, L25.2, R233.1, R240.2, R283.1, U75.7 (B)
unnamed: C254.2, L26.2, R234.2, R240.1, R283.2, U75.6 (A)
unnamed: R241.1, U73.1 (RO)
unnamed: R242.1, U75.1 (RO)
unnamed: R274.1, U26.1 (RO)
RESET_PW: D25.3 (A), J4.4, J5.4, J6.4
TEMP_PW_A_N: J4.9, L14.1
TEMP_PW_A_P: J4.3, L15.1
TEMP_PW_A_PULSE: U66.1 (RO)
TEMP_PW_B_N: J5.9, L11.1
TEMP_PW_B_P: J5.3, L20.1
TEMP_PW_B_PULSE: U74.1 (RO)
TEMP_PW_C_N: J6.9, L21.1
TEMP_PW_C_P: J6.3, L22.1
TEMP_PW_C_PULSE: U76.1 (RO)
UH: R7.1
UH_N: J4.5, R85.1, U20.7 (B)
UH_P: J4.11, R85.2, U20.6 (A)
UL: R267.1
UL_N: J4.2, R88.1, U23.7 (B)
UL_P: J4.8, R88.2, U23.6 (A)
U_CUR_IN: J4.10
VDD_3V3: C115.1, C116.1, C117.1, C118.1, C119.1, C120.1, C121.1, C213.1, C241.1, C257.1, C258.1, C259.1, C260.1, D3.5 (VCC), D25.2 (K), R230.1, R231.1, R234.1, U20.2 (~RE), U20.3 (DE), U20.8 (VCC), U21.2 (~RE), U21.3 (DE), U21.8 (VCC), U22.2 (~RE), U22.3 (DE), U22.8 (VCC), U23.2 (~RE), U23.3 (DE), U23.8 (VCC), U24.2 (~RE), U24.3 (DE), U24.8 (VCC), U25.2 (~RE), U25.3 (DE), U25.8 (VCC), U26.8 (VCC), U66.8 (VCC), U73.8 (VCC), U74.8 (VCC), U75.8 (VCC), U76.8 (VCC)
VH: R261.1
VH_N: J5.5, R86.1, U21.7 (B)
VH_P: J5.11, R86.2, U21.6 (A)
VL: R268.1
VL_N: J5.2, R89.1, U24.7 (B)
VL_P: J5.8, R89.2, U24.6 (A)
V_CUR_IN: J5.10
WH: R262.1
WH_N: J6.5, R87.1, U22.7 (B)
WH_P: J6.11, R87.2, U22.6 (A)
WL: R269.1
WL_N: J6.2, R90.1, U25.7 (B)
WL_P: J6.8, R90.2, U25.6 (A)
W_CUR_IN: J6.10

Notes on the sheet:
PWM Power Module
FAULT C
FAULT B
PWM B
RESET Power Module
PWM A
Temperature Power Module
Temperature C
Temperature A
PWM C
FAULT Power Module
FAULT A
FAULT Power Module
Temperature B
