Alexandr-Filatov/EVD80_MCU_PCB/PowerTemp.kicad_sch

## KiCad design PowerTemp.kicad_sch (2025-07-10)

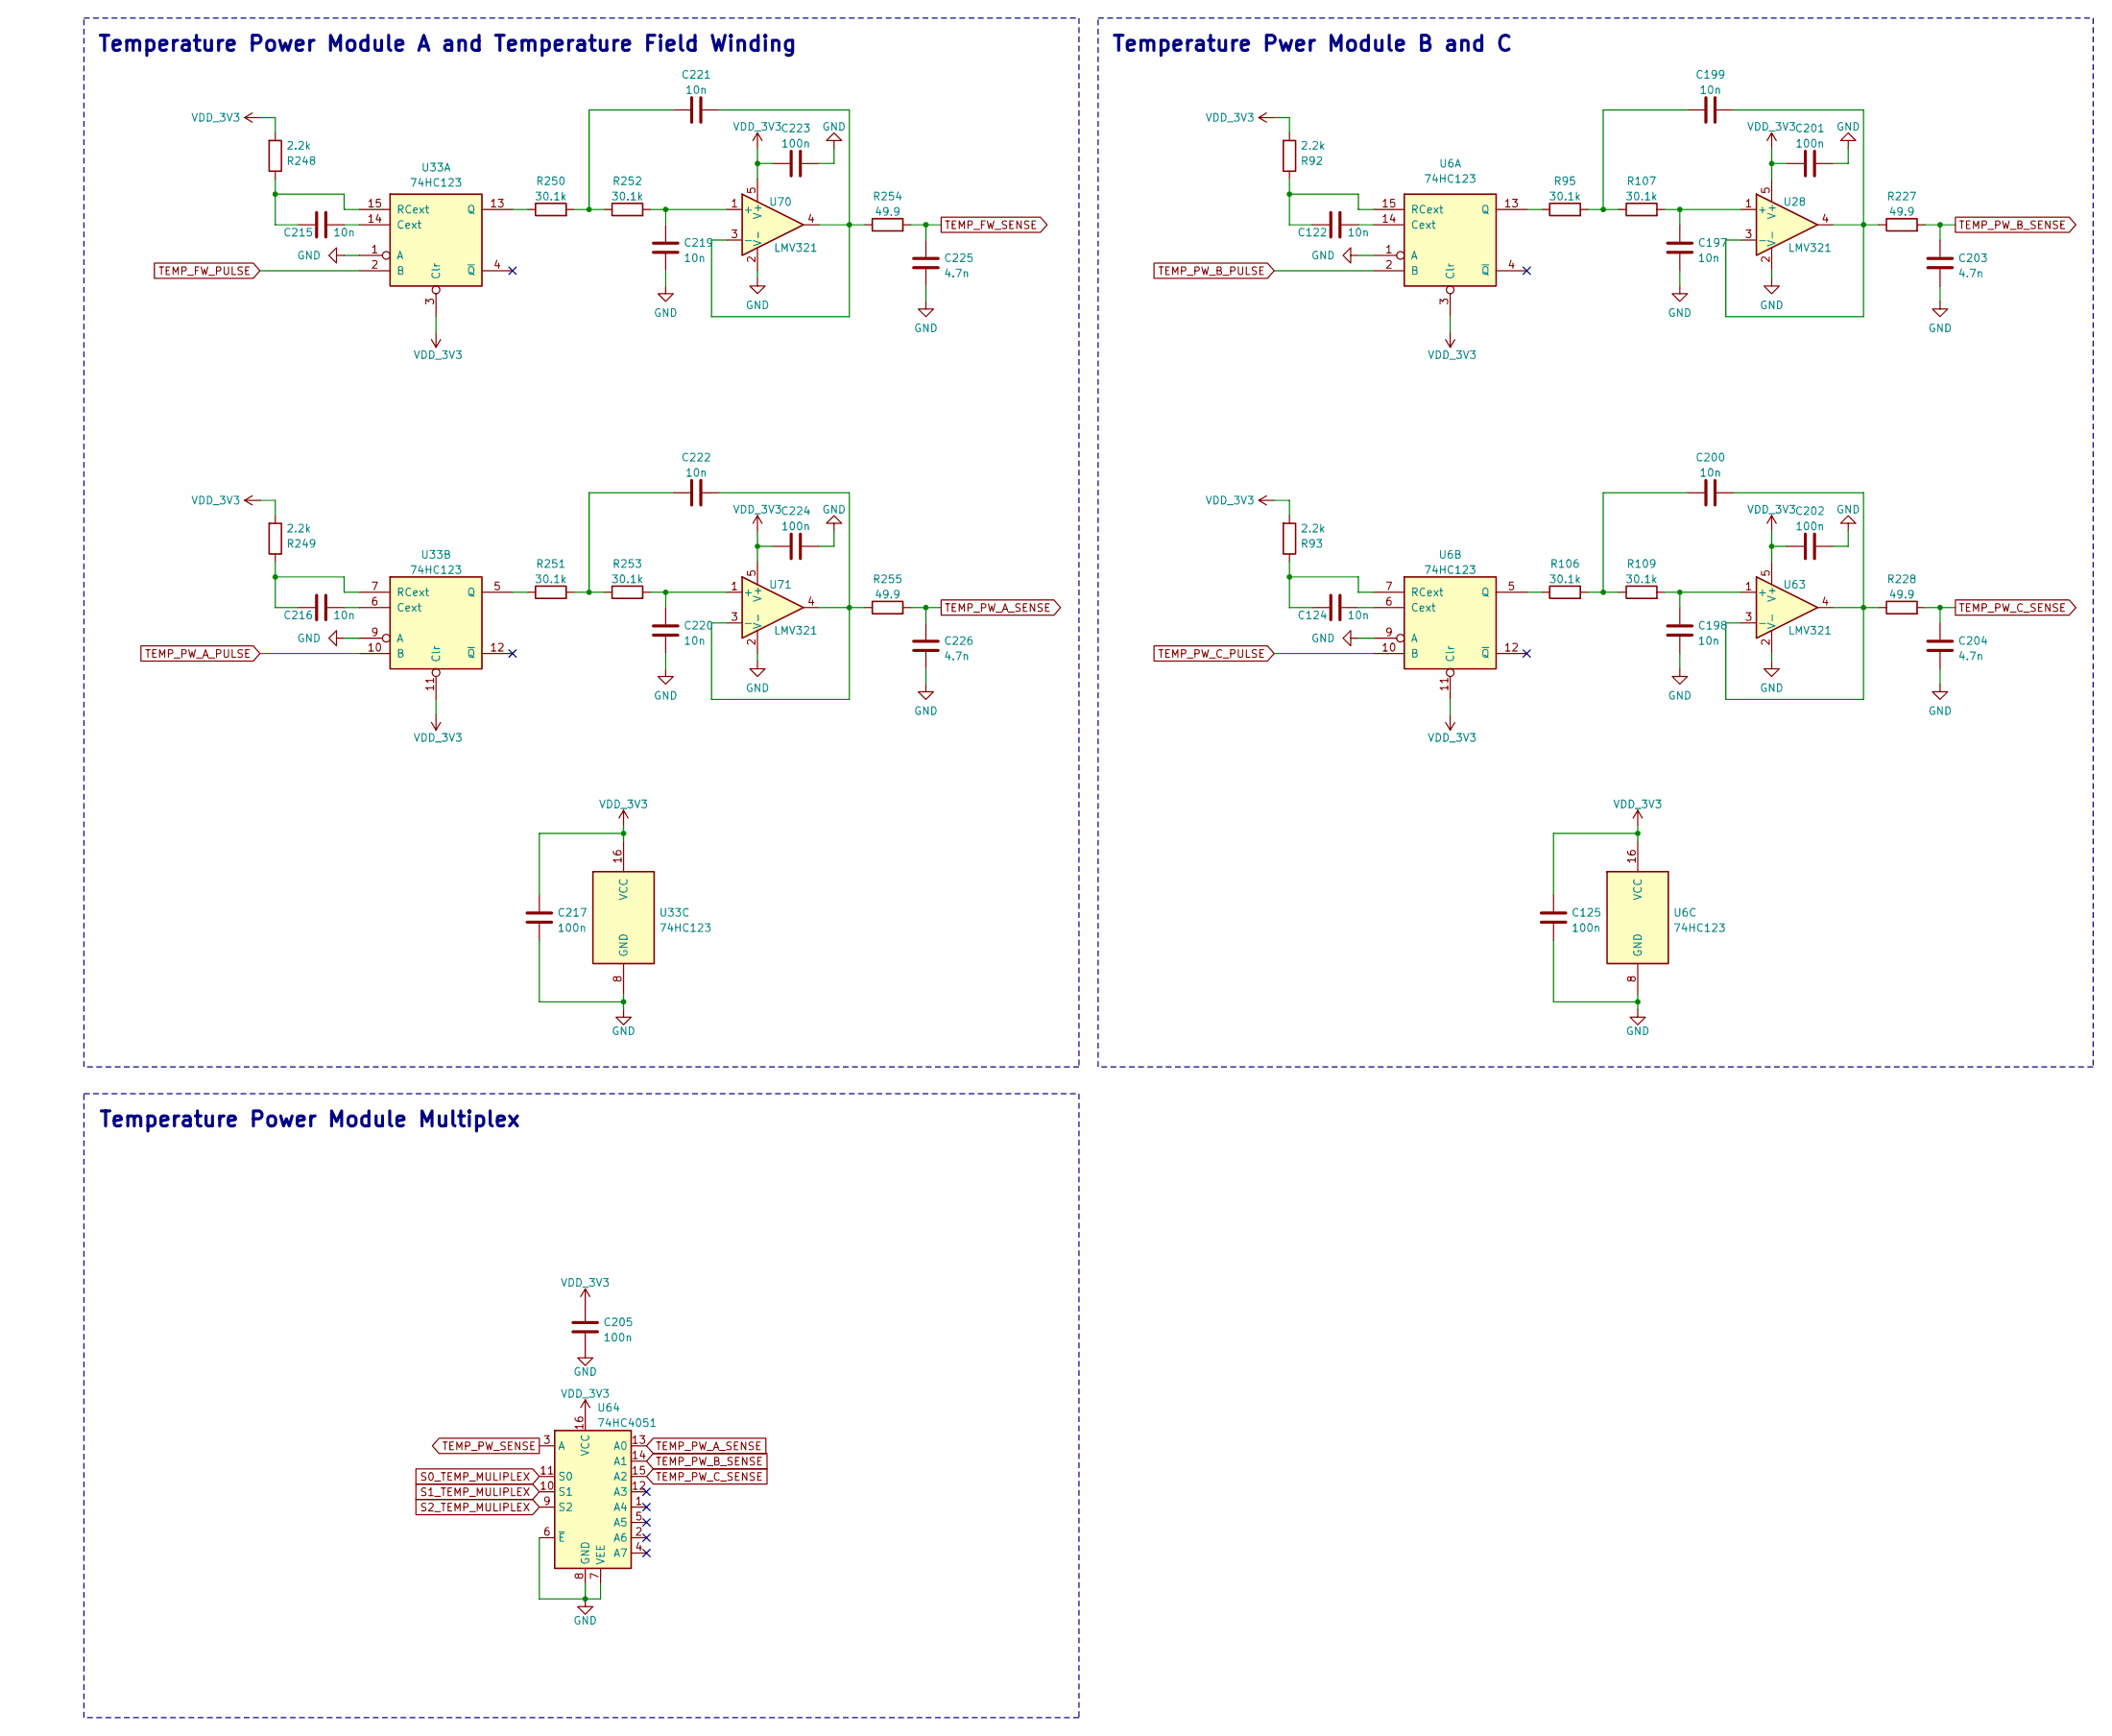
[picture p20: schematic PowerTemp.kicad_sch]

Parts:
C122, C124, C197, C198, C199, C200, C215, C216, C219, C220, C221, C222: 10n; C_0603_1608Metric
C125, C201, C202, C205, C217, C223, C224: 100n; C_0603_1608Metric
C203, C204, C225, C226: 4.7n; C_0603_1608Metric
R92, R93, R248, R249: 2.2k; R_0603_1608Metric
R95, R106, R107, R109, R250, R251, R252, R253: 30.1k; R_0603_1608Metric
R227, R228, R254, R255: 49.9; R_0603_1608Metric
U6, U33: 74HC123; SO-16_3.9x9.9mm_P1.27mm
U28, U63, U70, U71: LMV321; SOT-23-5
U64: 74HC4051; SOIC-16_3.9x9.9mm_P1.27mm

Connections:
GND: C125.1, C197.2, C198.2, C201.2, C202.2, C203.2, C204.2, C205.1, C217.1, C219.2, C220.2, C223.2, C224.2, C225.2, C226.2, U6.1 (A), U6.8 (GND), U6.9 (A), U28.2 (V-), U33.1 (A), U33.8 (GND), U33.9 (A), U63.2 (V-), U64.6 (~E), U64.7 (VEE), U64.8 (GND), U70.2 (V-), U71.2 (V-)
unnamed: C122.1, R92.1, U6.15 (RCext)
unnamed: C122.2, U6.14 (Cext)
unnamed: C124.1, R93.1, U6.7 (RCext)
unnamed: C124.2, U6.6 (Cext)
unnamed: C197.1, R107.2, U28.1 (+)
unnamed: C198.1, R109.2, U63.1 (+)
unnamed: C199.1, R95.2, R107.1
unnamed: C199.2, R227.1, U28.3 (-), U28.4
unnamed: C200.1, R106.2, R109.1
unnamed: C200.2, R228.1, U63.3 (-), U63.4
unnamed: C215.1, R248.1, U33.15 (RCext)
unnamed: C215.2, U33.14 (Cext)
unnamed: C216.1, R249.1, U33.7 (RCext)
unnamed: C216.2, U33.6 (Cext)
unnamed: C219.1, R252.2, U70.1 (+)
unnamed: C220.1, R253.2, U71.1 (+)
unnamed: C221.1, R250.2, R252.1
unnamed: C221.2, R254.1, U70.3 (-), U70.4
unnamed: C222.1, R251.2, R253.1
unnamed: C222.2, R255.1, U71.3 (-), U71.4
unnamed: R95.1, U6.13 (Q)
unnamed: R106.1, U6.5 (Q)
unnamed: R250.1, U33.13 (Q)
unnamed: R251.1, U33.5 (Q)
S0_TEMP_MULIPLEX: U64.11 (S0)
S1_TEMP_MULIPLEX: U64.10 (S1)
S2_TEMP_MULIPLEX: U64.9 (S2)
TEMP_FW_PULSE: U33.2 (B)
TEMP_FW_SENSE: C225.1, R254.2
TEMP_PW_A_PULSE: U33.10 (B)
TEMP_PW_A_SENSE: C226.1, R255.2, U64.13 (A0)
TEMP_PW_B_PULSE: U6.2 (B)
TEMP_PW_B_SENSE: C203.1, R227.2, U64.14 (A1)
TEMP_PW_C_PULSE: U6.10 (B)
TEMP_PW_C_SENSE: C204.1, R228.2, U64.15 (A2)
TEMP_PW_SENSE: U64.3 (A)
VDD_3V3: C125.2, C201.1, C202.1, C205.2, C217.2, C223.1, C224.1, R92.2, R93.2, R248.2, R249.2, U6.3 (Clr), U6.11 (Clr), U6.16 (VCC), U28.5 (V+), U33.3 (Clr), U33.11 (Clr), U33.16 (VCC), U63.5 (V+), U64.16 (VCC), U70.5 (V+), U71.5 (V+)

Notes on the sheet:
Temperature Power Module A and Temperature Field Winding
Temperature Power Module Multiplex
Temperature Pwer Module B and C
