Alexandr-Filatov/EVD80_MCU_PCB/Power_+15V.kicad_sch

## KiCad design Power_+15V.kicad_sch (2025-07-10)

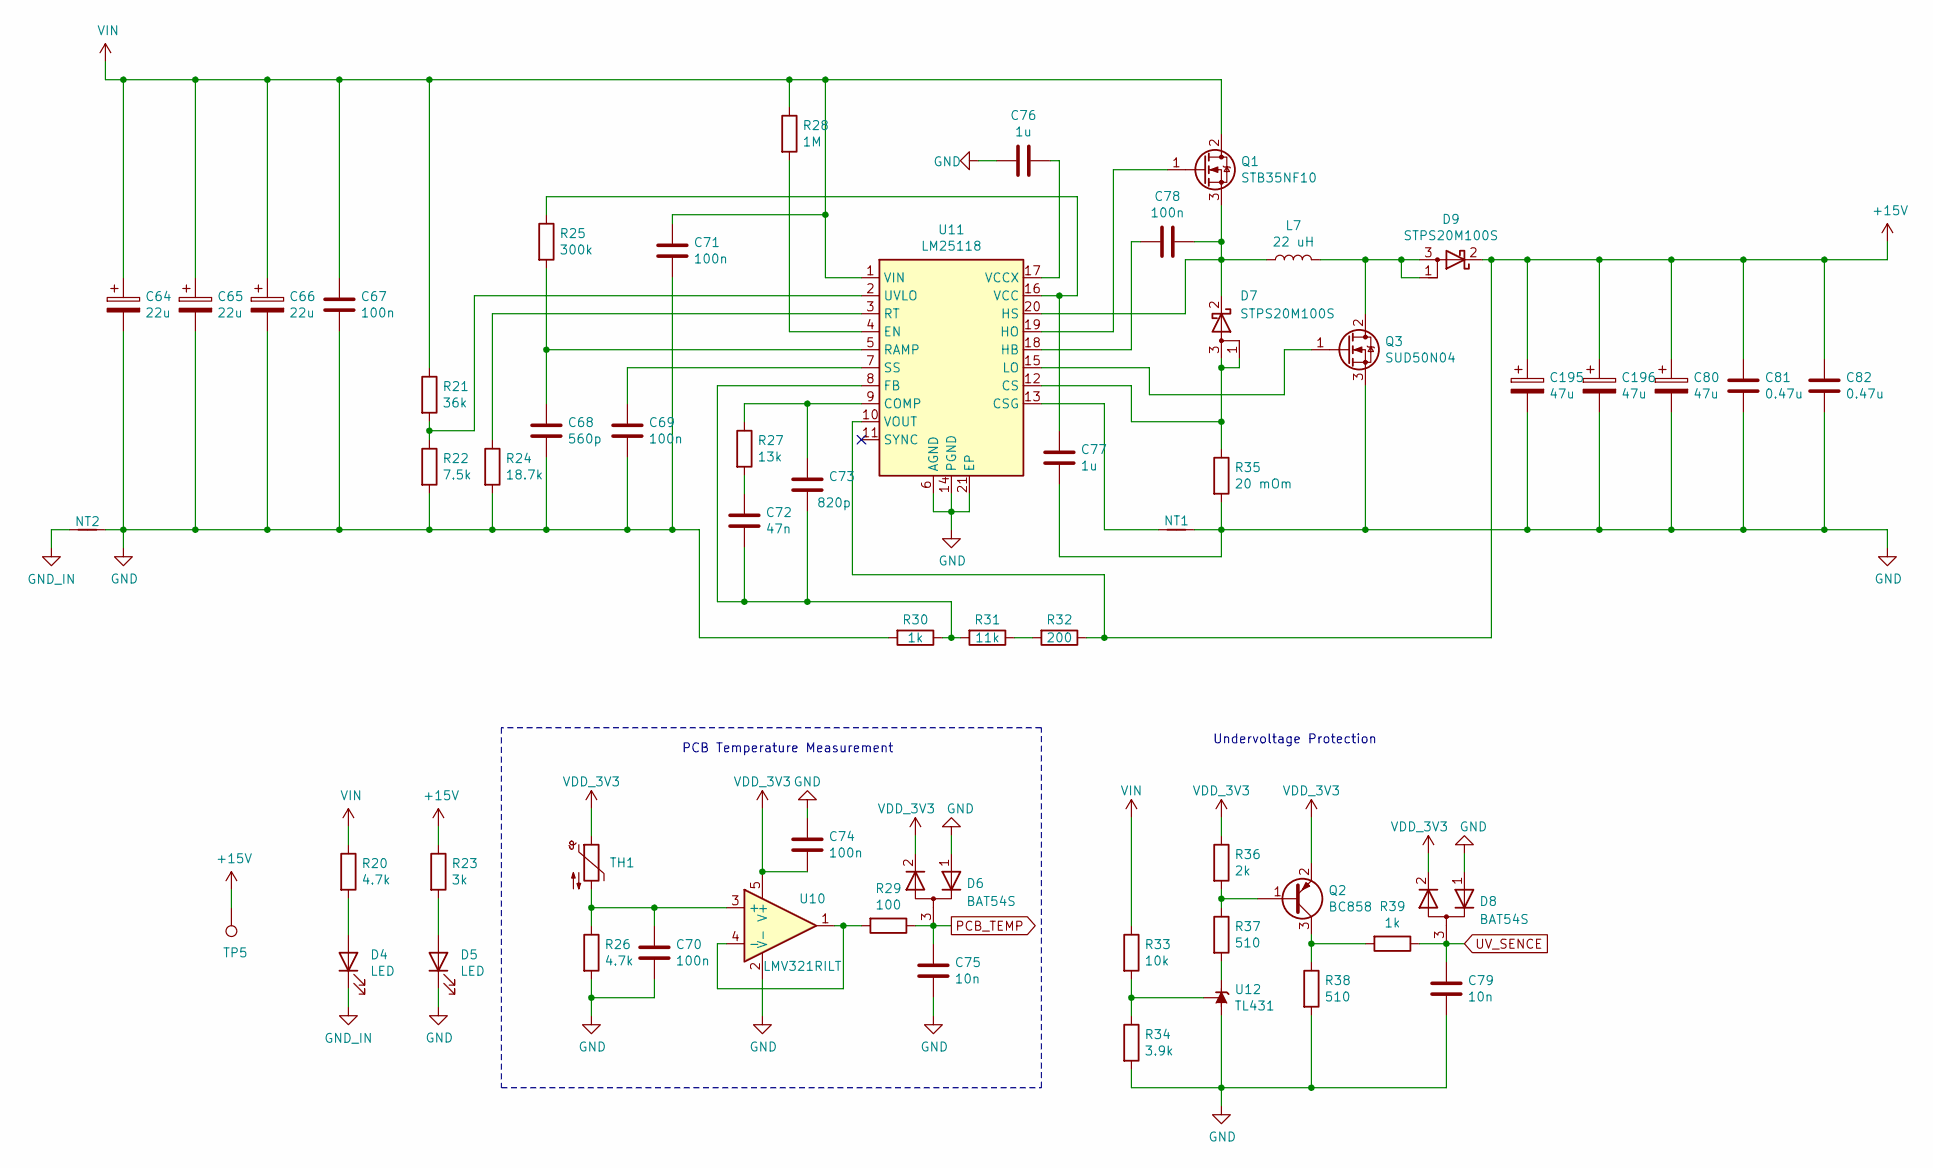
[picture p21: schematic Power_+15V.kicad_sch]

Parts:
C64, C65, C66: 22u; CP_EIA-7360-38_Kemet-E
C67: 100n; C_1206_3216Metric
C68: 560p; C_0603_1608Metric
C69, C70, C74: 100n; C_0603_1608Metric
C71: 100n; C_0805_2012Metric_Pad1.18x1.45mm_HandSolder
C72: 47n; C_0603_1608Metric
C73: 820p; C_0603_1608Metric_Pad1.08x0.95mm_HandSolder
C75, C79: 10n; C_0603_1608Metric
C76, C77: 1u; C_0805_2012Metric_Pad1.18x1.45mm_HandSolder
C78: 100n; C_0603_1608Metric_Pad1.08x0.95mm_HandSolder
C80, C195, C196: 47u; CP_EIA-7360-38_Kemet-E
C81, C82: 0.47u; C_1206_3216Metric
D4, D5: LED; LED_0805_2012Metric_Pad1.15x1.40mm_HandSolder
D6, D8: BAT54S; SOT-23
D7, D9: STPS20M100S; TO-263-2
L7: 22 uH; L_Bourns_SRP1245A
NT1: Net-Tie_2; NetTie-2_SMD_Pad0.5mm
NT2: Net-Tie_2-Device; NetTie-2_SMD_Pad2.0mm
Q1: STB35NF10; TO-263-2
Q2: BC858; SOT-23
Q3: SUD50N04; TO-252-2
R20: 4.7k; R_0805_2012Metric_Pad1.20x1.40mm_HandSolder
R21: 36k; R_0603_1608Metric
R22: 7.5k; R_0603_1608Metric
R23: 3k; R_0805_2012Metric_Pad1.20x1.40mm_HandSolder
R24: 18.7k; R_0603_1608Metric
R25: 300k; R_0603_1608Metric
R26: 4.7k; R_0603_1608Metric
R27: 13k; R_0603_1608Metric
R28: 1M; R_0603_1608Metric
R29: 100; R_0603_1608Metric
R30, R39: 1k; R_0603_1608Metric
R31: 11k; R_0603_1608Metric
R32: 200; R_0603_1608Metric
R33: 10k; R_0603_1608Metric
R34: 3.9k; R_0603_1608Metric
R35: 20 mOm; R_2512_6332Metric
R36: 2k; R_0603_1608Metric
R37, R38: 510; R_0603_1608Metric
TH1: Thermistor_NTC; R_0805_2012Metric
TP5: TestPoint; TestPoint_Plated_Hole_D2.0mm
U10: LMV321RILT; SOT-23-5
U11: LM25118; HTSSOP-20-1EP_4.4x6.5mm_P0.65mm_EP2.85x4mm
U12: TL431; SOT-23

Connections:
+15V: C80.1, C81.1, C82.1, C195.1, C196.1, D9.2 (K), R23.1, R32.1, TP5.1, U11.10 (VOUT)
GND: C64.2, C65.2, C66.2, C67.2, C68.2, C69.2, C70.2, C71.1, C74.1, C75.2, C76.2, C77.2, C79.2, C80.2, C81.2, C82.2, C195.2, C196.2, D5.1 (K), D6.1 (K), D8.1 (K), NT1.2, NT2.2, Q3.3 (S), R22.2, R24.2, R26.2, R30.2, R34.2, R35.2, R38.2, U10.2 (V-), U11.6 (AGND), U11.14 (PGND), U11.21 (EP), U12.3 (A)
GND_IN: D4.1 (K), NT2.1
unnamed: C68.1, R25.2, U11.5 (RAMP)
unnamed: C69.1, U11.7 (SS)
unnamed: C70.1, R26.1, TH1.2, U10.3 (+)
unnamed: C72.1, R27.2
unnamed: C72.2, C73.2, R30.1, R31.2, U11.8 (FB)
unnamed: C73.1, R27.1, U11.9 (COMP)
unnamed: C76.1, U11.17 (VCCX)
unnamed: C77.1, R25.1, U11.16 (VCC)
unnamed: C78.1, D7.2 (K), L7.1, Q1.3 (S), U11.20 (HS)
unnamed: C78.2, U11.18 (HB)
unnamed: D4.2 (A), R20.2
unnamed: D5.2 (A), R23.2
unnamed: D7.1 (A), D7.3 (A), R35.1, U11.12 (CS)
unnamed: D9.1 (A), D9.3 (A), L7.2, Q3.2 (D)
unnamed: NT1.1, U11.13 (CSG)
unnamed: Q1.1 (G), U11.19 (HO)
unnamed: Q2.1 (B), R36.2, R37.1
unnamed: Q2.3 (C), R38.1, R39.2
unnamed: Q3.1 (G), U11.15 (LO)
unnamed: R21.2, R22.1, U11.2 (UVLO)
unnamed: R24.1, U11.3 (RT)
unnamed: R28.2, U11.4 (EN)
unnamed: R29.2, U10.1, U10.4 (-)
unnamed: R31.1, R32.2
unnamed: R33.2, R34.1, U12.2 (REF)
unnamed: R37.2, U12.1 (K)
PCB_TEMP: C75.1, D6.3 (A), R29.1
UV_SENCE: C79.1, D8.3 (A), R39.1
VDD_3V3: C74.2, D6.2 (K), D8.2 (K), Q2.2 (E), R36.1, TH1.1, U10.5 (V+)
VIN: C64.1, C65.1, C66.1, C67.1, C71.2, Q1.2 (D), R20.1, R21.1, R28.1, R33.1, U11.1 (VIN)

Notes on the sheet:
Undervoltage Protection
PCB Temperature Measurement
