Alexandr-Filatov/EVD80_MCU_PCB/Resolver.kicad_sch

## KiCad design Resolver.kicad_sch (2025-07-10)

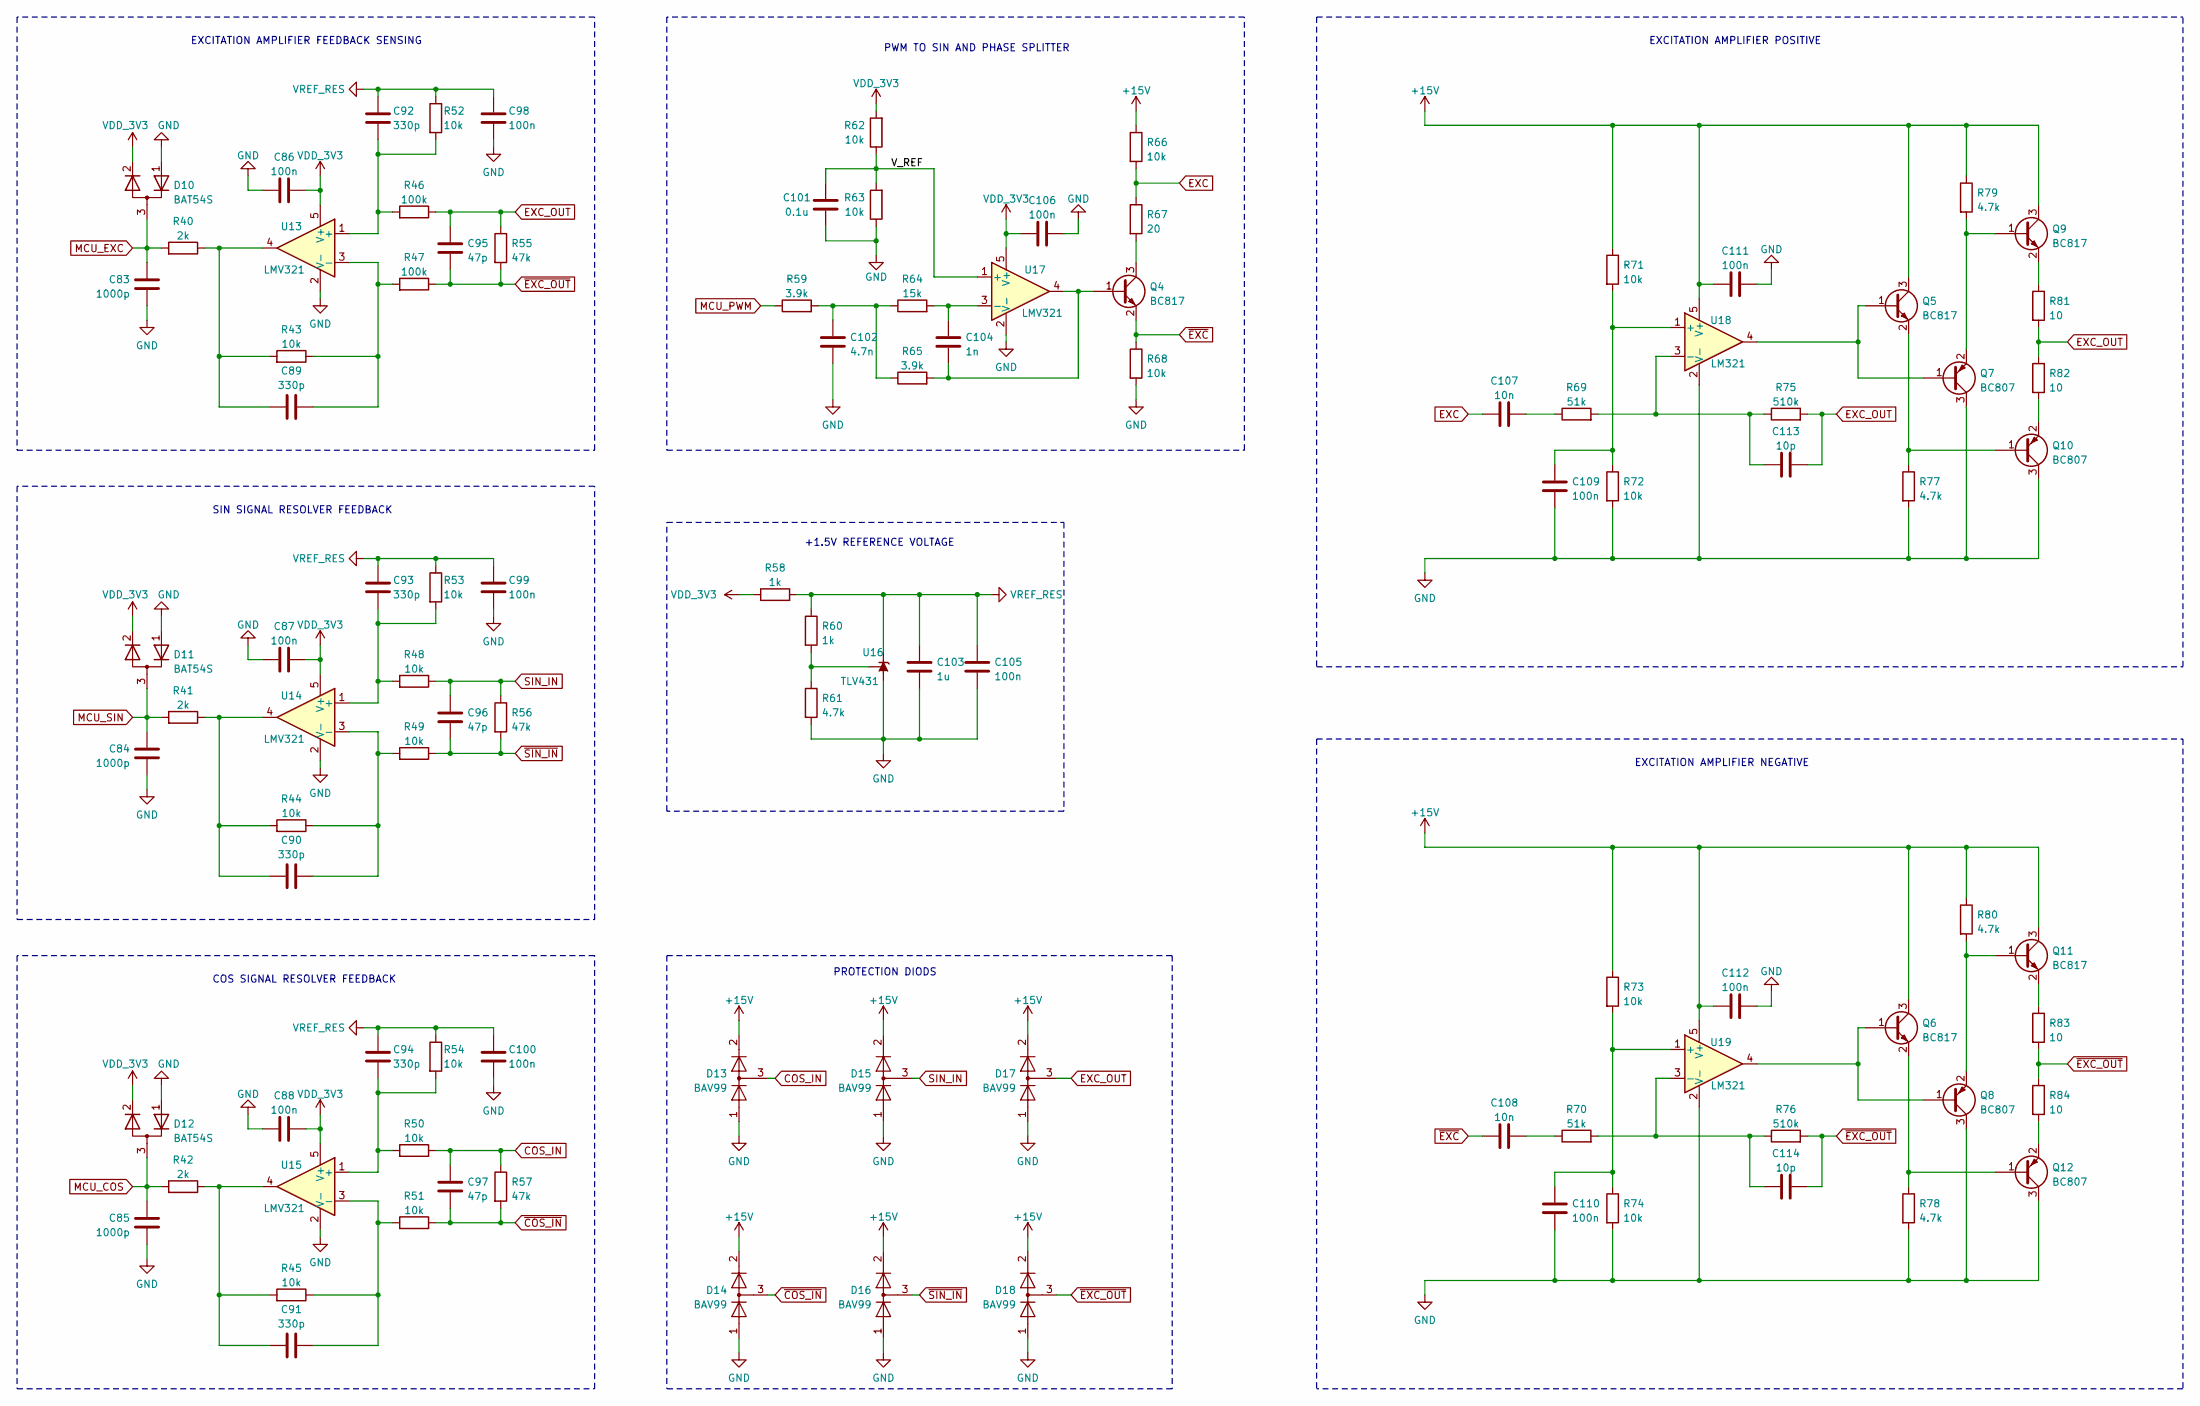
[picture p22: schematic Resolver.kicad_sch]

Parts:
C83, C84, C85: 1000p; C_0603_1608Metric
C86, C87, C88, C98, C99, C100, C105, C106, C109, C110, C111, C112: 100n; C_0603_1608Metric
C89, C90, C91, C92, C93, C94: 330p; C_0603_1608Metric
C95, C96, C97: 47p; C_0603_1608Metric
C101: 0.1u; C_0603_1608Metric
C102: 4.7n; C_0603_1608Metric
C103: 1u; C_0603_1608Metric
C104: 1n; C_0603_1608Metric
C107, C108: 10n; C_0603_1608Metric
C113, C114: 10p; C_0603_1608Metric
D10, D11, D12: BAT54S; SOT-23
D13, D14, D15, D16, D17, D18: BAV99; SOT-23
Q4, Q5, Q6, Q9, Q11: BC817; SOT-23
Q7, Q8, Q10, Q12: BC807; SOT-23
R40, R41, R42: 2k; R_0603_1608Metric
R43, R44, R45, R48, R49, R50, R51, R52, R53, R54, R62, R63, R66, R68, R71, R72, R73, R74: 10k; R_0603_1608Metric
R46, R47: 100k; R_0603_1608Metric
R55, R56, R57: 47k; R_0603_1608Metric
R58, R60: 1k; R_0603_1608Metric
R59, R65: 3.9k; R_0603_1608Metric
R61, R77, R78, R79, R80: 4.7k; R_0603_1608Metric
R64: 15k; R_0603_1608Metric
R67: 20; R_0603_1608Metric
R69, R70: 51k; R_0603_1608Metric
R75, R76: 510k; R_0603_1608Metric
R81, R82, R83, R84: 10; R_0603_1608Metric
U13, U14, U15, U17: LMV321; SOT-23-5
U16: TLV431; SOT-23
U18, U19: LM321; SOT-23-5

Connections:
+15V: C111.1, C112.1, D13.2 (A), D14.2 (A), D15.2 (A), D16.2 (A), D17.2 (A), D18.2 (A), Q5.3 (C), Q6.3 (C), Q9.3 (C), Q11.3 (C), R66.1, R71.1, R73.1, R79.1, R80.1, U18.5 (V+), U19.5 (V+)
COS_IN: C97.1, D13.3 (K), R50.1, R57.1
EXC: C107.1, R66.2, R67.1
EXC_OUT: C95.1, C113.2, D17.3 (K), R46.1, R55.1, R75.2, R81.2, R82.1
GND: C83.1, C84.1, C85.1, C86.2, C87.2, C88.2, C98.2, C99.2, C100.2, C101.2, C102.2, C103.2, C105.2, C106.2, C109.2, C110.2, C111.2, C112.2, D10.1 (K), D11.1 (K), D12.1 (K), D13.1 (K), D14.1 (K), D15.1 (K), D16.1 (K), D17.1 (K), D18.1 (K), Q7.3 (C), Q8.3 (C), Q10.3 (C), Q12.3 (C), R61.2, R63.1, R68.2, R72.2, R74.2, R77.2, R78.2, U13.2 (V-), U14.2 (V-), U15.2 (V-), U16.3 (A), U17.2 (V-), U18.2 (V-), U19.2 (V-)
MCU_COS: C85.2, D12.3 (A), R42.2
MCU_EXC: C83.2, D10.3 (A), R40.2
MCU_PWM: R59.1
MCU_SIN: C84.2, D11.3 (A), R41.2
unnamed: C89.1, R40.1, R43.2, U13.4
unnamed: C89.2, R43.1, R47.2, U13.3 (-)
unnamed: C90.1, R41.1, R44.2, U14.4
unnamed: C90.2, R44.1, R49.2, U14.3 (-)
unnamed: C91.1, R42.1, R45.2, U15.4
unnamed: C91.2, R45.1, R51.2, U15.3 (-)
unnamed: C92.2, R46.2, R52.2, U13.1 (+)
unnamed: C93.2, R48.2, R53.2, U14.1 (+)
unnamed: C94.2, R50.2, R54.2, U15.1 (+)
unnamed: C102.1, R59.2, R64.1, R65.1
unnamed: C104.1, R64.2, U17.3 (-)
unnamed: C104.2, Q4.1 (B), R65.2, U17.4
unnamed: C107.2, R69.1
unnamed: C108.2, R70.1
unnamed: C109.1, R71.2, R72.1, U18.1 (+)
unnamed: C110.1, R73.2, R74.1, U19.1 (+)
unnamed: C113.1, R69.2, R75.1, U18.3 (-)
unnamed: C114.1, R70.2, R76.1, U19.3 (-)
unnamed: Q4.3 (C), R67.2
unnamed: Q5.1 (B), Q7.1 (B), U18.4
unnamed: Q6.1 (B), Q8.1 (B), U19.4
unnamed: Q7.2 (E), Q9.1 (B), R79.2
unnamed: Q9.2 (E), R81.1
unnamed: Q5.2 (E), Q10.1 (B), R77.1
unnamed: Q10.2 (E), R82.2
unnamed: Q8.2 (E), Q11.1 (B), R80.2
unnamed: Q11.2 (E), R83.1
unnamed: Q6.2 (E), Q12.1 (B), R78.1
unnamed: Q12.2 (E), R84.2
unnamed: R60.2, R61.1, U16.1 (REF)
SIN_IN: C96.1, D15.3 (K), R48.1, R56.1
VDD_3V3: C86.1, C87.1, C88.1, C106.1, D10.2 (K), D11.2 (K), D12.2 (K), R58.1, R62.2, U13.5 (V+), U14.5 (V+), U15.5 (V+), U17.5 (V+)
VREF_RES: C92.1, C93.1, C94.1, C98.1, C99.1, C100.1, C103.1, C105.1, R52.1, R53.1, R54.1, R58.2, R60.1, U16.2 (K)
V_REF: C101.1, R62.1, R63.2, U17.1 (+)
~COS_IN: C97.2, D14.3 (K), R51.1, R57.2
~EXC_OUT: C95.2, C114.2, D18.3 (K), R47.1, R55.2, R76.2, R83.2, R84.1
~EXC: C108.1, Q4.2 (E), R68.1
~SIN_IN: C96.2, D16.3 (K), R49.1, R56.2

Notes on the sheet:
+1.5V REFERENCE VOLTAGE
EXCITATION AMPLIFIER POSITIVE
COS SIGNAL RESOLVER FEEDBACK
EXCITATION AMPLIFIER FEEDBACK SENSING
SIN SIGNAL RESOLVER FEEDBACK
EXCITATION AMPLIFIER NEGATIVE
PROTECTION DIODS
PWM TO SIN AND PHASE SPLITTER
