Alexandr-Filatov/EVD80_MCU_PCB/VoltageMeas.kicad_sch

## KiCad design VoltageMeas.kicad_sch (2025-07-10)

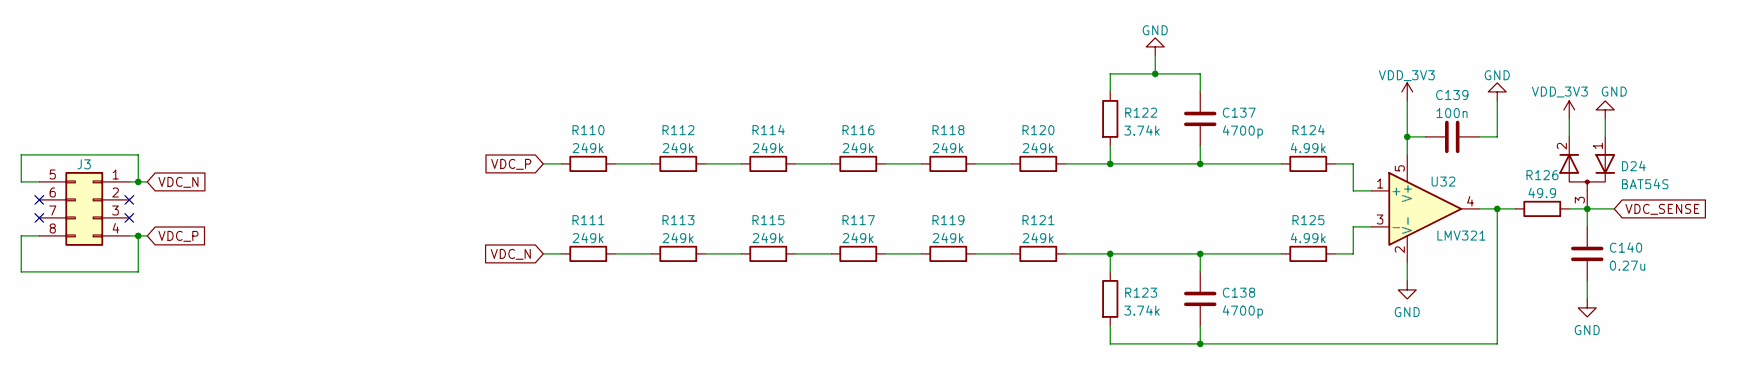
[picture p23: schematic VoltageMeas.kicad_sch]

Parts:
C137, C138: 4700p; C_0603_1608Metric
C139: 100n; C_0603_1608Metric
C140: 0.27u; C_0603_1608Metric
D24: BAT54S; SOT-23
J3: Conn_02x04_Top_Bottom; Molex_Micro-Fit_3.0_43045-0800_2x04_P3.00mm_Horizontal
R110, R111, R112, R113, R114, R115, R116, R117, R118, R119, R120, R121: 249k; R_1206_3216Metric
R122, R123: 3.74k; R_0603_1608Metric
R124, R125: 4.99k; R_0603_1608Metric
R126: 49.9; R_0603_1608Metric
U32: LMV321; SOT-23-5

Connections:
GND: C137.1, C139.2, C140.2, D24.1 (K), R122.1, U32.2 (V-)
unnamed: C137.2, R120.2, R122.2, R124.1
unnamed: C138.1, R121.2, R123.1, R125.1
unnamed: C138.2, R123.2, R126.1, U32.4
unnamed: R110.2, R112.1
unnamed: R111.2, R113.1
unnamed: R112.2, R114.1
unnamed: R113.2, R115.1
unnamed: R114.2, R116.1
unnamed: R115.2, R117.1
unnamed: R116.2, R118.1
unnamed: R117.2, R119.1
unnamed: R118.2, R120.1
unnamed: R119.2, R121.1
unnamed: R124.2, U32.1 (+)
unnamed: R125.2, U32.3 (-)
VDC_N: J3.1, J3.5, R111.1
VDC_P: J3.4, J3.8, R110.1
VDC_SENSE: C140.1, D24.3 (A), R126.2
VDD_3V3: C139.1, D24.2 (K), U32.5 (V+)
