Alexandr-Filatov/EVD80_MCU_PCB/(commit log)

2024-10-10 Base commit
    [AnalogInputs.kicad_sch, BOM.xls, Can.kicad_sch, CurrentMeas.kicad_sch, DiscreteInputs.kicad_sch, DiscreteOutputs.kicad_sch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]
2024-10-14 Изменения в схеме: убрал разъемы датчиков тока
    [AnalogInputs.kicad_sch, Can.kicad_sch, CurrentMeas.kicad_sch, DiscreteInputs.kicad_sch, DiscreteOutputs.kicad_sch, EVD80_ControlBoard.kicad_sch, FieldWinding.kicad_sch, InsulationMeas.kicad_sch]
2024-10-14 Изменения в схеме: поменял направление меток
    [AnalogInputs.kicad_sch, CurrentMeas.kicad_sch, PowerModule.kicad_sch]
2024-10-17 Исправление: в схеме добавил обработку температур, изменил обработку токов
    [CurrentMeas.kicad_sch, MCU_IO.kicad_sch, PowerModule.kicad_sch, PowerTemp.kicad_sch, Power_+15V.kicad_sch]
2024-11-04 Добавления: Расставил все на плате
    [EVD80_ControlBoard.kicad_sch, MCU_IO.kicad_sch, PowerTemp.kicad_sch]
2024-11-07 Добавления: добавил шелкографию Rev C
2024-11-10 Изменения: развел все
    [Can.kicad_sch, EVD80_ControlBoard.kicad_sch, MCU_IO.kicad_sch, Power_+15V.kicad_sch]
2024-11-12 REV C: отправил на проверку в резонит
    [EVD80_ControlBoard-B_Cu.gbr, EVD80_ControlBoard-B_Mask.gbr, EVD80_ControlBoard-B_Paste.gbp, EVD80_ControlBoard-B_Paste.gbr, EVD80_ControlBoard-B_Silks.gbr, EVD80_ControlBoard-Edge_Cuts.gbr, EVD80_ControlBoard-Edge_Cuts.gm1, EVD80_ControlBoard-F_Cu.gbr]
2024-11-13 Изменения: добавил 3или для фолтов трёхфазного модуля
    [EVD80_ControlBoard-B_Cu.gbr, EVD80_ControlBoard-B_Mask.gbr, EVD80_ControlBoard-B_Paste.gbr, EVD80_ControlBoard-B_Silkscreen.gbr, EVD80_ControlBoard-Edge_Cuts.gbr, EVD80_ControlBoard-F_Cu.gbr, EVD80_ControlBoard-F_Mask.gbr, EVD80_ControlBoard-F_Paste.gbr]
2024-11-19 Изменения: добавл BOM, оформляю заказ
    [DiscreteOutputs.kicad_sch, EVD80_ControlBoard.xls, InsulationMeas.kicad_sch, Power_+15V.kicad_sch]
2024-11-26 Изменения: испарвил номиналы на схеме в соответствии с BOM
    [Can.kicad_sch, DiscreteInputs.kicad_sch, EVD80_ControlBoard.xls, InsulationMeas.kicad_sch]
2024-11-27 Изменения: добавил схему в папку Docs
    [BOM.xls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]
2024-11-28 Изменения: добавил монтажную схему в Docs
2024-12-16 Изменения: исправил номера посадочных мест на шелкографии
2025-05-28 Изменения: исправил ошибку с дроселями в BOM
    [EVD80_ControlBoard.xls]
2025-06-27 REVC: добавил файл с температурами компонентов
    [temperature.xls]
2025-07-10 REV_C: добавил СБ и 3D модели
2025-07-10 REV_C: добавил Э3
    [AnalogInputs.kicad_sch, Can.kicad_sch, CurrentMeas.kicad_sch, DiscreteInputs.kicad_sch, DiscreteOutputs.kicad_sch, EVD80_ControlBoard.kicad_sch, FieldWinding.kicad_sch, InsulationMeas.kicad_sch]
2025-07-10 REV_C: исправил децимальник в углу
2025-07-14 REV_C: исправил Э3 и СБ
    [EVD80_ControlBoard.kicad_sch]
2025-07-14 REV_C: переименовал Э3
2025-07-14 REV_C: исправил СБ
2025-07-14 REV_C: исправил СБ третий раз
2025-07-16 REV_C: сделал спецификацию и оформил BOM
    [EVD80_ControlBoard.xls, НВЦТ.EVP150-2-1.3000.100.dwg]
2025-07-16 REV_C: исправил спеку
    [НВЦТ.EVP150-2-1.3000.100.dwg]
